alephobjects/taz-toolhead-javelin/photos/test pandas/DSC_0005.JPG

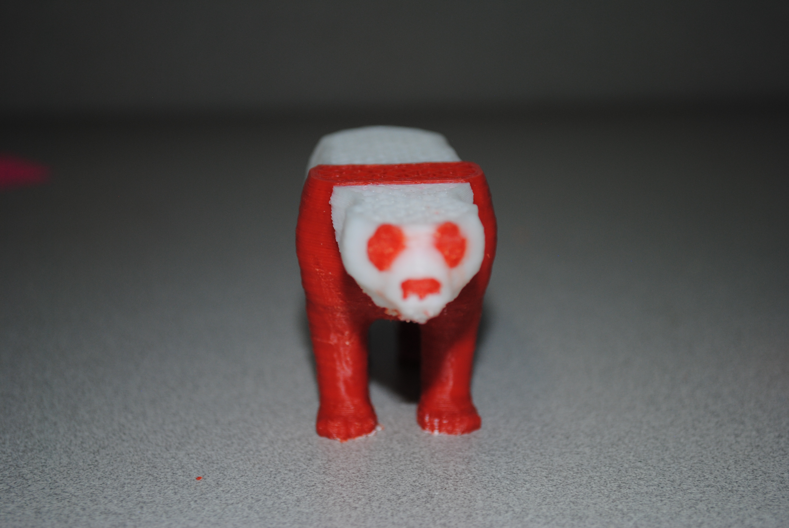
photos/test pandas/DSC_0005.JPG
