alephobjects/taz-toolhead-javelin/photos/Test die/DSC_0011.JPG

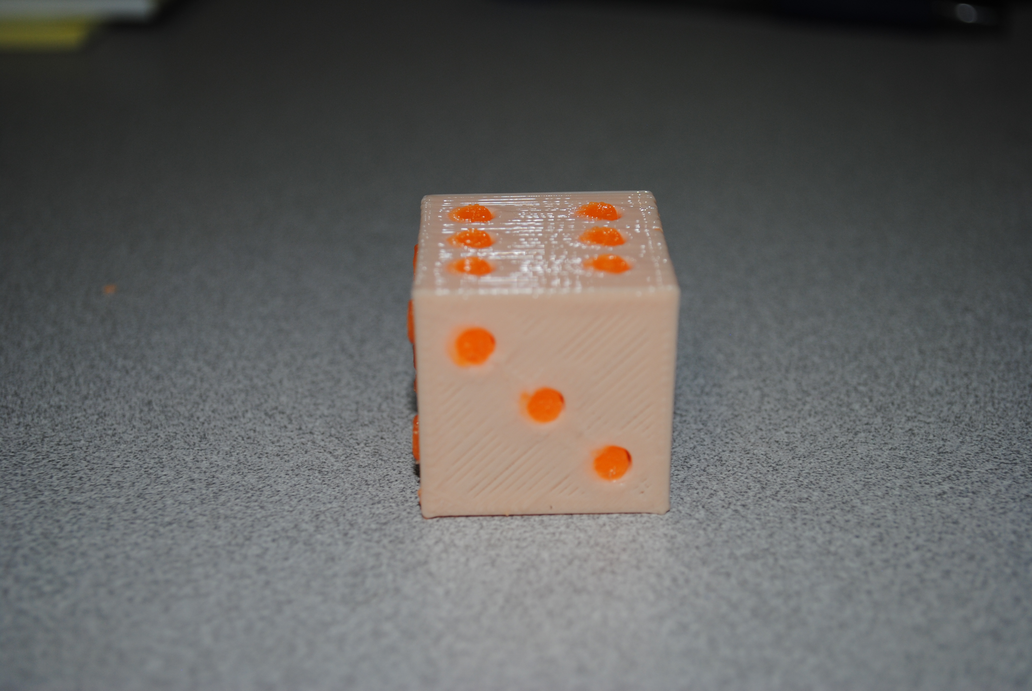
photos/Test die/DSC_0011.JPG
