alephobjects/taz-toolhead-javelin/production_docs/harnesses/wire_harness_listing.odt

- Blower harness
  - Cut blower wires to 50mm
  - Cut heat shrink to 20mm
  - Black and red 24ga wires cut to 230mm
- fan harness
  - Cut fan wires to 50mm
  - Cut heat shrink to 20mm
  - Black and red 24ga wires cut to 185mm
- Hexagon wiring
  - 24V cartridge
    - 225mm
  - Thermistor
    - 215mm
- motor wire lengths
  - Cut both half height motors to 130mm
  - Cover with shielding cut to 120mm
- Panduit Lengths
  - 2x 1/4” panduit cut to 170mm
- Juniperberry cable harness
