alephobjects/taz-toolhead-javelin/photos/2_color_octo/IMG_0299.JPG

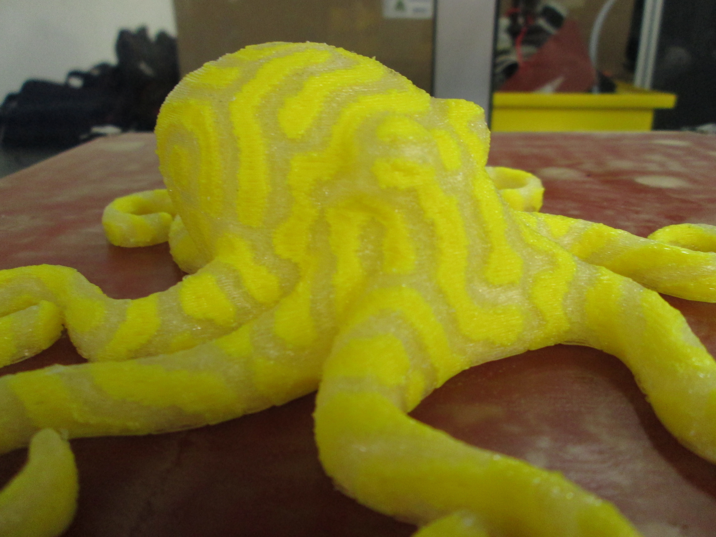
photos/2_color_octo/IMG_0299.JPG
