alephobjects/taz-toolhead-javelin/photos/2_color_octo/IMG_0300.JPG

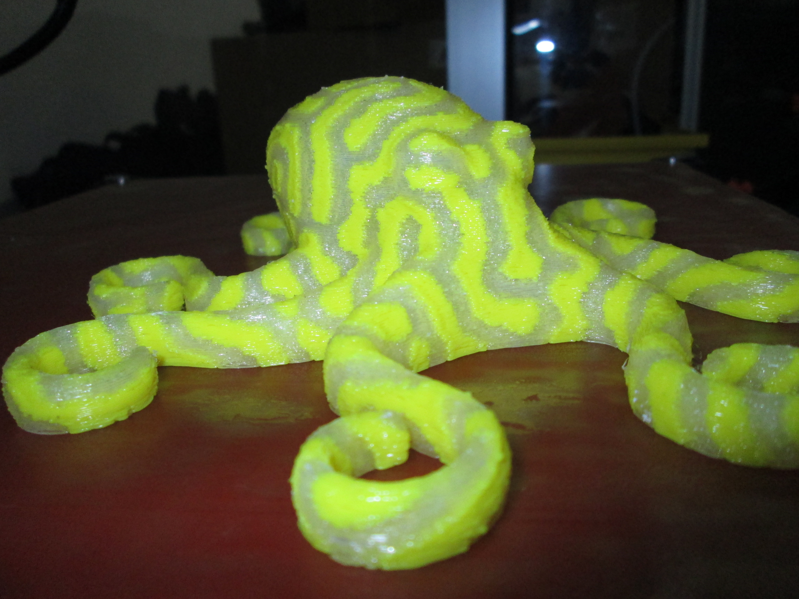
photos/2_color_octo/IMG_0300.JPG
