alephobjects/taz-toolhead-javelin/photos/2_color_octo/IMG_0301.JPG

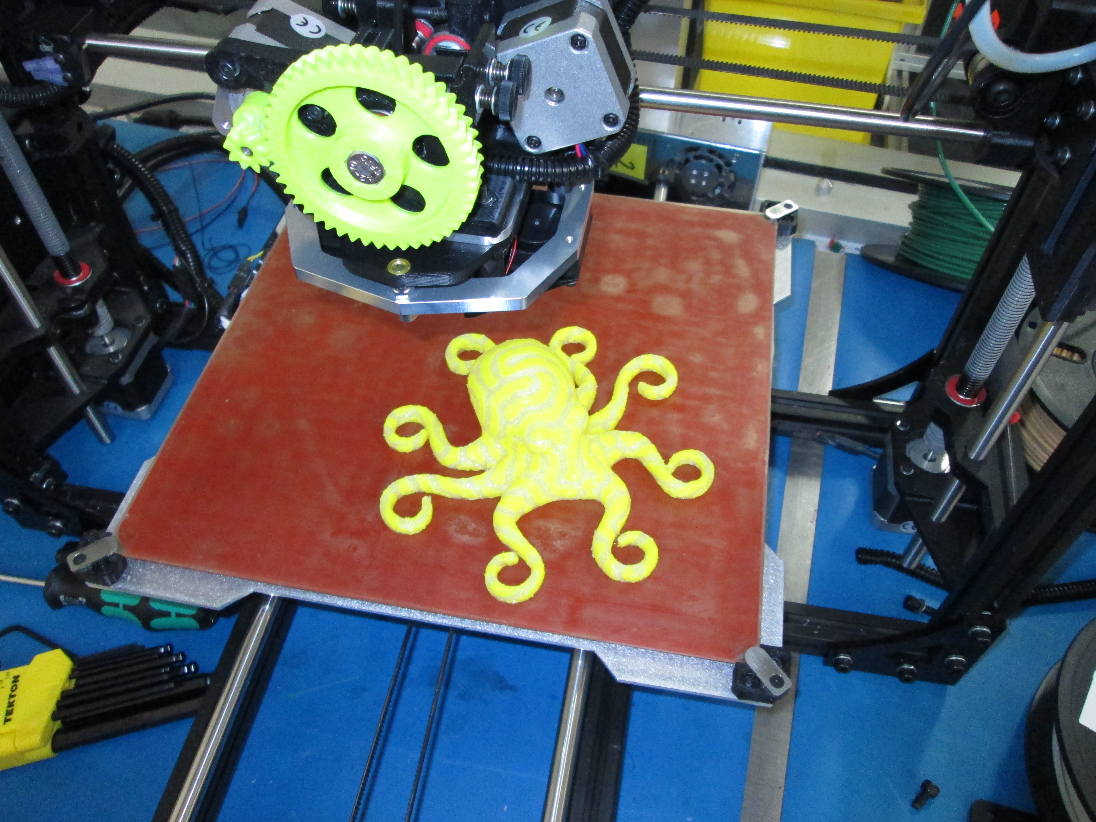
photos/2_color_octo/IMG_0301.JPG
