alephobjects/taz-toolhead-javelin/photos/bunny_in_egg/IMG_0385.JPG

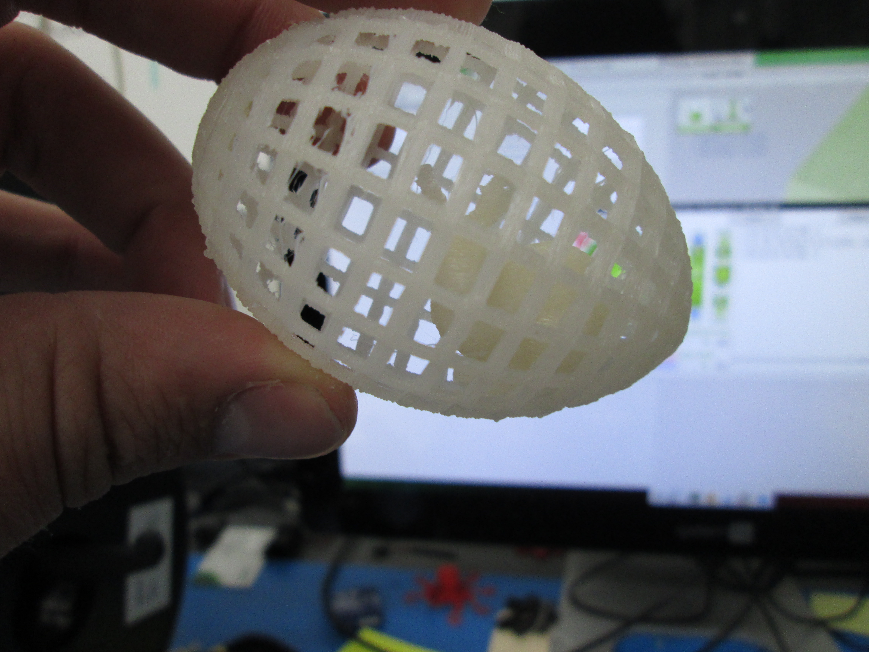
photos/bunny_in_egg/IMG_0385.JPG
