alephobjects/taz-toolhead-javelin/photos/gyroid/IMG_0386.JPG

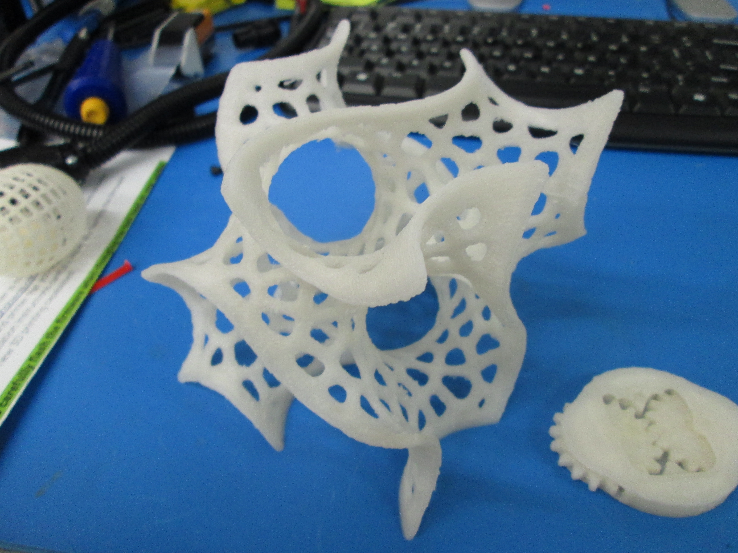
photos/gyroid/IMG_0386.JPG
