alephobjects/taz-toolhead-javelin/photos/misc/IMG_0377.JPG

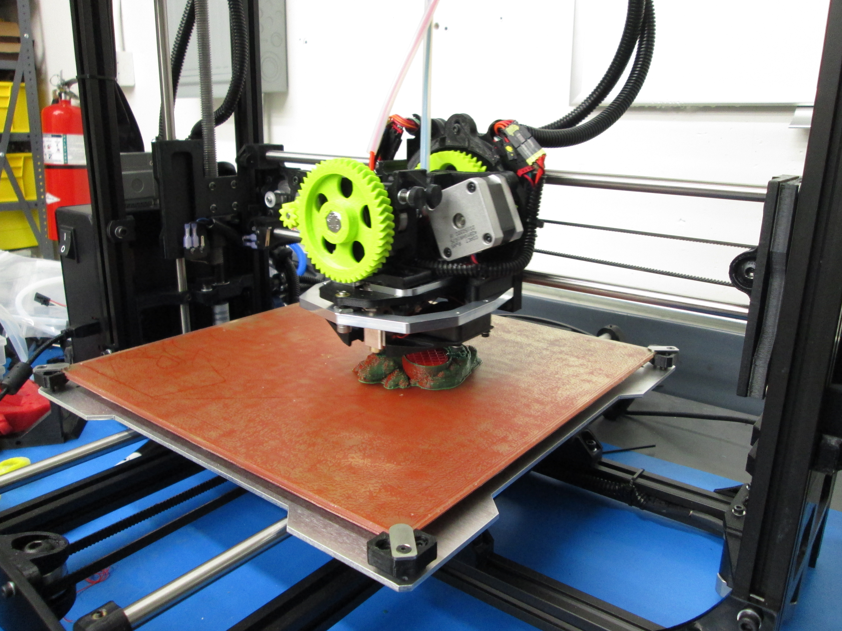
photos/misc/IMG_0377.JPG
