alephobjects/taz-toolhead-javelin/photos/velociraptor_skull/IMG_0378.JPG

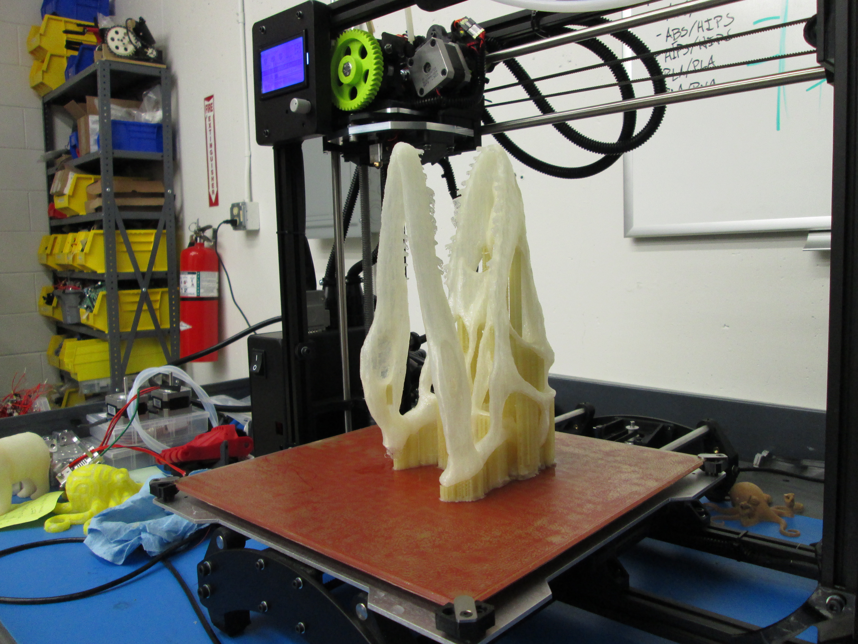
photos/velociraptor_skull/IMG_0378.JPG
