alephobjects/taz-toolhead-javelin/photos/velociraptor_skull/IMG_0380.JPG

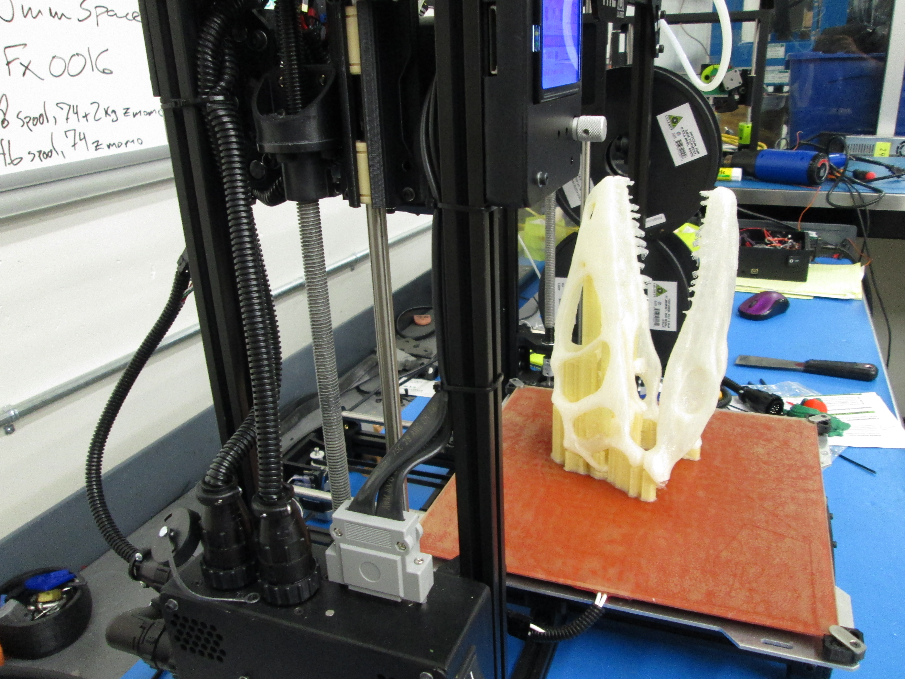
photos/velociraptor_skull/IMG_0380.JPG
