alephobjects/taz-toolhead-javelin/photos/velociraptor_skull/IMG_0381.JPG

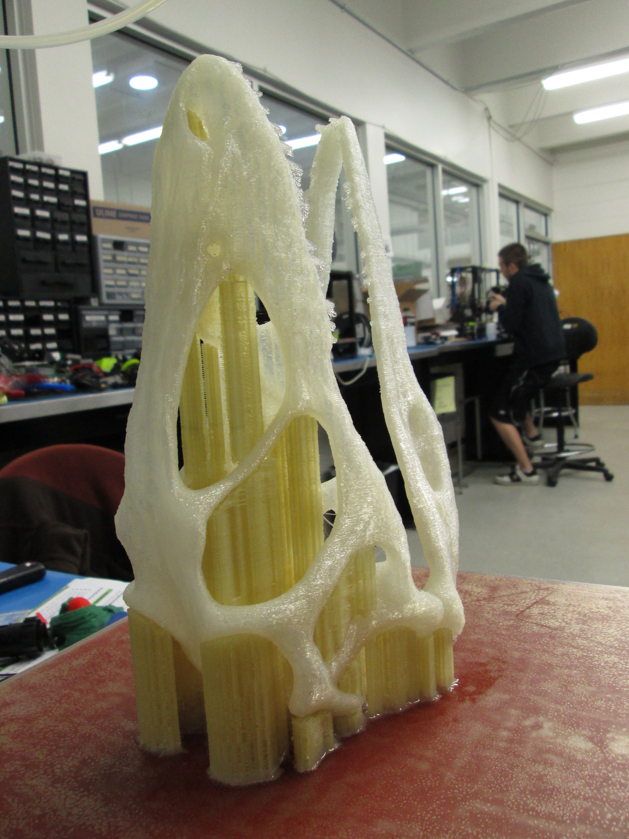
photos/velociraptor_skull/IMG_0381.JPG
