alephobjects/taz-toolhead-javelin/photos/velociraptor_skull/IMG_0382.JPG

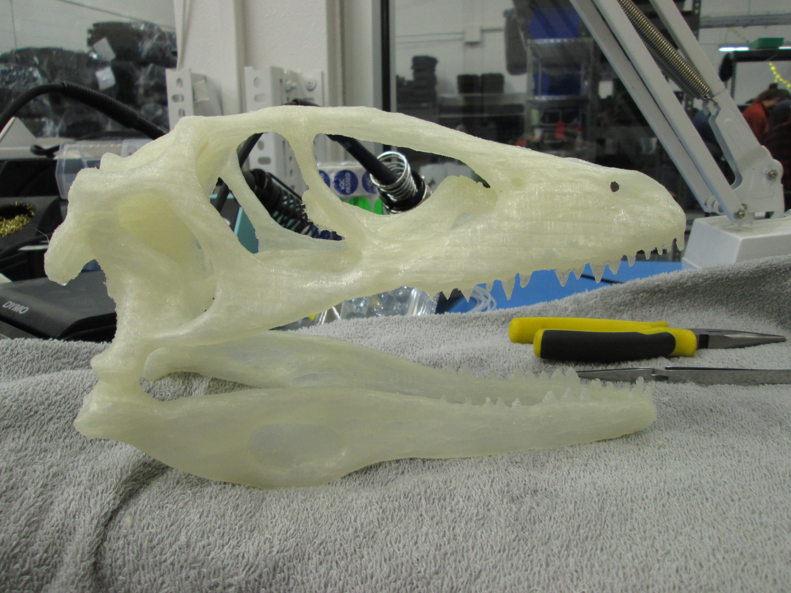
photos/velociraptor_skull/IMG_0382.JPG
