alephobjects/taz-toolhead-javelin/photos/velociraptor_skull/IMG_0383.JPG

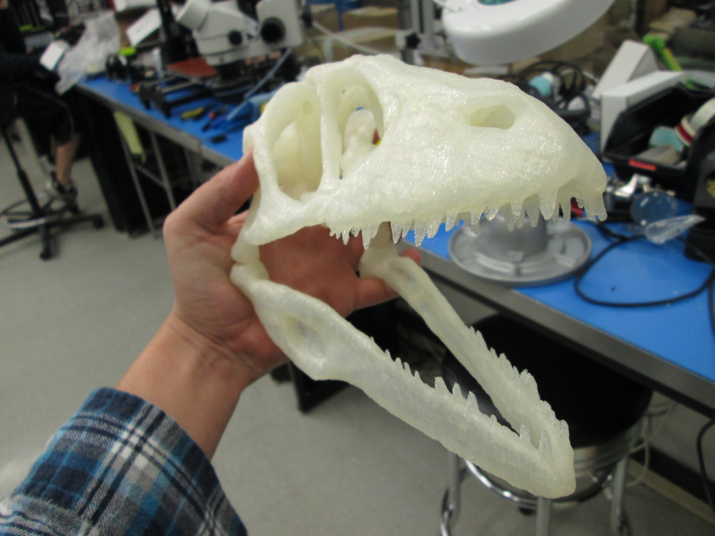
photos/velociraptor_skull/IMG_0383.JPG
