alephobjects/taz-toolhead-javelin/photos/velociraptor_skull/IMG_0384.JPG

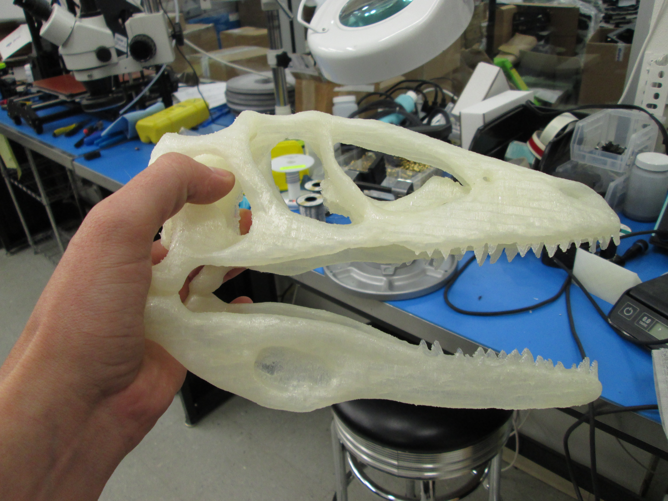
photos/velociraptor_skull/IMG_0384.JPG
