alephobjects/taz-toolhead-javelin/production_docs/javelin_v2.0D_BOM_MO16-0056.ods

Sheet: BOM - Eval
 |  |  |  | QTY TO BUILD |  | 500 |  |  | Qty to order
Category | AO Part # | Part Name | Manufacturer | Mfr. PN | Distributor | MFR PN | Qty | UOM |  | Cost Each | Cost per Dual | Cost Total | PO | Date | ETA |  |  | Notes
Printed | PP-GP0197 | dual_extruder_2.0_mount_v1.0 | Aleph Objects |  | Aleph Objects |  | 1 | ea | 500 | $1.00 | $1.00 | $500.00
Printed | PP-GP0198 | javelin_flex_plate_v1.2 | Aleph Objects |  | Aleph Objects |  | 1 | ea | 500 | $1.00 | $1.00 | $500.00
Printed | PP-GP0199 | 40mm_fan_duct__for_dual_v0.3 | Aleph Objects |  | Aleph Objects |  | 2 | ea | 1000 | $1.00 | $2.00 | $1,000.00
Printed | PP-GP0186 | Wade extruder body for Hex nozzle v1.0 | Aleph Objects |  | Aleph Objects |  | 2 | ea | 1000 | $3.790 | $7.58 | $3,790.00
Printed | PP-GP0193 | Wade Reloaded Idler Block v1.4, Taz & Mini | Aleph Objects |  | Aleph Objects |  | 2 | ea | 1000 | $0.900 | $1.80 | $900.00
Printed | PP-GP0191 | Herringbone Large Gear v1.3, Lulzbot green | Aleph Objects |  | Aleph Objects |  | 2 | ea | 1000 | $2.230 | $4.46 | $2,230.00
Printed | PP-GP0091 | extruder_latch_v2.0 | Aleph Objects |  | Aleph Objects |  | 2 | ea | 1000 | $0.260 | $0.52 | $260.00
Printed | PP-GP0192 | Herringbone Small Gear v1.1, Lulzbot green | Aleph Objects |  | Aleph Objects |  | 2 | ea | 1000 | $0.290 | $0.58 | $290.00
Printed | PP-GP0060 | Wade Reloaded Bearing Washer | Aleph Objects |  | Aleph Objects |  | 2 | ea | 1000 | $0.020 | $0.04 | $20.00
Printed | PP-GP0109 | Spool Arm, TAZ | Aleph Objects |  | Aleph Objects |  | 1 | ea | 500 | $1.99 | $1.99 | $992.79
Printed | PP-GP0074 | feed_tube spinner | Aleph Objects |  | Aleph Objects |  | 1 | ea | 500 | $0.07 | $0.07 | $34.09
Hardware | HD-MS0031 | Thumb Screw Knob for M4 SHCS, Black |  |  | Fastenal |  | 4 | ea | 2000 | $0.10 | $0.38 | $190.40 | PO12837 | 04/05/16 | 04/12/16
Hardware | HD-BT0052 | M4 x 55 Bolt, SHCS Black-Oxide |  |  | Fastenal | ZT2530055PF0000 | 4 | ea | 2000 | $0.08 | $0.31 | $156.40 | PO12837 | 04/05/16 | 04/12/16
Hardware | HD-NT0004 | M3 Nut, Zinc Plated |  |  | Fastenal | 40302 | 4 | ea | 2000 | $0.08 | $0.31 | $156.00 | PO12837 | 04/05/16 | 04/12/16
Hardware | HD-BT0012 | M3 Set Screw (Grub Screw) |  |  | Fastenal | 40818 | 2 | ea | 1000 | $0.02 | $0.04 | $18.00 | PO12837 | 04/05/16 | 04/12/16
Hardware | HD-MS0030 | M3-.5 3.8mm Heatset Insert |  |  | C.E.H | 11125995 | 4 | ea | 2000 | $0.04 | $0.14 | $72.00 | PO12572 | 04/05/16 | 04/12/16
Hardware | HD-BT0039 | M3 x 12 Bolt, SHCS Black-Oxide |  |  | Fastenal | 1138525 | 6 | ea | 3000 | $0.02 | $0.10 | $48.00 | PO12837 | 04/05/16 | 04/12/16
Hardware | HD-BT0135 | M3 x 25 Bolt, FHCS Black-Oxide |  |  | Fastenal | 40929 | 2 | ea | 1000 | $0.03 | $0.07 | $32.50 | PO12837 | 04/05/16 | 04/12/16
Hardware | HD-BT0041 | M3 x 25 Bolt, SHCS Black-Oxide |  |  | Fastenal | 40929 | 4 | ea | 2000 | $0.03 | $0.13 | $65.00 | PO12837 | 04/05/16 | 04/12/16
Hardware | HD-WA0001 | M3 Washer, Steel, Zinc Plated |  |  | Fastenal | 40352 | 14 | ea | 7000 | $0.02 | $0.22 | $112.00 | PO12837 | 04/05/16 | 04/12/16
Hardware | HD-BT0046 | M4 x 16 Bolt, SHCS Black-Oxide |  |  | Fastenal |  | 4 | ea | 2000 | $0.09 | $0.37 | $184.20 | PO12837 | 04/05/16 | 04/12/16
Hardware | HD-WA0005 | M4 Washer |  |  | Fastenal | 40353 | 8 | ea | 4000 | $0.00 | $0.02 | $10.80 | PO12837 | 04/05/16 | 04/12/16
Hardware | HD-NT0011 | M4 Nut,Zinc-Plated Steel |  |  | Fastenal | 40303 | 8 | ea | 4000 | $0.00 | $0.04 | $18.40 | PO12837 | 04/05/16 | 04/12/16
Hardware | HD-BT0108 | Hobbed, M8 x 50 Bolt, 26mm offset |  |  | Quattro |  | 2 | ea | 1000 | $4.84 | $9.68 | $4,840.00 | PO12884 | 04/06/16 | 04/27/16
Hardware | HD-NT0002 | M8 Nyloc Nut, Zinc Plated |  |  | Fastenal | 40163 | 2 | ea | 1000 | $0.03 | $0.06 | $32.10 | PO12837 | 04/05/16 | 04/12/16
Hardware | HD-WA0008 | M8 shim washer - .5mm |  |  | Fastenal |  | 2 | ea | 1000 | $0.05 | $0.10 | $50.00 | PO12837 | 04/05/16 | 04/12/16
Hardware | HD-WA0009 | M8 shim washer – 1.0mm |  |  | Fastenal |  | 2 | ea | 1000 | $0.06 | $0.12 | $60.00 | PO12837 | 04/05/16 | 04/12/16
Hardware | HD-WA0006 | M8 Washer, Steel, Zinc Plated |  |  | Fastenal |  | 6 | ea | 3000 | $0.01 | $0.08 | $42.00 | PO12837 | 04/05/16 | 04/12/16
Hardware | HD-BT0104 | M3 x 8 BHCS, Stainless |  |  | Fastenal | MB2510008A20000 | 3 | ea | 1500 | $0.088 | $0.26 | $132.30 | PO12837 | 04/05/16 | 04/12/16
Hardware | HD-BT0119 | M3 x 8 FHCS, black oxide |  |  | Fastenal | 91294A128 | 4 | ea | 2000 | $0.04 | $0.17 | $86.00 | PO12837 | 04/05/16 | 04/12/16
Hardware | HD-BT0007 | M3 x 20 SCHS, black-oxide |  |  | Fastenal | 91290A123 | 4 | ea | 2000 | $0.10 | $0.39 | $194.00 | PO12837 | 04/05/16 | 04/12/16
Hardware | HD-MS0230 | M2 x 6mm SCHS, black-oxide |  |  | Fastenal | 134596 | 2 | ea | 1000 | $0.03 | $0.06 | $28.20 | PO12837 | 04/05/16 | 04/12/16
Hardware | HD-NT0015 | M5 nylon insert hex nut |  |  | Timberline |  | 1 | ea | 500 | $0.15 | $0.15 | $75.00 | PO08409 | 07/22/15 | 07/28/15 | received
Hardware | HD-NT0016 | M5 Nut, Steel, Zinc Plated, thin (jam nut) |  |  | Fastenal | 90695A037 | 1 | ea | 500 | $0.15 | $0.15 | $75.00 | PO12837 | 04/05/16 | 04/12/16
Mechanical | HD-MS0282 | 608-2RS ABEC3/C3 Rubber Sealed Bearing – BLACK |  |  | JSB |  | 6 | ea | 3000 | $0.42 | $2.52 | $1,260.00 | PO12542 | 03/16/16 | 03/29/16 | Ordered with Uaru, Brambling, Kanyu Albatross
Hardware | HD-MS0158 | M5-.8 6.7mm Heatset Insert |  |  | C.E.H. | 11125997 | 1 | ea | 500 | $0.15 | $0.15 | $74.70 | PO12572 | 04/05/16 | 04/15/16
Hardware | HD-BT0153 | M5 X 20 SCHS, Stainless |  |  | Fastenal | 92290A242 | 1 | ea | 500 | $0.05 | $0.05 | $23.90 | PO12837 | 04/05/16 | 04/12/16
Hardware | HD-BT0073 | M5 x 10mm BHCS, black-oxide |  |  | Fastenal | 1139905 | 1 | ea | 500 | $0.02 |  | $8.30 | PO12837 | 04/05/16 | 04/12/16
Hardware | HD-BT0049 | M5 x 14 Bolt, SHCS Black_Oxide |  |  | Fastenal | 1139539 | 1 | ea | 500 | $0.02 | $0.02 | $11.45 | PO12837 | 04/05/16 | 04/12/16
Hardware | HD-MS0027 | Spring, Extruder, 6mm OD, 0.8mm WD, 9.7mm FL |  |  | Associated Spring | C0240-032-0380-M | 4 | ea | 2000 | $0.22 | $0.88 | $440.00 | PO12069 | 02/16/16 | 03/05/16 | Ordered on PO12069 with Uaru, Brambling
Mechanical | HD-RD0004 | 8mm Smooth Rod x 18-19mm |  |  | IGUS |  | 2 | ea | 1000 | $1.50 | $3.00 | $1,500.00 | PO12857 | 04/05/16 | 04/19/16
Mechanical | HE-SH0031 | Reprap Modified Hexagon Hotend, Lulzbot Edition, 3.0mm Filament, .5mm Nozzle | RepRapDiscount |  | RepRapDiscount |  | 2 | ea | 1000 | $23.00 | $46.00 | $23,000.00
Hardware | HD-MS0062 | Metric Aluminum Unthreaded Spacer, 8MM OD, 8MM Length, M5 Screw Size |  |  | Fastenal |  | 1 | ea | 500 | $0.169 | $0.17 | $84.25 | PO12837 | 04/05/16 | 04/12/16
Hardware | HD-TB0007 | Feed Tube, PTFE |  |  | Professional Plastics | 5239K12 | 850 | mm | 425000 | $0.01 | $4.71 | $2,356.46
Hardware | HD-WA0007 | M5 Washer, Steel, Zinc Plated |  |  | Fastenal | 1140354 | 2 | ea | 1000 | $0.00 | $0.01 | $3.00 | PO12837 | 04/05/16 | 04/12/16
Hardware | HD-MS0059 | Standard Nylon Cable Tie 7-1/2" L, 1-7/8" Bundle Dia, 50#Tensile Strg, Black |  |  | Fastenal |  | 12 | ea | 6000 | $0.02 | $0.28 | $139.20 | PO12837 | 04/05/16 | 04/12/16
Hardware | HD-NT0044 | Post insertion M5 T-nut for 20mm extrusion | Post assembly M5 T-nut |  | Misumi | HN-TAP5 | 1 | ea | 500 | $0.46 | $0.46 | $230.00 |  |  |  | BAM confirmed this is still needed on this Javelin BOM
Mechanical | PP-MP0085 | Bed finger, Dual |  |  | MBK |  | 4 | ea | 2000 | $3.00 | $12.00 | $6,000.00 | PO12858 | 04/06/16 | 05/04/16 | Lead time 3-4 wks ARO
Mechanical | PP-MP0087 | Dual extruder v2.0 mount |  |  | MBK |  | 1 | ea | 500 | $7.80 | $7.80 | $3,900.00 | PO12858 | 04/06/16 | 05/04/16 | Lead time 3-4 wks ARO
Mechanical | PP-MP0086 | Lower bracket, Dual |  |  | MBK |  | 1 | ea | 500 | $9.90 | $9.90 | $4,950.00 | PO12858 | 04/06/16 | 05/04/16 | Lead time 3-4 wks ARO
Electronic | EL-FA0011 | FAN,24VDC,Sleeve,5.75CFM,40X40X10MM,60mA 6000RPM,1.44W,280MM LEADS,CE/RoHS |  |  | Kysan | TF4010-24H-S | 0 | ea | 0 | $1.45 |  | $0.00 | PO08435 | 07/10/15 | 07/28/15
Electronic | EL-FA0020 | RFB2008 Micro Blower with 30awg wire that is 250mm long |  |  | Pelonis |  | 2 | ea | 1000 | $6.54 | $13.08 | $6,540.00 | See notes |  |  | In stock do not need to order. TS
Electronic | EL-FA0032 | Pelonis FAN 24V 40x40mm Low flow | Pelonis | C4010L24BPLB1-7 | Pelonis | C4010L24BPLB1-7 | 2 | ea | 1000 | 3.13 | $6.26 | $3,130.00 | PO12883 | 04/07/16 | 05/04/16 | We do need to order per Toni 4/6/16.Pelonis fan to replace the kysan fan – only for replacement toolheads, the rest of juniperbush will have the above kysan | 40mm fans switched from kysan to pelonis
Electronic | EL-MS0014 | Wire ferrules – 1.5mm^2 – 7mm |  |  | Mcmaster | 9681K21 | 4 | ea | 2000 | $0.06 | $0.25 | $126.00
Electronic | EL-MS0073 | 1/4” Black panduit wire wrap |  |  | Electronics Distributor Corp |  | 300 | mm | 150000 | $0.00 | $0.30 | $150.00
Electronic | EL-MT0017 | Half Height NEMA 17 Stepper Motor |  |  | Changzhou FTX | SY42STH33-1504A | 2 | ea | 1000 | $5.35 | $10.70 | $5,350.00 |  |  |  | Need to order ASAP, there is a long lead time on these from FTX. We are still using FTX for the Half Height.
Electronic | EL-MS0247 | Heat shrink – 0.19-0.09 – Black | EDC | 88-01870 | Mcmaster-Carr Supply Company | 7856K74 | 250 | mm | 125000 | $0.00 | $0.72 | $362.20
Electronic | EL-MS0247 | Heat Shrink Tubing – 0.19-0.09 – Black, 100' |  |  | Electronics Distributor Corp | 88-01870 | 0 | mm | 0 | $0.00 |  |  |  |  |  | 329' |  | This is the replacement unshielded heatshrink (see below)
Electronic | TL-CS0083 | EMI/RFI-Shield Heat-Shrink Tubing 3/16" ID Before, 3/32" ID After, 48" L, Black, cut to 50mm |  |  | Allcable | 7937K31 | 0 | mm | 0 | $0.01 |  | $0.00 | PO08449 | 07/10/15 | 07/20/15 | received |  | shielded heatshrink dropped in favor of unshielded (EL-MS0247)
Electronic | EL-MS0061 | Conn Housing Male 4POS .100 |  |  | Digikey | WM2535-ND | 5 | pcs | 2500 | $0.40 | $2.00 | $1,000.00
 | EL-MS0058 | CONN PIN 24-30AWG CRIMP TIN |  | 16020105 | TTI | WM2565CT-ND | 21 | pcs | 10500 | $0.15 | $1.89 | $1,575.00 |  |  |  | ?
Electronic | EL-MS0210 | CONN RING UNINS 15-20AWG #M3 |  | 160344-2 | Digikey / TTI | A107160CT-ND | 1 | ea | 500 | $0.09 | $0.09 | $45.00 |  |  |  | EL-MS0246
Electronic | EL-WR0040 | Wire - Single Conductor 20AWG SOLID PTFE, RED |  |  | Mouser / Allcable | 602-2856/1-100-03 | 200 | mm | 100000 | $0.00 | $0.78 | $388.45 |  |  |  | 329'
Hardware | HD-WA0035 | Metric 18-8 Stainless Steel External Serrated Lock Washer, M3 Screw Size, 6mm OD, 0.4mm min Thick |  | 11511313 | Fastenal | 91120A120 | 1 | ea | 500 | $0.020 | $0.02 | $9.75 | PO12837 | 04/05/16 | 04/12/16
Consumable | TO-CS0107 | Loctite® 262™ Threadlocker High Strength 50ML Bottle |  |  | Uline | S-15893 | 0.25 | g | $0.90 | $0.22 | 125 |  |  |  | Hold per toni
Consumable | TL-CS0040 | Extreme-Temperature Pipe Sealant & Threadlocker, 4 oz bottle, blue |  |  | Mcmaster | 7604A55 | 0.5 | g | 250 | $0.066 | $0.03 | $16.62 | See notes |  |  | ordered when Bob signals us
 | EL-MS0139 | 3/8” Corrugated Wrap-Around Sleeving |  |  | Electronics Distributor Corp |  | 975 | mm | 487500 | $0.00 | $0.00 | $1.57 |  |  |  |  |  | 3800 ft confirmed
 | EL-WR0099 | Shielded 22AWG UL2464 4 Cond |  |  | Allcable |  | 1000 | mm | 500000 | $0.001 | $1.01 | $505.25
 | EL-MS0062 | CONN Housing 4 POS .100 W/ latch |  |  |  |  | 0 | ea | 0 | $0.062 | $0.00 | $0.00
 | EL-MS0131 | CONN, PLUG, 14 POS |  |  | Sager |  | 1 | ea | 500 | $2.256 | $2.26 | $1,128.00
 | EL-MS0129 | CONN Cable clamp CPC size 17 black |  | 20607-8 | TTI |  | 1 | ea | 500 | $2.180 | $2.18 | $1,090.00
 | PC-CN0001 | CONN Housing 2 POS .100 W/ latch |  | 50579402 | Sager |  | 1 | ea | 500 | $0.053 | $0.05 | $26.25 |  |  |  |  |  | confirmed
 | EL-MS0124 | 20-24 AWG Sockets for Receptacle |  |  | TTI |  | 2 | ea | 1000 | $0.208 | $0.42 | $208.00 |  |  |  | 4000 reel
 | EL-MS0251 | CONN HOUSING 16POS .100 DUAL | Molex | 22552161 | TTI | WM2525-ND | 5 | ea | 2500 | $0.529 | $2.65 | $1,322.50 |  |  |  |  |  | ordered 13K, 5400 deliver 7/23 balance 7600 aprox 6 wks ~9/4
 | EL-MS0059 | CONN TERM Female 22-24AWG |  |  | TTI |  | 22 | ea | 11000 | $0.016 | $0.35 | $176.00
 | EL-MS0123 | CONN PIN 0.062 24-26 AWG Tin Crimp |  | 1-66106-5 | TTI |  | 23 | ea | 11500 | $0.200 | $4.60 | $2,300.00 | PO12852 | 04/05/16 | 04/06/16 | ea |  | will deliver 8/4
Electronic | EL-MS0061 | Conn Housing Male 4POS .100 |  |  | HEILIND Digikey | WM2535-ND | 2 | pcs | 1000 | $0.13 | $0.26 | $130.00
Electronic | EL-WR0103 | 24 AWG Red wire |  |  | Allcable | C2065R-1000-ND | 4590 | mm | 2295000 | $0.000 | $0.35 | $173.18
Electronic | EL-WR0123 | 16AWG Stranded – White | C2065A.21.02 |  | Allcable | C2065W-1000-ND | 50 | mm | 25000 | $0.000 | $0.00 | $1.89
Electronic | EL-WR0105 | 24 AWG Black Wire |  |  | Allcable | C2065B-1000-ND | 2490 | mm | 1245000 | $0.000 | $0.19 | $93.95
Electronic | EL-WR0119 | 24AWG Stranded – Green | C2015A.21.06 |  | Allcable | C2015G-1000-ND | 50 | mm | 25000 | $0.000 | $0.00 | $1.89
Electronic | EL-WR0104 | 24AWG Orange wire |  |  | Allcable | C2015A-1000-ND | 2100 | mm | 1050000 | $0.000 | $0.16 | $79.23
Shipping | SH-PG0063 | 8 x 7 x 6" Indestructo Mailers 100/800 |  |  | Uline | S-15087 | 1 | ea | 500 | $1.08 | $1.08
Shipping | SH-PA0019 | Bubble 1/8x48x750 perf 12" slit 2-24" rolls |  |  | Shipper Supply |  | 2 | sheet | 1000 | $0.15 | $0.30
Shipping | SH-PG0004 | 8 x 8" 2 Mil Reclosable Polypropylene Bags |  |  | Uline | S-1699 | 1 | ea | 500 | $0.06 | $0.06
Shipping | SH-PA0039 | Roll of 48"x1/4" Thick Foam, Split at 12" - 225 feet Per Roll |  |  | Shipper Supply |  | 0.0011111111 | ea | 1
Label | DC-LB0072 | Label, LulzBot TAZ Dual Extruder Tool Head v2c, 0.5 Nozzle, Front |  |  | Sticker Giant |  | 1 | ea | 500 | $0.10 | $0.10
Label | DC-LB0073 | Label, LulzBot TAZ Dual Extruder Tool Head v2c, 0.5 Nozzle, Back |  |  | Sticker Giant |  | 1 | ea | 500 | $0.10 | $0.10
Documentation | DC-MS0047 | v2 Tool Head Instruction Card |  |  |  |  | 1 | ea
Sample | RM-AB0082 | Black ABS 3mm Filament, 5lb Reel |  |  | Village |  | 0.0066 | ea | $49.00 | $0.32
Sample | RM-AB0096 | LulzBot Green ABS 3mm Filament, 5lb Reel |  |  | Village |  | 0.0066 | ea | $56.50 | $0.37
Label | DC-LB0083 | LulzBot TAZ Dual Extruder v2 Serial Number Label |  |  |  |  | 1 | ea
Documentation | DC-MS0054 | Firmware Update Warning Cards |  |  | The print shop of Loveland |  | 1 | ea | 500 | $0.17 |  |  | PO12853 | 04/05/16 | 04/07/16
 |  | New
 |  | not used anymore
 |  | wrong
 |  | new |  |  |  |  |  |  |  | Dual Extruder BOM cost | $299.59 | $82,594.29
 |  | Kim needs to order as soon as possible.

Sheet: 08.04.16-BOM-Order
 |  |  |  | QTY TO BUILD |  | 1000
Category | AO Part # | Part Name | Manufacturer | Mfr. PN | Distributor | MFR PN | Qty | UOM | Cost Each | Cost per Dual | qty to order | PO | Date | ETA | Notes
 |  |  |  |  |  |  |  |  |  |  | 1015
Printed | PP-GP0197 | dual_extruder_2.0_mount_v1.0 | Aleph Objects |  | Aleph Objects |  | 1 | ea | $1.00 | $1.00 | 1015 | N/A | 08/23/16 |  | created cluster task: Parts needed for Javelin x 1015 - TAZ Dual Extruder v2 (MO16-0056 & MO16-0061)
Printed | PP-GP0198 | javelin_flex_plate_v1.2 | Aleph Objects |  | Aleph Objects |  | 1 | ea | $1.00 | $1.00 | 1015 | N/A | 08/23/16 |  | created cluster task: Parts needed for Javelin x 1015 - TAZ Dual Extruder v2 (MO16-0056 & MO16-0061)
Printed | PP-GP0199 | 40mm_fan_duct__for_dual_v0.3 | Aleph Objects |  | Aleph Objects |  | 2 | ea | $1.00 | $2.00 | 2030 | N/A | 08/23/16 |  | created cluster task: Parts needed for Javelin x 1015 - TAZ Dual Extruder v2 (MO16-0056 & MO16-0061)
Printed | PP-GP0186 | Wade extruder body for Hex nozzle v1.0 | Aleph Objects |  | Aleph Objects |  | 2 | ea | $3.790 | $7.58 | 2030 | N/A | 08/23/16 |  | created cluster task: Parts needed for Javelin x 1015 - TAZ Dual Extruder v2 (MO16-0056 & MO16-0061)
Printed | PP-GP0193 | Wade Reloaded Idler Block v1.4, Taz & Mini | Aleph Objects |  | Aleph Objects |  | 2 | ea | $0.900 | $1.80 | 2030 | N/A | 08/23/16 |  | created cluster task: Parts needed for Javelin x 1015 - TAZ Dual Extruder v2 (MO16-0056 & MO16-0061)
Printed | PP-GP0191 | Herringbone Large Gear v1.3, Lulzbot green | Aleph Objects |  | Aleph Objects |  | 2 | ea | $2.230 | $4.46 | 2030 | N/A | 08/23/16 |  | created cluster task: Parts needed for Javelin x 1015 - TAZ Dual Extruder v2 (MO16-0056 & MO16-0061)
Printed | PP-GP0091 | extruder_latch_v2.0 | Aleph Objects |  | Aleph Objects |  | 2 | ea | $0.260 | $0.52 | 2030 | N/A | 08/23/16 |  | created cluster task: Parts needed for Javelin x 1015 - TAZ Dual Extruder v2 (MO16-0056 & MO16-0061)
Printed | PP-GP0192 | Herringbone Small Gear v1.1, Lulzbot green | Aleph Objects |  | Aleph Objects |  | 2 | ea | $0.290 | $0.58 | 2030 | N/A | 08/23/16 |  | created cluster task: Parts needed for Javelin x 1015 - TAZ Dual Extruder v2 (MO16-0056 & MO16-0061)
Printed | PP-GP0060 | Wade Reloaded Bearing Washer | Aleph Objects |  | Aleph Objects |  | 2 | ea | $0.020 | $0.04 | 2030 | N/A | 08/23/16 |  | created cluster task: Parts needed for Javelin x 1015 - TAZ Dual Extruder v2 (MO16-0056 & MO16-0061)
Printed | PP-GP0109 | Spool Arm, TAZ | Aleph Objects |  | Aleph Objects |  | 1 | ea | $1.99 | $1.99 | 1015 | N/A | 08/23/16 |  | created cluster task: Parts needed for Javelin x 1015 - TAZ Dual Extruder v2 (MO16-0056 & MO16-0061)
Printed | PP-GP0074 | feed_tube spinner | Aleph Objects |  | Aleph Objects |  | 1 | ea | $0.07 | $0.07 | 1015 | N/A | 08/23/16 |  | created cluster task: Parts needed for Javelin x 1015 - TAZ Dual Extruder v2 (MO16-0056 & MO16-0061)
Hardware | HD-MS0031 | Thumb Screw Knob for M4 SHCS, Black | Fastenal | 11102951 | Fastenal | 11102951 | 4 | ea | $0.08 | $0.33 | 4060 | PO15128 | 08/17/16 | 08/22/16 | Combining MO16-0056, MO16-0057, MO16-0061, and MO16-0062 ~AS
Hardware | HD-BT0052 | M4 x 55 Bolt, SHCS Black-Oxide | Fastenal | ZT2530055PF0000 | Fastenal | ZT2530055PF0000 | 4 | ea | $0.08 | $0.31 | 4060 | PO15128 | 08/17/16 | 08/22/16 | Combining MO16-0056, MO16-0057, MO16-0061, and MO16-0062 ~AS
Hardware | HD-NT0004 | M3 Nut, Zinc Plated | Fastenal | 40302 | Fastenal | 40302 | 4 | ea | $0.01 | $0.02 | 4060 | PO15128 | 08/17/16 | 08/22/16 | Combining MO16-0056, MO16-0057, MO16-0061, and MO16-0062 ~AS
Hardware | HD-BT0012 | M3 Set Screw (Grub Screw) | Fastenal | 40818 | Fastenal | 40818 | 2 | ea | $0.02 | $0.04 | 2030 | PO15128 | 08/17/16 | 08/22/16 | Combining MO16-0056, MO16-0057, MO16-0061, and MO16-0062 ~AS
Hardware | HD-BT0039 | M3 x 12 Bolt, SHCS Black-Oxide | Fastenal | 1138525 | Fastenal | 1138525 | 6 | ea | $0.03 | $0.17 | 6090 | PO15128 | 08/17/16 | 08/22/16 | Combining MO16-0056, MO16-0057, MO16-0061, and MO16-0062 ~AS
Hardware | HD-BT0135 | M3 x 25 Bolt, FHCS Black-Oxide | Fastenal | 40929 | Fastenal | 40929 | 2 | ea | $0.03 | $0.07 | 2030 | PO15128 | 08/17/16 | 08/22/16 | Combining MO16-0056, MO16-0057, MO16-0061, and MO16-0062 ~AS
Hardware | HD-BT0041 | M3 x 25 Bolt, SHCS Black-Oxide | Fastenal | 40929 | Fastenal | 40929 | 4 | ea | $0.03 | $0.11 | 4060 | PO15128 | 08/17/16 | 08/22/16 | Combining MO16-0056, MO16-0057, MO16-0061, and MO16-0062 ~AS
Hardware | HD-WA0001 | M3 Washer, Steel, Zinc Plated | Fastenal | 40352 | Fastenal | 40352 | 14 | ea | $0.00 | $0.02 | 14210 | PO15128 | 08/17/16 | 08/22/16 | Combining MO16-0056, MO16-0057, MO16-0061, and MO16-0062 ~AS
Hardware | HD-BT0046 | M4 x 16 Bolt, SHCS Black-Oxide | Fastenal | 39526 | Fastenal | 39526 | 4 | ea | $0.07 | $0.27 | 4060 | PO15128 | 08/17/16 | 08/22/16 | Combining MO16-0056, MO16-0057, MO16-0061, and MO16-0062 ~AS
Hardware | HD-WA0005 | M4 Washer | Fastenal | 40353 | Fastenal | 40353 | 8 | ea | $0.00 | $0.02 | 8120 | PO15128 | 08/17/16 | 08/22/16 | Combining MO16-0056, MO16-0057, MO16-0061, and MO16-0062 ~AS
Hardware | HD-NT0011 | M4 Nut,Zinc-Plated Steel | Fastenal | 40303 | Fastenal | 40303 | 8 | ea | $0.00 | $0.04 | 8120 | PO15128 | 08/17/16 | 08/22/16 | Combining MO16-0056, MO16-0057, MO16-0061, and MO16-0062 ~AS
Hardware | HD-NT0002 | M8 Nyloc Nut, Zinc Plated | Fastenal | 40163 | Fastenal | 40163 | 2 | ea | $0.03 | $0.06 | 2030 | PO15128 | 08/17/16 | 08/22/16 | Combining MO16-0056, MO16-0057, MO16-0061, and MO16-0062 ~AS
Hardware | HD-WA0008 | M8 shim washer - .5mm | Fastenal | 11511045 | Fastenal | 11511045 | 2 | ea | $0.05 | $0.10 | 2030 | PO15128 | 08/17/16 | 08/22/16 | Combining MO16-0056, MO16-0057, MO16-0061, and MO16-0062 ~AS
Hardware | HD-WA0009 | M8 shim washer – 1.0mm | Fastenal | 11511046 | Fastenal | 11511046 | 2 | ea | $0.05 | $0.10 | 2030 | PO15128 | 08/17/16 | 08/22/16 | Combining MO16-0056, MO16-0057, MO16-0061, and MO16-0062 ~AS
Hardware | HD-WA0006 | M8 Washer, Steel, Zinc Plated | Fastenal | 1140357 | Fastenal | 1140357 | 6 | ea | $0.01 | $0.06 | 6090 | PO15128 | 08/17/16 | 08/22/16 | Combining MO16-0056, MO16-0057, MO16-0061, and MO16-0062 ~AS
Hardware | HD-BT0104 | M3 x 8 BHCS, Stainless | Fastenal | MB2510008A20000 | Fastenal | MB2510008A20000 | 3 | ea | $0.088 | $0.26 | 3045 | PO15128 | 08/17/16 | 08/22/16 | Combining MO16-0056, MO16-0057, MO16-0061, and MO16-0062 ~AS
Hardware | HD-BT0007 | M3 x 20 SCHS, black-oxide | Fastenal | 91290A123 | Fastenal | 91290A123 | 4 | ea | $0.08 | $0.33 | 4060 | PO15128 | 08/17/16 | 08/22/16 | Combining MO16-0056, MO16-0057, MO16-0061, and MO16-0062 ~AS
Hardware | HD-MS0230 | M2 x 6mm SCHS, black-oxide | Fastenal | 134596 | Fastenal | 134596 | 2 | ea | $0.03 | $0.06 | 2030 | PO15128 | 08/17/16 | 08/22/16 | Combining MO16-0056, MO16-0057, MO16-0061, and MO16-0062 ~AS
Hardware | HD-BT0153 | M5 X 20 SCHS, Stainless | Fastenal | MS2540020A40000 | Mcmaster | 92290A242 | 1 | ea | $0.05 | $0.05 | 1015 | PO15128 | 08/17/16 | 08/22/16 | Combining MO16-0056, MO16-0057, MO16-0061, and MO16-0062 ~AS
Hardware | HD-BT0073 | M5 x 10mm BHCS, black-oxide | Fastenal | 1139905 | Fastenal | 1139905 | 1 | ea | $0.07 | $0.07 | 1015 | PO15128 | 08/17/16 | 08/22/16 | Combining MO16-0056, MO16-0057, MO16-0061, and MO16-0062 ~AS
Hardware | HD-BT0049 | M5 x 14 Bolt, SHCS Black_Oxide | Fastenal | 1139539 | Fastenal | 1139539 | 1 | ea | $0.02 | $0.02 | 1015 | PO15128 | 08/17/16 | 08/22/16 | Combining MO16-0056, MO16-0057, MO16-0061, and MO16-0062 ~AS
Hardware | HD-MS0062 | Metric Aluminum Unthreaded Spacer, 8MM OD, 8MM Length, M5 Screw Size | Fastenal | 11485208 | Fastenal | 11485208 | 1 | ea | $0.169 | $0.17 | 1015 | PO15128 | 08/17/16 | 08/22/16 | Combining MO16-0056, MO16-0057, MO16-0061, and MO16-0062 ~AS
Hardware | HD-WA0007 | M5 Washer, Steel, Zinc Plated | Fastenal | 1140354 | Fastenal | 1140354 | 2 | ea | $0.00 | $0.01 | 2030 | PO15128 | 08/17/16 | 08/22/16 | Combining MO16-0056, MO16-0057, MO16-0061, and MO16-0062 ~AS
Hardware | HD-WA0035 | Metric 18-8 Stainless Steel External Serrated Lock Washer, M3 Screw Size, 6mm OD, 0.4mm min Thick | Fastenal | 11511313 | Mcmaster | 91120A120 | 1 | ea | $0.018 | $0.02 | 1015 | PO15128 | 08/17/16 | 08/22/16 | Combining MO16-0056, MO16-0057, MO16-0061, and MO16-0062 ~AS
Mechanical | HD-MS0282 | 608-2RS ABEC3/C3 Rubber Sealed Bearing – BLACK | Just Great Bearings | 608-2RS ABEC3/C3 | Just Great Bearings | 608-2RS ABEC3/C3 | 6 | ea | $0.42 | $2.52 | 6090 | PO15120 | 08/17/16 | 09/12/16 | Combining MO16-0056, MO16-0057, MO16-0061, and MO16-0062 ~AS
Hardware | HD-MS0030 | M3-.5 3.8mm Heatset Insert | Colorado Electrical Hardware | 11125995 | Colorado Electrical Hardware | 11125995 | 4 | ea | $0.04 | $0.14 | 4060 | PO15122 | 08/17/16 | 09/07/16 | Combining MO16-0056, MO16-0057, MO16-0061, and MO16-0062 ~AS
Hardware | HD-MS0158 | M5-.8 6.7mm Heatset Insert | C.E.H. | 11125997 | C.E.H. | 11125997 | 1 | ea | $0.07 | $0.07 | 1015 | PO15122 | 08/17/16 | 09/07/16 | Combining MO16-0056, MO16-0057, MO16-0061, and MO16-0062 ~AS
Hardware | HD-MS0027 | Spring, Extruder, 6mm OD, 0.8mm WD, 9.7mm FL | Associated Spring | C0240-032-0380-M | Associated Spring | C0240-032-0380-M | 4 | ea | $0.22 | $0.88 | 4060 | PO15129 | 08/17/16 | 09/09/16 | Combining MO16-0056, MO16-0057, MO16-0061, and MO16-0062 ~AS
Mechanical | HD-RD0004 | 8mm Smooth Rod x 18-19mm (Nubbin) | IGUS | EWMR-08-19 | IGUS | EWMR-08-19 | 2 | ea | $1.50 | $3.00 | 2030 | PO15119 | 08/17/16 | 09/12/16 | Combining MO16-0056, MO16-0057, MO16-0061, and MO16-0062 ~AS
Hardware | HD-BT0108 | Hobbed, M8 x 50 Bolt, 26mm offset | Quattro |  | Quattro |  | 2 | ea | $4.84 | $9.68 | 2030 | PO15123 | 08/17/16 | 09/07/16 | Combining MO16-0056, MO16-0057, MO16-0061, and MO16-0062 ~AS
Mechanical | HE-SH0031 | Reprap Modified Hexagon Hotend, Lulzbot Edition, 3.0mm Filament, .5mm Nozzle | RepRapDiscount |  | RepRapDiscount |  | 2 | ea | $23.00 | $46.00 | 2030
 | PP-MP0133 | AO-Hex Heatsink for 3mm Filament | RepRapDiscount |  | RepRapDiscount |  | 2 | ea |  |  | 2030 | PO15112 | 08/16/16 | 09/15/16 | Combining MO16-0056, MO16-0057, MO16-0061, and MO16-0062 ~AS
 | PP-MP0134 | AO-Hex Heater Bblock with Holes for Retention Plate and Hexagon Logo Laser Etched on Front | RepRapDiscount |  | RepRapDiscount |  | 2 | ea |  |  | 2030 | PO15112 | 08/16/16 | 09/15/16 | Combining MO16-0056, MO16-0057, MO16-0061, and MO16-0062 ~AS
 | PP-MP0135 | 0.5mm Nozzle for 3mm Filament | RepRapDiscount |  | RepRapDiscount |  | 2 | ea |  |  | 2030 | PO15112 | 08/16/16 | 09/15/16 | Combining MO16-0056, MO16-0057, MO16-0061, and MO16-0062 ~AS
 | EL-TH0011 | Semitec GT2 Thermistor (100kOhm type) Thermistor needs 23cm leads with no connectors on end | RepRapDiscount |  | RepRapDiscount |  | 2 | ea |  |  | 2030 | PO15112 | 08/16/16 | 09/15/16 | Combining MO16-0056, MO16-0057, MO16-0061, and MO16-0062 ~AS
 | EL-MS0377 | Heater cartridge 24V 30W Heater Cartridge needs 23cm leads with no connectors on end | RepRapDiscount |  | RepRapDiscount |  | 2 | ea |  |  | 2030 | PO15112 | 08/16/16 | 09/15/16 | Combining MO16-0056, MO16-0057, MO16-0061, and MO16-0062 ~AS
 | PP-MP0136 | Thermistor Retention Plate | RepRapDiscount |  | RepRapDiscount |  | 2 | ea |  |  | 2030 | PO15112 | 08/16/16 | 09/15/16 | Combining MO16-0056, MO16-0057, MO16-0061, and MO16-0062 ~AS
 | PP-MP0137 | Standard Hexagon Mount Plate | RepRapDiscount |  | RepRapDiscount |  | 2 | ea |  |  | 2030 | PO15112 | 08/16/16 | 09/15/16 | Combining MO16-0056, MO16-0057, MO16-0061, and MO16-0062 ~AS
 | HD-BT0172 | M3 x4 Setscrew (Heater Cartridge Set Screw) | RepRapDiscount |  | RepRapDiscount |  | 2 | ea |  |  | 2030 | PO15112 | 08/16/16 | 09/15/16 | Combining MO16-0056, MO16-0057, MO16-0061, and MO16-0062 ~AS
 | HD-BT0173 | Heat Sink Setscrew (M2x6 SCHS) | RepRapDiscount |  | RepRapDiscount |  | 2 | ea |  |  | 2030 | PO15112 | 08/16/16 | 09/15/16 | Combining MO16-0056, MO16-0057, MO16-0061, and MO16-0062 ~AS
Hardware | HD-TB0007 | Feed Tube, PTFE | Professional Plastics | 5239K12 | Professional Plastics | 5239K12 | 850 | mm | $0.00 | $3.04 | 862750 | PO15130 | 08/17/16 | 09/09/16 | Combining MO16-0056, MO16-0057, MO16-0061, and MO16-0062 ~AS
Hardware | HD-MS0058 | Wire Tie, 8” Black | Mcmaster | 7130K32 | Mcmaster | 7130K32 | 12 | ea | $1.00 | $12.04 | 12180 | N/A |  |  | huge stock on hand ~AS
Electronic | EL-MS0014 | Wire ferrules – 1.5mm^2 – 7mm | Mcmaster | 9681K21 | Mcmaster | 9681K21 | 4 | ea | $0.06 | $0.25 | 4060 | PO15131 | 08/17/16 | 08/24/16 | Combining MO16-0056, MO16-0057, MO16-0061, and MO16-0062 ~AS
Consumable | TL-CS0040 | Extreme-Temperature Pipe Sealant & Threadlocker, 4 oz bottle, blue | Mcmaster | 7604A55 | Mcmaster | 7604A55 | 0.5 | g | $0.066 | $0.03 | 507.5 | N/A |  |  | purchased on Bob's signal ~AS
Hardware | HD-BT0119 | M3 x 8 FHCS, black oxide | Fastenal | 91294A128 | Fastenal | 91294A128 | 4 | ea | $0.04 | $0.17 | 4060 | PO15131 | 08/17/16 | 08/24/16 | Combining MO16-0056, MO16-0057, MO16-0061, and MO16-0062 ~AS
Hardware | HD-NT0016 | M5 Nut, Steel, Zinc Plated, thin (jam nut) | Fastenal | 90695A037 | Fastenal | 90695A037 | 1 | ea | $0.03 | $0.03 | 1015 | PO15131 | 08/17/16 | 08/24/16 | Combining MO16-0056, MO16-0057, MO16-0061, and MO16-0062 ~AS
Hardware | HD-NT0044 | Post insertion M5 T-nut for 20mm extrusion | Misumi | HN-TAP5 | Misumi | HN-TAP5 | 1 | ea | $0.39 | $0.39 | 1015 | PO15127 | 08/17/16 | 09/01/16 | Combining MO16-0056, MO16-0057, MO16-0061, and MO16-0062 ~AS
Mechanical | PP-MP0085 | Bed finger, Dual | MBK |  | MBK |  | 4 | ea | $3.00 | $12.00 | 4060 | PO15126 | 08/17/16 | 09/15/16 | Combining MO16-0056, MO16-0057, MO16-0061, and MO16-0062 ~AS
Mechanical | PP-MP0087 | Dual extruder v2.0 mount | MBK |  | MBK |  | 1 | ea | $7.00 | $7.00 | 1015 | PO15126 | 08/17/16 | 09/15/16 | Combining MO16-0056, MO16-0057, MO16-0061, and MO16-0062 ~AS
Mechanical | PP-MP0086 | Lower bracket, Dual | MBK |  | MBK |  | 1 | ea | $9.00 | $9.00 | 1015 | PO15126 | 08/17/16 | 09/15/16 | Combining MO16-0056, MO16-0057, MO16-0061, and MO16-0062 ~AS
Electronic | EL-FA0020 | RFB2008 Micro Blower with 30awg wire that is 250mm long | Pelonis | C4010L24BPLB1b-7 | Pelonis | C4010L24BPLB1b-7 | 2 | ea | $6.54 | $13.08 | 2030 | PO15118 | 08/17/16 | 09/21/16 | Combining MO16-0056, MO16-0057, MO16-0061, and MO16-0062 ~AS
Electronic | EL-FA0032 | Pelonis FAN 24V 40x40mm Low flow | Pelonis | C4010L24BPLB1-7 | Pelonis | C4010L24BPLB1-7 | 2 | ea | 3.13 | $6.26 | 2030 | PO15118 | 08/17/16 | 09/21/16 | Combining MO16-0056, MO16-0057, MO16-0061, and MO16-0062 ~AS
Electronic | EL-MS0073 | 1/4” Black panduit wire wrap | Electronics Distributor Corp | 88-00011 | Electronics Distributor Corp | 88-00011 | 300 | mm | 0.000 | $0.07 | 304500 | PO15133 | 08/17/16 | 08/25/16 | Combining MO16-0056, MO16-0057, MO16-0061, and MO16-0062 ~AS
Electronic | EL-MS0139 | 3/8” Corrugated Wrap-Around Sleeving | Electronics Distributor Corp | 88-00012 | Electronics Distributor Corp | 88-00012 | 975 | mm | 0.000 | $0.26 | 989625 | PO15133 | 08/17/16 | 08/25/16 | Combining MO16-0056, MO16-0057, MO16-0061, and MO16-0062 ~AS
Electronic | EL-MS0247 | Heat shrink – 0.19-0.09 – Black | EDC | 88-01870 | Mcmaster-Carr Supply Company | 7856K74 | 250 | mm | 0.001 | $0.18 | 253750 | PO15133 | 08/17/16 | 08/25/16 | Combining MO16-0056, MO16-0057, MO16-0061, and MO16-0062 ~AS
Electronic | EL-MT0017 | Half Height NEMA 17 Stepper Motor | Changzhou FTX | SY42STH33-1504A | Changzhou FTX | SY42STH33-1504A | 2 | ea | $5.35 | $10.70 | 2030 | N/A |  |  | Plenty in stock (purchased entire year's supply only used on dual extruders) – using until Moon's half-stepper is approved ~AS
Consumable | TO-CS0107 | Loctite® 262™ Threadlocker High Strength 50ML Bottle | Uline | S-15893 | Uline | S-15893 | 0.25 | g |  |  | 253.75 | N/A |  |  | purchased on Bob's signal ~AS
Electronic | EL-MS0058 | CONN PIN 24-30AWG CRIMP TIN | Molex | 16020105 | TTI | WM2565CT-ND | 21 | pcs | $0.02 | $0.46 | 21315 | PO15149 | 08/18/16 | 09/02/16 | Combining MO16-0056, MO16-0057, MO16-0061, and MO16-0062 ~AS
Electronic | EL-MS0251 | CONN HOUSING 16POS .100 DUAL | Molex | 22552161 | TTI | WM2525-ND | 4 | ea | 0.529 | $2.12 | 4060 | PO15149 | 08/18/16 | 09/02/16 | Combining MO16-0056, MO16-0057, MO16-0061, and MO16-0062 ~AS
Electronic | EL-MS0059 | CONN TERM Female 22-24AWG | Molex | 16-02-0086 | TTI | 16-02-0086 | 20 | ea | 0.015 | $0.29 | 20300 | PO15149 | 08/18/16 | 09/02/16 | Combining MO16-0056, MO16-0057, MO16-0061, and MO16-0062 ~AS
Electronic | EL-MS0205 | CONN TERM MALE 22-24AWG TIN | Molex | 16-02-0107 | TTI | 16-02-0107 | 2 | ea | 0.019 | $0.04 | 2030 | PO15149 | 08/18/16 | 09/02/16 | Combining MO16-0056, MO16-0057, MO16-0061, and MO16-0062 ~AS
Electronic | EL-MS0123 | CONN PIN 0.062 24-26 AWG Tin Crimp | Molex | 1-66106-5 | TTI | 1-66106-5 | 23 | ea | 0.227 | $5.22 | 23345 | PO15149 | 08/18/16 | 09/02/16 | Combining MO16-0056, MO16-0057, MO16-0061, and MO16-0062 ~AS
Electronic | EL-MS0129 | CONN Cable clamp CPC size 17 black | Molex | 20607-8 | TTI | 20607-8 | 1 | ea | 2.180 | $2.18 | 1015 | PO15149 | 08/18/16 | 09/02/16 | Combining MO16-0056, MO16-0057, MO16-0061, and MO16-0062 ~AS
Electronic | EL-MS0124 | 20-24 AWG Sockets for Receptacle | Molex | 1-66331-4 | TTI | 1-66331-4 | 2 | ea | 0.208 | $0.42 | 2030 | PO15149 | 08/18/16 | 09/02/16 | Combining MO16-0056, MO16-0057, MO16-0061, and MO16-0062 ~AS
Electronic | EL-MS0246 | CONN RING 16-22 AWG #4 Red PIDG – Reel 5000 |  | 2-323758-1 | Digikey / TTI | A107160CT-NDA27229TR-ND | 1 | ea | 0.398 | $0.40 | 1015 | PO15149 | 08/18/16 | 09/02/16 | Combining MO16-0056, MO16-0057, MO16-0061, and MO16-0062 ~AS
Electronic | EL-MS0131 | CONN, PLUG, 14 POS | Sager | 206044-1 | Sager | 206044-1 | 1 | ea | $2.250 | $2.25 | 1015 | PO15138 | 08/17/16 | 09/02/16 | Combining MO16-0056, MO16-0057, MO16-0061, and MO16-0062 ~AS
Electronic | PC-CN0001 | CONN Housing 2 POS .100 W/ latch | Molex | 50579402 | Sager | 50579402 | 1 | ea | $0.053 | $0.05 | 1015 | PO15138 | 08/17/16 | 09/02/16 | Combining MO16-0056, MO16-0057, MO16-0061, and MO16-0062 ~AS
Electronic | EL-MS0061 | Conn Housing Male 4POS .100 | Digikey | WM2535-ND | Digikey | WM2535-ND | 7 | pcs | $0.12 | $0.81 | 7105 | PO15138 | 08/17/16 | 09/02/16 | Combining MO16-0056, MO16-0057, MO16-0061, and MO16-0062 ~AS
Electronic | EL-WR0103 | 24 AWG Red wire | Allcable | C2065R-1000-ND | Allcable | C2065R-1000-ND | 4590 | mm | 0.000 | $0.35 | 4658850 | PO15135 | 08/17/16 | 09/02/16 | Combining MO16-0056, MO16-0057, MO16-0061, and MO16-0062 ~AS
Electronic | EL-WR0099 | Shielded 22AWG UL2464 4 Cond | Allcable | C0762A.41.10 | Allcable | C0762A.41.10 | 1000 | mm | 0.001 | $1.01 | 1015000 | PO15135 | 08/17/16 | 09/02/16 | Combining MO16-0056, MO16-0057, MO16-0061, and MO16-0062 ~AS
Electronic | EL-WR0040 | Wire - Single Conductor 20AWG SOLID PTFE, RED | Allcable | 602-2856/1-100-03 | Mouser / Allcable | 602-2856/1-100-03 | 200 | mm | 0.004 | $0.73 | 203000 | PO15135 | 08/17/16 | 09/02/16 | Combining MO16-0056, MO16-0057, MO16-0061, and MO16-0062 ~AS
Electronic | EL-WR0123 | 16AWG Stranded – White | Allcable | C2065A.21.02 | Allcable | C2065W-1000-ND | 50 | mm | 0.000 | $0.00 | 50750 | N/A |  |  | not nearly enough to meet minimum order; some in stock ~AS
Electronic | EL-WR0105 | 24 AWG Black Wire | Allcable | HU1569247BK | Allcable | C2065B-1000-ND | 2490 | mm | 0.000 | $0.19 | 2527350 | PO15135 | 08/17/16 | 09/02/16 | Combining MO16-0056, MO16-0057, MO16-0061, and MO16-0062 ~AS
Electronic | EL-WR0119 | 24AWG Stranded – Green | Allcable | C2015G-1000-ND | Allcable | C2015G-1000-ND | 50 | mm | 0.000 | $0.00 | 50750 | PO15135 | 08/17/16 | 09/02/16 | Combining MO16-0056, MO16-0057, MO16-0061, and MO16-0062 ~AS
Electronic | EL-WR0104 | 24AWG Orange wire | Allcable | HU1569247OE | Allcable | C2015A-1000-ND | 2100 | mm | 0.000 | $0.16 | 2131500 | PO15135 | 08/17/16 | 09/02/16 | Combining MO16-0056, MO16-0057, MO16-0061, and MO16-0062 ~AS
Shipping | SH-PG0063 | 8 x 7 x 6" Indestructo Mailers 100/800 | Uline | S-15087 | Uline | S-15087 | 1 | ea | $1.01 | $1.01 | 1015 | N/A |  |  | Changing to Korrvu box
Shipping | SH-PG0004 | 8 x 8" 2 Mil Reclosable Polypropylene Bags | Uline | S-1699 | Uline | S-1699 | 1 | ea | $0.06 | $0.06 | 1015 | N/A |  |  | Changing to Korrvu box
Shipping | SH-PA0019 | Bubble 1/8x48x750 perf 12" slit 2-24" rolls | Shipper Supply | B1/8p12-24 | Shipper Supply | B1/8p12-24 | 2 | sheet | $0.15 | $0.30 | 1015 | N/A |  |  | Changing to Korrvu box
Shipping | SH-PA0039 | Roll of 48"x1/4" Thick Foam, Split at 12" - 225 feet Per Roll | Shipper Supply |  | Shipper Supply |  | 0.0011111111 | ea |  |  | 1.1277777778
Label | DC-LB0072 | Label, LulzBot TAZ Dual Extruder Tool Head v2c, 0.5 Nozzle, Front | Sticker Giant |  | Sticker Giant |  | 1 | ea | $0.10 | $0.10 | 1015
Label | DC-LB0073 | Label, LulzBot TAZ Dual Extruder Tool Head v2c, 0.5 Nozzle, Back | Sticker Giant |  | Sticker Giant |  | 1 | ea | $0.10 | $0.10 | 1015
Label | DC-LB0104 | Tool Head Wiring Connector Alignment Label | Sticker Giant |  | Sticker Giant |  | 2 | ea | $0.03 | $0.05 | 2030
Documentation | DC-MS0047 | v2 Tool Head Instruction Card | The Print Shop of Loveland |  | The Print Shop of Loveland |  | 1 | ea | $1,000.00 | $1,000.00 | 1015
Documentation | DC-MS0054 | Firmware Update Warning Cards | The Print Shop of Loveland |  | The Print Shop of Loveland |  | 1 | ea | $0.17 | $0.17 | 1015 | PO15186 |  |  | Combining MO16-0056, MO16-0057, MO16-0061, and MO16-0062 +500 per Bob ~AS
Sample | RM-AB0082 | Black ABS 3mm Filament, 5lb Reel | Village Plastics |  | Village Plastics |  | 0.0066 | ea | $49.00 | $0.32 | 6.699 | PO15578 | 09/15/16 |  | Combining MO16-0056 and MO16-0057
Sample | RM-AB0096 | LulzBot Green ABS 3mm Filament, 5lb Reel | Village Plastics |  | Village Plastics |  | 0.0066 | ea | $56.50 | $0.37 | 6.699 | PO15578 | 09/15/16
Label | DC-LB0083 | LulzBot TAZ Dual Extruder v2 Serial Number Label |  |  |  |  | 1 | ea | $4,000.00 | $4,000.00 | 1015
 |  |  |  |  |  |  |  | Dual Extruder BOM cost |  | $1,178.85

Sheet: OLD - Don't Use
Javelin BOM |  |  |  |  | QTY to Build | 150 |  |  | Qty to Order |  |  |  | PO | Date | ETA | Notes
Printed |  |  | Dual_Extruder_Mt-v1.3 |  | Aleph Objects |  | 1 | ea | 150 | $1.00 | $1.00
Printed |  |  | Flex_plate_v0.5, Blue |  | Aleph Objects |  | 1 | ea | 150 | $1.00 | $1.00
Printed |  | PP-GP0186 | Wade extruder body for Hex nozzle v1.0 |  | Aleph Objects |  | 2 | ea | 300 | $0.87 | $1.74 | extruder
Printed | PP-GP0059 | PP-GP0059 | Wade Reloaded Idler Block v1.4, Taz & Mini |  | Aleph Objects |  | 2 | ea | 300 | $0.17 | $0.33 | extruder
Printed |  | PP-GP0061 | herringbone_large_gear |  | Aleph Objects |  | 2 | ea | 300 | $0.56 | $1.12 | extruder
Printed |  | PP-GP0091 | extruder_latch |  | Aleph Objects |  | 2 | ea | 300 | $0.06 | $0.12
Printed |  | PP-GP0062 | herringbone_small_gear |  | Aleph Objects |  | 2 | ea | 300 | $0.08 | $0.15 | extruder
Printed |  | PP-GP0060 | Wade Reloaded Bearing Washer |  | Aleph Objects |  | 2 | ea | 300 | $0.00 | $0.01 | extruder
Printed |  | PP-GP0162 | Spool Arm, Blue |  | Aleph Objects |  | 1 | ea | 150 | $1.99 | $1.99
Printed |  | PP-GP0074 | feed_tube spinner |  | Aleph Objects |  | 1 | ea | 150 | $0.07 | $0.07
Printed |  |  | dual_fan_shroud |  | Aleph Objects |  | 2
Mechanical |  |  | dual_lower_plate_v0.4 |  |  |  | 1 | ea
Mechanical |  |  | dual_hex_mount_plate_v0.2 |  |  |  | 1 | ea
Hardware |  | HD-MS0031 | Thumb Screw Knob for M4 SHCS, Black |  | Timberline |  | 4 | ea | 600 | $0.10 | $0.38 | extruder |  |  |  |  | McMaster-Carr Supply Company | 91175A062
Hardware |  | HD-BT0052 | M4 x 55 Bolt, SHCS Black-Oxide |  | Timberline |  | 4 | ea | 600 | $0.08 | $0.31 | extruder |  |  |  |  | McMaster-Carr Supply Company | 91290A187
Hardware |  | HD-NT0004 | M3 Nut, Zinc Plated |  | Timberline |  | 4 | ea | 600 | $0.01 | $0.04 | small herringbone gear, extruder idler |  |  |  |  | McMaster-Carr Supply Company | 90591A121
Hardware |  | HD-BT0012 | M3 Set Screw (Grub Screw) |  | Timberline |  | 2 | ea | 300 | $0.02 | $0.03 | extruder, rods and switches |  |  |  |  | McMaster-Carr Supply Company | 91390A100
Hardware |  | HD-MS0230 | M2 x 6 Bolt, SCHS Black-Oxide |  |  |  | 4 | ea
Hardware |  | PP-MP0066 | Metric Brass Heat-Set Insert for Plastics, Tapered, M2-.4 Internal Thread, 2.9MM Length |  |  |  | 4 | ea
Hardware |  | HD-BT0039 | M3 x 12 Bolt, SHCS Black-Oxide |  | Timberline |  | 6 | ea | 900 | $0.01 | $0.07 |  |  |  |  |  | McMaster-Carr Supply Company | 91290A117
 |  |  | M3 x 25 Bolt, FHCS Black-Oxide |  |  |  | 2 | ea
 |  |  | M3 x 20 Bolt, SHCS |  |  |  | 4 | ea
Hardware |  | HD-BT0041 | M3 x 25 Bolt, SHCS Black-Oxide |  | Timberline |  | 6 | ea | 900 | $0.03 | $0.15 | extruder; bed mount, z-hard stop |  |  |  |  | McMaster-Carr Supply Company | 91290A125
Hardware |  | HD-WA0001 | M3 Washer, Steel, Zinc Plated |  | Timberline |  | 12 | ea | 1800 | $0.00 | $0.02 |  |  |  |  |  | McMaster-Carr Supply Company | 91166A210
Hardware |  | HD-BT0010 | M4 x 20 Bolt, SHCS Black-Oxide |  | Timberline |  | 4 | ea | 600 | $0.04 | $0.14 | Extruder/Buda |  |  |  |  | McMaster-Carr Supply Company | 91290A168
Hardware |  | HD-WA0005 | M4 Washer |  | Timberline |  | 8 | ea | 1200 | $0.00 | $0.03 | Extruder/Buda |  |  |  |  | McMaster-Carr Supply Company | 91166A230
Hardware |  | HD-NT0011 | M4 Nut,Zinc-Plated Steel |  | Timberline |  | 8 | ea | 1200 | $0.01 | $0.08 | extruder/buda |  |  |  |  | McMaster-Carr Supply Company | 90591A141
Hardware |  | HD-BT0108 | Hobbed Bolt, M8 x 50mm Hex head, 26mm offset, Stainless Steel |  | Quattro |  | 2 | ea | 300 | $4.00 | $8.00 | extruder
Hardware |  | HD-NT0002 | M8 Nyloc Nut, Zinc Plated |  | Timberline |  | 2 | ea | 300 | $0.05 | $0.11 | bearings, extruder |  |  |  |  | McMaster-Carr Supply Company | 90576A117
Hardware |  | HD-WA0008 | M8 shim washer - .5mm |  | Timberline |  | 2 | ea | 300 | $0.01 | $0.02 | extruder, spooler,bearings |  |  |  |  | McMaster-Carr Supply Company | 91166A270
Hardware |  | HD-WA0009 | M8 shim washer – 1.0mm |  | Timberline |  | 2 | ea | 300 | $0.01 | $0.02 | extruder, spooler,bearings |  |  |  |  | McMaster-Carr Supply Company | 91166A270
Hardware |  | HD-WA0006 | M8 Washer, Steel, Zinc Plated |  | Timberline |  | 8 | ea | 1200 | $0.01 | $0.09 | extruder, spooler,bearings |  |  |  |  | McMaster-Carr Supply Company | 91166A270
Mechanical |  | HD-MS0204 | 100 Sealed Skateboard/inline/Rollerblade Skate Bearing Ball |  | vxb.com | kit708 | 6 | ea | 900 | $0.54 | $3.23 | 4 bearings used in robot, 3 in extruder |  |  |  |  | Received |  | Checking with Mary on inventory levels / Per Mary, we should be good on these – don't order more.
Hardware |  | HD-BT0049 | M5 x 14 Bolt, SHCS Black_Oxide |  | Timberline |  | 2 | ea | 300 | $0.03 | $0.05 |  |  |  |  |  | Mcmaster-Carr Supply Company | 91290A230
Hardware |  | HD-MS0055 | Thumb Screw Knob for M5 SHCS, Black |  | Timberline |  | 1 | ea | 150 | $0.11 | $0.11 | Y-axis |  |  |  |  | McMaster-Carr Supply Company | 91175A063
Hardware |  | HD-MS0027 | Spring, Extruder, 6mm OD, 0.8mm WD, 9.7mm FL |  | Associated Spring | C0240-032-0380-M | 4 | ea | 600 | $0.35 | $1.40 | Extruder, Z-endstop
Mechanical |  | HD-RD0004 | 8mm Smooth Rod x 18-19mm |  | MBK |  | 2 | ea | 300 | $4.63 | $9.26 | extruder
Mechanical |  |  | Assy, Lulzbot Hexagon V1.0 with 0.35 nozzle | Aleph Objects | Aleph Objects |  | 2 | ea | 300 | $52.00 | $104.00
Hardware |  | HD-TB0007 | Feed Tube, PTFE |  | Professional Plastics | 0.187 ID X .250 OD NAT PTFE TUBE | 850 | mm | 127500 | $0.00 | $3.04 | Filament Guide | PO06980 | 03/31/15 | 04/06/15 | 418 Feet | McMaster-Carr Supply Company | 5239K12
Hardware |  | HD-WA0007 | M5 Washer, Steel, Zinc Plated |  | Timberline |  | 1 | ea | 150 | $0.00 | $0.00 | frame |  |  |  |  | McMaster-Carr Supply Company | 91166A240
Hardware |  | HD-MS0058 | Wire Tie, 8” |  | Electronics Distributors Corporation |  | 6 | ea | 900 | $0.02 | $0.14 |  | PO06876 | 03/20/15 | See Notes | 50K 4/3/15 - 40K 4/17/15 - 40K 5/1/15 - 40K 5/15/15 - 40K 5/29/15 | McMaster-Carr Supply Company | 7130K59
Hardware |  | HD-MS0062 | Metric Aluminum Unthreaded Spacer, 8MM OD, 8MM Length, M5 Screw Size |  | Timberline |  | 1 | ea | 150 | $1.15 | $1.15 |  |  |  |  |  | McMaster-Carr Supply Company | 94669A757 | Still need to order (7/31
Hardware |  | HD-NT0044 | Post insertion M5 T-nut for 20mm extrusion | Post assembly M5 T-nut | Misumi | HN-TAP5 | 1 | ea | 150 | $0.05 | $0.05 | for additional spool arm |  |  |  |  | Received |  | Checking with Mary on inventory levels / Per Mary, we should be good on these – don't order more.
Hardware |  |  | Panduit wire wrap – 1/4” Black |  |  |  | 260 | mm
 |  |  | 40mm Fan |  |  |  | 2 | ea
Electronic |  | EL-FA0020 | RFB2008 Micro Blower, 30 AWG wire 250mm long |  | Pelonis |  | 2 | ea
Electronic |  | EL-MT0017 | Half Height NEMA 17 Stepper Motor, wires cut to 60mm |  | Changzhou | SY42STH33-1504A | 2 | ea | 300 | $5.35 | $10.70
Electronic |  | TL-CS0083 | EMI/RFI-Shield Heat-Shrink Tubing 3/16" ID Before, 3/32" ID After, 48" L, Black, cut to 50mm |  | Mcmaster-Carr Supply Company | 7937K31 | 90 | mm | 13500 | $0.01 | $1.25 |  |  |  |  |  | 44 | Feet
Electronic |  | TL-CS0129 | Interference-Shielding Heat-Shrink Tubing, 3/8" ID Before, 3/16" ID After, 48" Long, Black |  | Mcmaster-Carr Supply Company | 7937K33 | 60 | mm
Electronic |  | EL-MS0061 | Conn Housing Male 4POS .100 |  | Digikey | WM2535-ND | 2 | pcs | 300 | $0.40 | $0.80
Electronic |  | EL-MS0205 | CONN TERM MALE 22-24AWG TIN |  | Digikey | WM2517TR-ND | 8 | pcs | 1200 | $0.07 | $0.52
 |  |  |  |  |  |  |  |  |  | Dual Extruder BOM cost | $152.72
 |  |  | Might Change
 |  |  | Will Change
 |  |  | New

Sheet: cost check
 |  |  |  | QTY TO BUILD |  | 250 |  |  | Qty to order
Category | AO Part # | Part Name | Manufacturer | Mfr. PN | Distributor | MFR PN | Qty | UOM |  | Cost Each | Cost per Dual | Cost Total | PO | Date | ETA |  |  | Notes
Printed | PP-GP0197 | dual_extruder_2.0_mount_v1.0 | Aleph Objects |  | Aleph Objects |  | 1 | ea | 250 | $1.00 | $1.00 | $250.00
Printed | PP-GP0198 | javelin_flex_plate_v1.2 | Aleph Objects |  | Aleph Objects |  | 1 | ea | 250 | $1.00 | $1.00 | $250.00
Printed | PP-GP0199 | 40mm_fan_duct__for_dual_v0.3 | Aleph Objects |  | Aleph Objects |  | 2 | ea | 500 | $1.00 | $2.00 | $500.00
Printed | PP-GP0186 | Wade extruder body for Hex nozzle v1.0 | Aleph Objects |  | Aleph Objects |  | 2 | ea | 500 | $3.790 | $7.58 | $1,895.00
Printed | PP-GP0193 | Wade Reloaded Idler Block v1.4, Taz & Mini | Aleph Objects |  | Aleph Objects |  | 2 | ea | 500 | $0.900 | $1.80 | $450.00
Printed | PP-GP0191 | Herringbone Large Gear v1.3, Lulzbot green | Aleph Objects |  | Aleph Objects |  | 2 | ea | 500 | $2.230 | $4.46 | $1,115.00
Printed | PP-GP0091 | extruder_latch_v2.0 | Aleph Objects |  | Aleph Objects |  | 2 | ea | 500 | $0.260 | $0.52 | $130.00
Printed | PP-GP0192 | Herringbone Small Gear v1.1, Lulzbot green | Aleph Objects |  | Aleph Objects |  | 2 | ea | 500 | $0.290 | $0.58 | $145.00
Printed | PP-GP0060 | Wade Reloaded Bearing Washer | Aleph Objects |  | Aleph Objects |  | 2 | ea | 500 | $0.020 | $0.04 | $10.00
Printed | PP-GP0109 | Spool Arm, TAZ | Aleph Objects |  | Aleph Objects |  | 1 | ea | 250 | $1.99 | $1.99 | $496.40
Printed | PP-GP0074 | feed_tube spinner | Aleph Objects |  | Aleph Objects |  | 1 | ea | 250 | $0.07 | $0.07 | $17.04
Hardware | HD-MS0031 | Thumb Screw Knob for M4 SHCS, Black |  |  | Fastenal |  | 4 | ea | 1000 | $0.10 | $0.38 | $95.20 | PO12205 | 02/25/16 | 03/18/16 | Non-std PO w/Fastenal | McMaster-Carr Supply Company | 91175A062
Hardware | HD-BT0052 | M4 x 55 Bolt, SHCS Black-Oxide |  |  | Fastenal | ZT2530055PF0000 | 4 | ea | 1000 | $0.08 | $0.31 | $78.20 |  |  |  |  | McMaster-Carr Supply Company | 91290A187
Hardware | HD-NT0004 | M3 Nut, Zinc Plated |  |  | Fastenal | 40302 | 4 | ea | 1000 | $0.01 | $0.02 | $5.50 |  |  |  |  | McMaster-Carr Supply Company | 90591A121
Hardware | HD-BT0012 | M3 Set Screw (Grub Screw) |  |  | Fastenal | 40818 | 2 | ea | 500 | $0.02 | $0.04 | $9.00 |  |  |  |  | McMaster-Carr Supply Company | 91390A100
Hardware | HD-MS0030 | M3-.5 3.8mm Heatset Insert |  |  | CEH | 11125995 | 4 | ea | 1000 | $0.04 | $0.14 | $36.00 |  |  |  |  | McMasterCarr | 94180A331
Hardware | HD-BT0039 | M3 x 12 Bolt, SHCS Black-Oxide |  |  | Fastenal | 1138525 | 6 | ea | 1500 | $0.01 | $0.07 | $17.40 |  |  |  |  | McMaster-Carr Supply Company | 91290A117
Hardware | HD-BT0135 | M3 x 25 Bolt, FHCS Black-Oxide |  |  | Fastenal | 40929 | 2 | ea | 500 | $0.03 | $0.07 | $16.25
Hardware | HD-BT0041 | M3 x 25 Bolt, SHCS Black-Oxide |  |  | Fastenal | 40929 | 4 | ea | 1000 | $0.03 | $0.11 | $28.30 |  |  |  |  | McMaster-Carr Supply Company | 91290A125
Hardware | HD-WA0001 | M3 Washer, Steel, Zinc Plated |  |  | Fastenal | 40352 | 14 | ea | 3500 | $0.00 | $0.02 | $5.60 |  |  |  |  | McMaster-Carr Supply Company | 91166A210
Hardware | HD-BT0046 | M4 x 16 Bolt, SHCS Black-Oxide |  |  | Mcmaster |  | 4 | ea | 1000 | $0.09 | $0.37 | $92.10 |  |  |  |  |  | delivered
Hardware | HD-WA0005 | M4 Washer |  |  | Fastenal | 40353 | 8 | ea | 2000 | $0.00 | $0.02 | $5.40 |  |  |  |  | McMaster-Carr Supply Company | 91166A230
Hardware | HD-NT0011 | M4 Nut,Zinc-Plated Steel |  |  | Fastenal | 40303 | 8 | ea | 2000 | $0.00 | $0.04 | $9.20 |  |  |  |  | McMaster-Carr Supply Company | 90591A141
Hardware | HD-BT0108 | Hobbed, M8 x 50 Bolt, 26mm offset |  |  | Quattro |  | 2 | ea | 500 | $4.99 | $9.98 | $2,495.00 |  |  |  |  | Scheduled delivery of 1,000 per month
Hardware | HD-NT0002 | M8 Nyloc Nut, Zinc Plated |  |  | Fastenal | 40163 | 2 | ea | 500 | $0.03 | $0.06 | $16.05 |  |  |  |  | McMaster-Carr Supply Company | 90576A117
Hardware | HD-WA0008 | M8 shim washer - .5mm |  |  | Fastenal |  | 2 | ea | 500 | $0.05 | $0.10 | $25.90 |  |  |  |  | 2800 delivered 1200 on 8/12 | 91166A270
Hardware | HD-WA0009 | M8 shim washer – 1.0mm |  |  | Fastenal |  | 2 | ea | 500 | $0.05 | $0.10 | $25.90 |  |  |  |  | Confirmed 7/30 delivery | 91166A270
Hardware | HD-WA0006 | M8 Washer, Steel, Zinc Plated |  |  | Fastenal |  | 6 | ea | 1500 | $0.01 | $0.06 | $14.40 |  |  |  |  | Confirmed 7/30 delivery | 91166A270
Hardware | HD-BT0104 | M3 x 8 BHCS, Stainless |  |  | Fastenal | MB2510008A20000 | 3 | ea | 750 | $0.088 | $0.26 | $66.15 |  |  |  |  | PO08905 compatability add on
Hardware | HD-BT0119 | M3 x 8 FHCS, black oxide |  |  | Mcmaster | 91294A128 | 4 | ea | 1000 | $0.10 | $0.39 | $97.00
Hardware | HD-BT0007 | M3 x 20 SCHS, black-oxide |  |  | Mcmaster | 91290A123 | 4 | ea | 1000 | $0.10 | $0.39 | $97.00
Hardware | HD-MS0230 | M2 x 6mm SCHS, black-oxide |  |  | Fastenal | 134596 | 2 | ea | 500 | $0.03 | $0.06 | $14.10
Hardware | HD-NT0016 | M5 Nut, Steel, Zinc Plated, thin (jam nut) |  |  | Mcmaster | 90695A037 | 1 | ea | 250 | $0.03 | $0.03 | $6.75
Mechanical | HD-MS0282 | 608-2RS ABEC3/C3 Rubber Sealed Bearing – BLACK |  |  | JSB |  | 6 | ea | 1500 | $0.42 | $2.52 | $630.00 | PO12542 |  | 03/31/16 |  | confirmed
Hardware | HD-MS0158 | M5-.8 6.7mm Heatset Insert |  |  | Fastenal | 11125997 | 1 | ea | 250 | $0.09 | $0.09 | $22.98 |  |  |  |  | McMasterCarr | 94180A363
Hardware | HD-BT0153 | M5 X 20 SCHS, Stainless |  |  | Fastenal | 92290A242 | 1 | ea | 250 | $0.05 | $0.05 | $11.95
Hardware | HD-BT0073 | M5 x 10mm BHCS, black-oxide |  |  | Fastenal | 1139905 | 1 | ea | 250 | $0.08 |  | $19.83
Hardware | HD-BT0049 | M5 x 14 Bolt, SHCS Black_Oxide |  |  | Fastenal | 1139539 | 1 | ea | 250 | $0.01 | $0.01 | $2.93 |  |  |  |  | Mcmaster-Carr Supply Company | 91290A230
Hardware | HD-MS0027 | Spring, Extruder, 6mm OD, 0.8mm WD, 9.7mm FL |  |  | Associated Spring | C0240-032-0380-M | 4 | ea | 1000 | $0.22 | $0.88 | $220.00 | PO12069 |  | 02/22/16 | Ordered with Uara, brambling, longfin BOMs
Mechanical | HD-RD0004 | 8mm Smooth Rod x 18-19mm |  |  | MBK |  | 2 | ea | 500 | $5.10 | $10.20 | $2,550.00
Mechanical | HE-SH0031 | Reprap Modified Hexagon Hotend, Lulzbot Edition, 3.0mm Filament, .5mm Nozzle | Aleph Objects |  | Aleph Objects |  | 2 | ea | 500 | $23.00 | $46.00 | $11,500.00
Hardware | HD-MS0062 | Metric Aluminum Unthreaded Spacer, 8MM OD, 8MM Length, M5 Screw Size |  |  | Fastenal |  | 1 | ea | 250 | $0.169 | $0.17 | $42.13
Hardware | HD-TB0007 | Feed Tube, PTFE |  |  | Professional Plastics | 5239K12 | 850 | mm | 212500 | $0.01 | $4.71 | $1,178.23 |  |  |  |  | 1400 Feet
Hardware | HD-WA0007 | M5 Washer, Steel, Zinc Plated |  |  | Fastenal | 1140354 | 2 | ea | 500 | $0.00 | $0.01 | $1.50 |  |  |  |  | McMaster-Carr Supply Company | 91166A240
Hardware | HD-MS0059 | Standard Nylon Cable Tie 7-1/2" L, 1-7/8" Bundle Dia, 50#Tensile Strg, Black |  |  | Timberline |  | 12 | ea | 3000 | $0.02 | $0.28 | $69.60 |  |  |  |  | McMaster-Carr Supply Company | 7130K59
Hardware | HD-NT0044 | Post insertion M5 T-nut for 20mm extrusion | Post assembly M5 T-nut |  | Misumi | HN-TAP5 | 1 | ea | 250 | $0.46 | $0.46 | $115.00
Mechanical | PP-MP0085 | Bed finger |  |  | MBK |  | 4 | ea | 1000 | $3.00 | $12.00 | $3,000.00
Mechanical | PP-MP0087 | Hex dual mount plate |  |  | MBK |  | 1 | ea | 250 | $7.00 | $7.00 | $1,750.00
Mechanical | PP-MP0086 | Dual lower bracket |  |  | MBK |  | 1 | ea | 250 | $9.00 | $9.00 | $2,250.00
Electronic | EL-FA0011 | FAN,24VDC,Sleeve,5.75CFM,40X40X10MM,60mA 6000RPM,1.44W,280MM LEADS,CE/RoHS |  |  | Kysan | TF4010-24H-S | 2 | ea | 500 | $1.45 | $2.90 | $725.00
Electronic | EL-FA0020 | RFB2008 Micro Blower with 30awg wire that is 250mm long |  |  | Pelonis |  | 2 | ea | 500 | $6.54 | $13.08 | $3,270.00
Electronic | EL-MS0014 | Wire ferrules – 1.5mm^2 – 7mm |  |  | Mcmaster | 9681K21 | 4 | ea | 1000 | $0.06 | $0.25 | $63.00
Electronic | HD-TB0032 | Flexible Polyolefin Heat Shrink Tubing 1/8" ID Before, 1/16" ID After, 100', Black | EDC | 84-01250 | McMaster-Carr | 7856K33 | 50 | mm | 12500 | $0.00 | $0.00 | $7.66 |  |  |  |  | 1/28/16 Ordered from EDC. KG
Electronic | EL-WR0103 | 24 AWG Red wire |  |  | Allcable |  | 340 | mm | 85000 | $0.000 | $0.03 | $6.41
Electronic | EL-WR0105 | 24 AWG Black Wire |  |  | Allcable |  | 340 | mm | 85000 | $0.000 | $0.03 | $6.41 |  |  |  |  |  | Wrong part number was marked on the BOM – was EL-WR0104
Electronic | EL-MS0073 | 1/4” Black panduit wire wrap |  |  | Electronics Distributor Corp |  | 300 | mm | 75000 | $0.000 | $0.00 | $0.22
Electronic | EL-MT0017 | Half Height NEMA 17 Stepper Motor |  |  | Changzhou FTX | SY42STH33-1504A | 2 | ea | 500 | $5.35 | $10.70 | $2,675.00 |  |  |  |  | in transit/ ocean method
Electronic | TL-CS0083 | EMI/RFI-Shield Heat-Shrink Tubing 3/16" ID Before, 3/32" ID After, 48" L, Black, cut to 50mm |  |  | Allcable | 7937K31 | 160 | mm | 40000 | $0.01 | $2.22 | $553.81
Electronic | EL-MS0058 | CONN PIN 24-30AWG CRIMP TIN |  |  | Heilind | WM2565CT-ND | 21 | pcs | 5250 | $0.15 | $1.89 | $787.50 |  |  |  |  | compatability add on
 |  |  |  |  |  |  |  |  | 0
Electronic | EL-MS0210 | CONN RING UNINS 15-20AWG #M3 |  | 160344-2 | Digikey / TTI | A107160CT-ND | 1 | ea | 250 | $0.09 | $0.09 | $22.50 |  |  |  |  | compatability add on
Electronic | EL-WR0040 | Wire - Single Conductor 20AWG SOLID PTFE, RED |  |  | Mouser / Allcable | 602-2856/1-100-03 | 200 | mm | 50000 | $0.00 | $0.78 | $194.23 |  |  |  |  | compatability add on
Hardware | HD-WA0035 | Metric 18-8 Stainless Steel External Serrated Lock Washer, M3 Screw Size, 6mm OD, 0.4mm min Thick |  | 11511313 | Mcmaster / Fastenal | 91120A120 | 1 | ea | 250 | $0.020 | $0.02 | $4.88 |  |  |  |  | compatability add on
Consumable | TL-CS0107 | Loctite® 262™ Threadlocker High Strength 50ML Bottle |  |  |  |  | 0.005 | bottle |  | $8.87 | $0.04
Consumable | TL-CS0040 | Extreme-Temperature Pipe Sealant & Threadlocker, 4 oz bottle, blue |  |  | Mcmaster | 7604A55 | 0.5 | g | 125 | $0.066 | $0.03 | $8.31 |  |  |  |  |  | delivered
 | EL-MS0251 | CONN HOUSING 16POS .100 DUAL | Molex |  | Heilind | WM2525-ND | 2 | ea | 500 | $0.529 | $1.06 | $264.50 |  |  |  |  |  | ordered 13K, 5400 deliver 7/23 balance 7600 aprox 6 wks ~9/4
TAZ 5 Dual Harness
 | EL-MS0139 | 3/8” Corrugated Wrap-Around Sleeving |  |  | Electronics Distributor Corp |  | 975 | mm | 243750 | $0.00 | $0.00 | $0.79 |  |  |  |  |  | 3800 ft confirmed
 | EL-WR0105 | 24 AWG Black Wire |  |  | Allcable |  | 2000 | mm | 500000 | $0.000 | $0.15 | $37.73
 | EL-WR0103 | 24 AWG Red wire |  |  | Allcable |  | 4000 | mm | 1000000 | $0.000 | $0.30 | $75.46
 | EL-WR0104 | 24AWG Orange wire |  |  | Allcable |  | 2000 | mm | 500000 | $0.000 | $0.15 | $37.73
 | EL-WR0099 | Shielded 22AWG UL2464 4 Cond |  |  | Allcable |  | 1000 | mm | 250000 | $0.001 | $1.01 | $252.62
 | EL-MS0059 | CONN TERM Female 22-24AWG |  |  | Heilind |  | 12 | ea | 3000 | $0.016 | $0.19 | $48.00
 | EL-MS0251 | CONN HOUSING 16POS .100 DUAL | Molex |  | Heilind | WM2525-ND | 2 | ea | 500 | $0.529 | $1.06 | $264.50
 | EL-MS0131 | CONN, PLUG, 14 POS |  |  | Heilind |  | 1 | ea | 250 | $2.300 | $2.30 | $575.00
 | EL-MS0123 | CONN PIN 0.062 24-26 AWG Tin Crimp |  |  | tti |  | 13 | ea | 3250 | $0.200 | $2.60 | $650.00
 | EL-MS0129 | CONN Cable clamp CPC size 17 black |  |  | Heilind |  | 1 | ea | 250 | $1.920 | $1.92 | $480.00
Shipping | SH-PG0063 | 8 x 7 x 6" Indestructo Mailers 100/800 |  |  | Uline | S-15087 | 1 | ea | 250 | $1.08 | $1.08
Shipping | SH-PA0019 | Bubble 1/8x48x750 perf 12" slit 2-24" rolls |  |  | Shipper Supply |  | 2 | sheet | 500 | $0.15 | $0.30
Shipping | SH-PG0004 | 8 x 8" 2 Mil Reclosable Polypropylene Bags |  |  | Uline | S-1699 | 1 | ea | 250 | $0.06 | $0.06
Shipping | SH-PA0039 | Roll of 48"x1/4" Thick Foam, Split at 12" - 225 feet Per Roll |  |  | Shipper Supply |  | 0.0011111111 | ea | 1
Label | DC-LB0072 | Label, LulzBot TAZ Dual Extruder Tool Head v2c, 0.5 Nozzle, Front |  |  | Sticker Giant |  | 1 | ea | 250 | $0.10 | $0.10
Label | DC-LB0073 | Label, LulzBot TAZ Dual Extruder Tool Head v2c, 0.5 Nozzle, Back |  |  | Sticker Giant |  | 1 | ea | 250 | $0.10 | $0.10
Documentation | DC-MS0047 | v2 Tool Head Instruction Card |  |  |  |  | 1 | ea
Sample | RM-AB0082 | Black ABS 3mm Filament, 5lb Reel |  |  | Village |  | 0.0066 | ea | $49.00 | $0.32 | $0.00
Sample | RM-AB0096 | LulzBot Green ABS 3mm Filament, 5lb Reel |  |  | Village |  | 0.0066 | ea | $56.50 | $0.37 | $0.00
Label | DC-LB0083 | LulzBot TAZ Dual Extruder v2 Serial Number Label |  |  |  |  | 1 | ea
 |  | New
 |  | not used anymore
 |  | wrong
 |  | new |  |  |  |  |  |  |  | Dual Extruder BOM cost | $171.88 | $42,890.22
