alephobjects/taz-toolhead-javelin/calibration/outer_square.stl

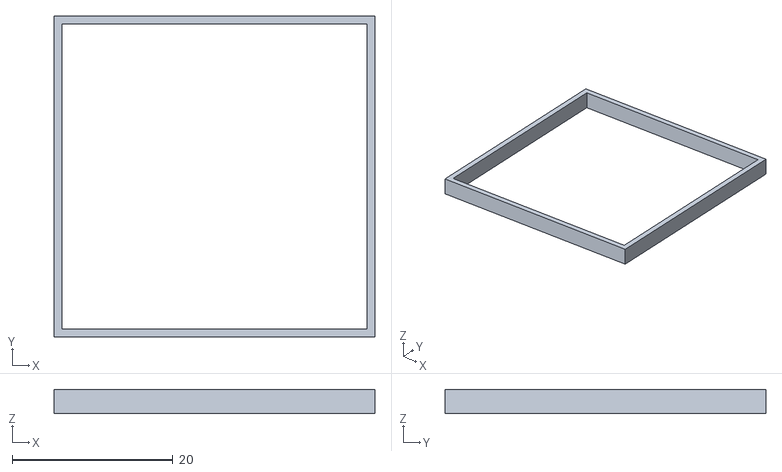
[picture p17: CAD file, 2016-08-11]
calibration/outer_square.stl
40.0 x 40.0 x 3.00
