alephobjects/taz-toolhead-javelin/first_print/lulzbot_taz_dual-extruder_keychain_text.stl

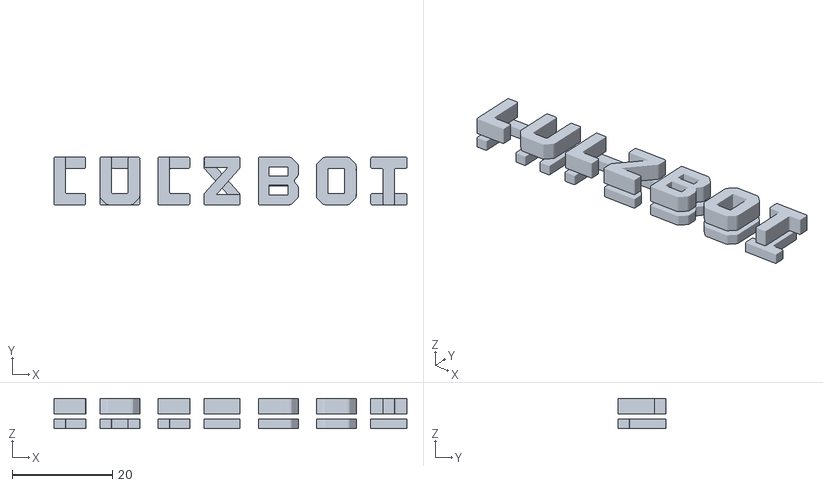
[picture p18: CAD file, 2016-08-11]
first_print/lulzbot_taz_dual-extruder_keychain_text.stl
70.4 x 9.51 x 6.00
