alephobjects/taz-toolhead-javelin/jigs/40mm_fan_50mm_cut_jig.fcstd

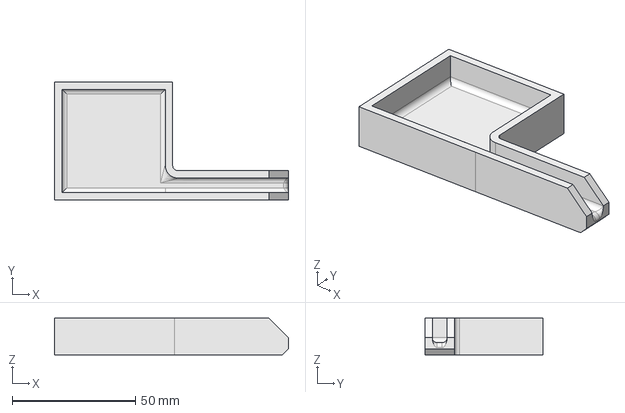
[picture p19: CAD file, 2016-08-11]
jigs/40mm_fan_50mm_cut_jig.fcstd
95.0 x 48.0 x 15.0 mm
