alephobjects/taz-toolhead-javelin/novelties/2_color_prints/dice/die_dots.stl

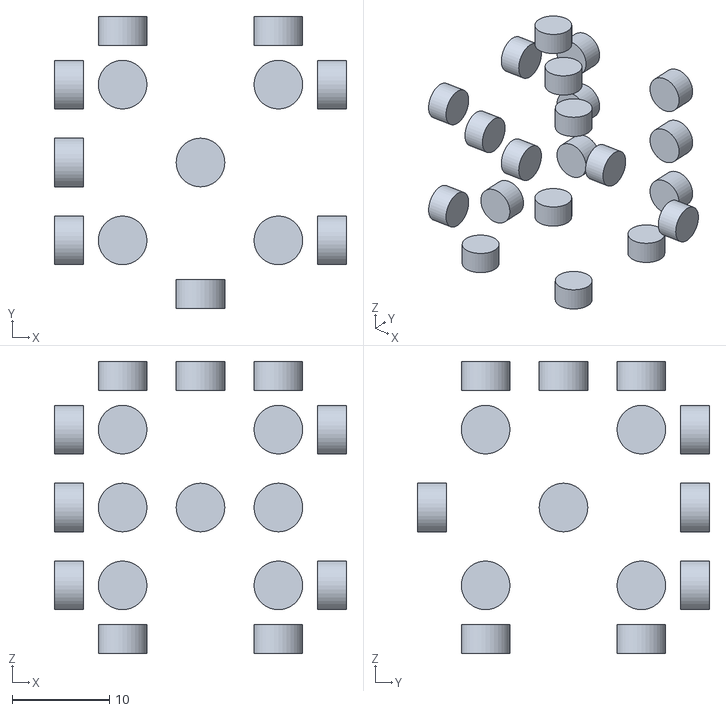
[picture p20: CAD file, 2016-08-11]
novelties/2_color_prints/dice/die_dots.stl
30.0 x 30.0 x 30.0
