alephobjects/taz-toolhead-javelin/novelties/2_color_prints/panda/PandaWhiteAligned.stl

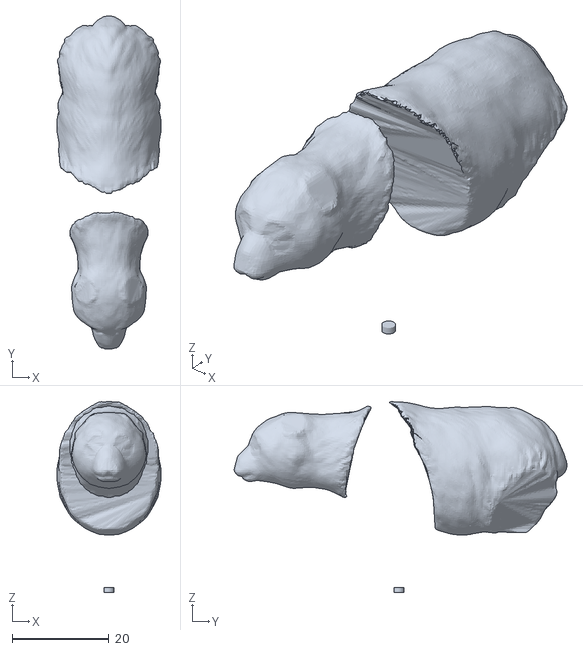
[picture p21: CAD file, 2016-08-11]
novelties/2_color_prints/panda/PandaWhiteAligned.stl
21.5 x 68.7 x 39.4
