alephobjects/taz-toolhead-javelin/novelties/attic/gear_box_support.stl

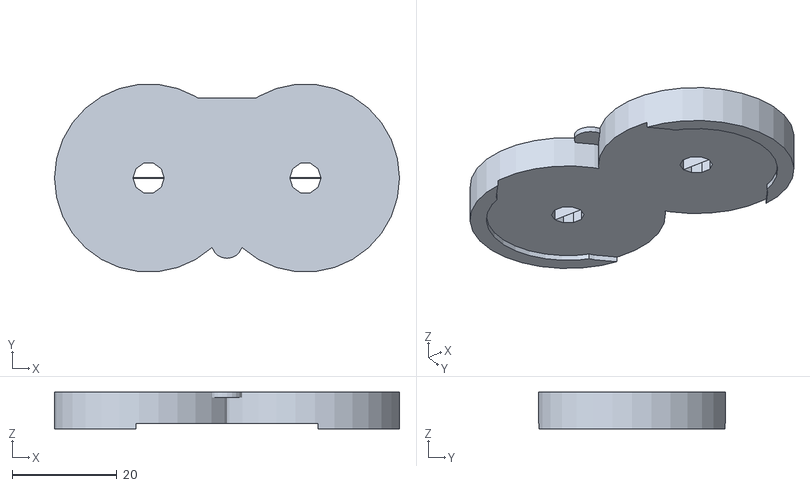
[picture p22: CAD file, 2016-08-11]
novelties/attic/gear_box_support.stl
66.0 x 35.8 x 7.00
