alephobjects/taz-toolhead-javelin/novelties/second_material_support_prints/print_in_place_gears/gear_box.stl

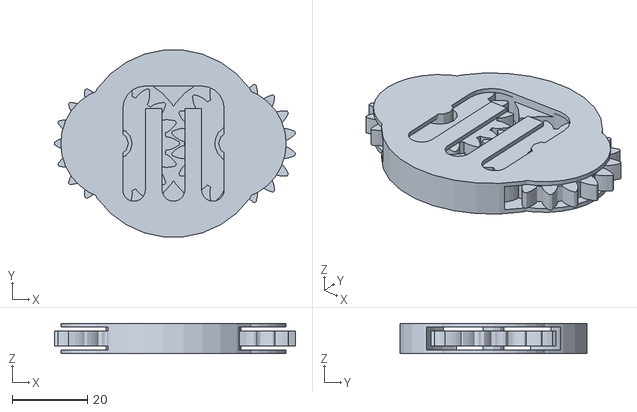
[picture p23: CAD file, 2016-08-11]
novelties/second_material_support_prints/print_in_place_gears/gear_box.stl
64.1 x 49.7 x 8.00
