alephobjects/taz-toolhead-javelin/production_docs/setup-guide/working/die_body.stl

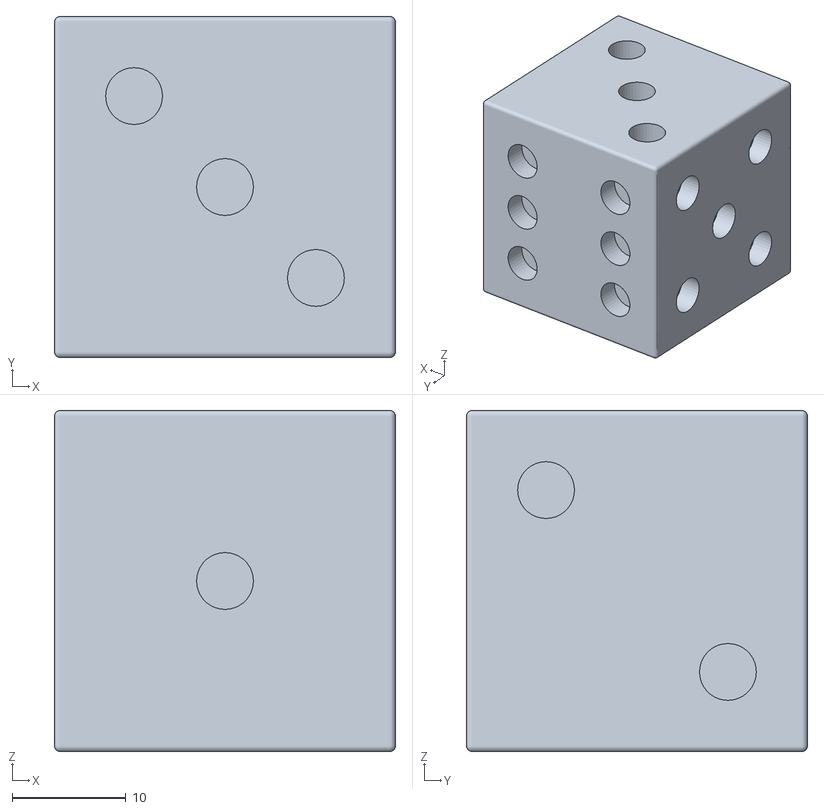
[picture p24: CAD file, 2016-08-11]
production_docs/setup-guide/working/die_body.stl
30.0 x 30.0 x 30.0
