alephobjects/taz-toolhead-javelin/production_parts/machined_parts/hexagon_mount_plate_v2.0.step

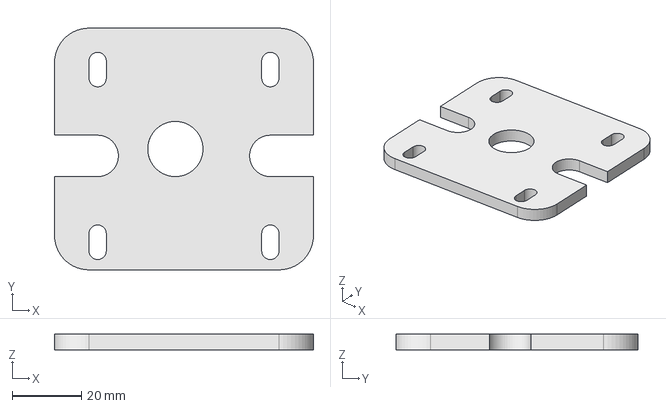
[picture p25: CAD file, 2016-08-11]
production_parts/machined_parts/hexagon_mount_plate_v2.0.step
75.0 x 70.0 x 4.50 mm
