alephobjects/taz-toolhead-javelin/production_parts/machined_parts/lower_bracket/lower_bracket_dual_v1.1.fcstd

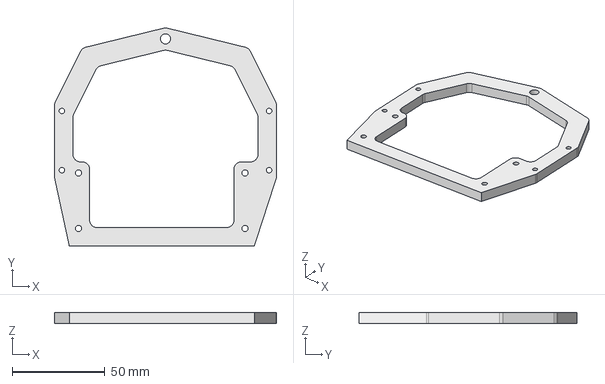
[picture p26: CAD file, 2016-08-11]
production_parts/machined_parts/lower_bracket/lower_bracket_dual_v1.1.fcstd
120.0 x 117.9 x 6.00 mm
