alephobjects/taz-toolhead-javelin/production_parts/printed_parts/40mm_fan_duct/40mm_fan_duct_v0.5.stl

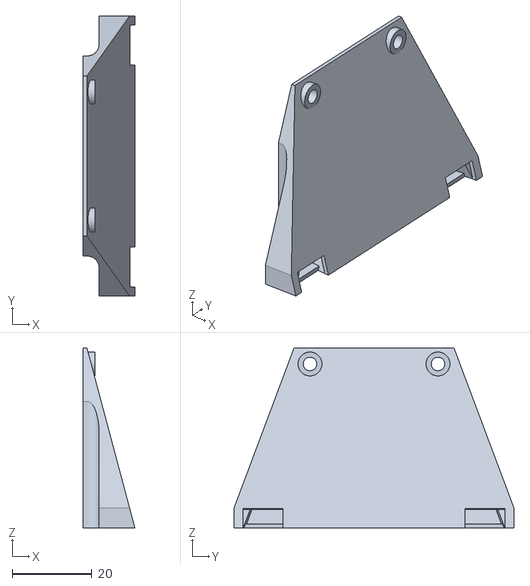
[picture p27: CAD file, 2016-08-11]
production_parts/printed_parts/40mm_fan_duct/40mm_fan_duct_v0.5.stl
13.0 x 70.0 x 45.0
