alephobjects/taz-toolhead-javelin/production_parts/printed_parts/dual_extruder_v2.0_mount/dual_extruder-2.0_mount_V1.1.stl

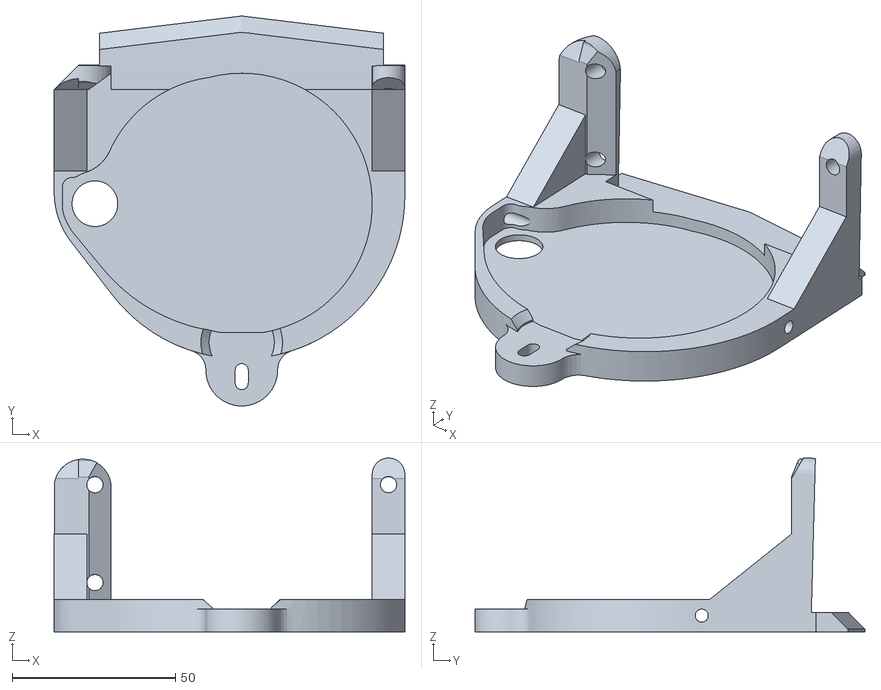
[picture p28: CAD file, 2016-08-11]
production_parts/printed_parts/dual_extruder_v2.0_mount/dual_extruder-2.0_mount_V1.1.stl
107.5 x 119.5 x 53.3
