alephobjects/taz-toolhead-javelin/production_parts/printed_parts/Javelin_flex_plate/ATTIC/javelin_flex_plate_V1.4.FCStd

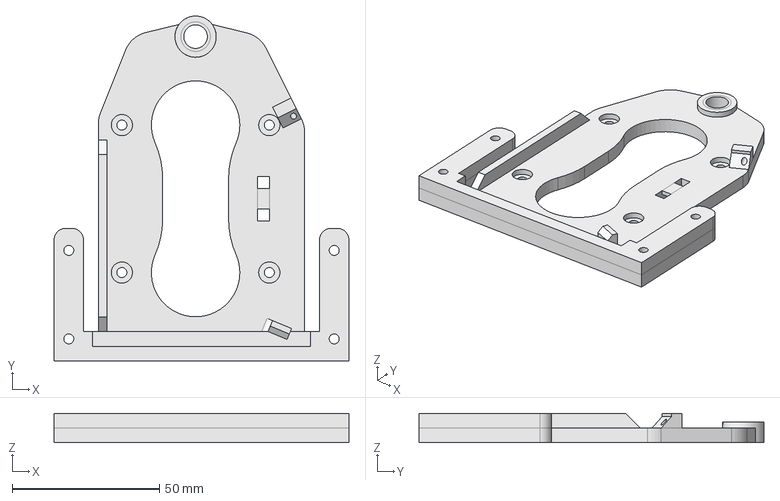
[picture p29: CAD file, 2016-08-11]
production_parts/printed_parts/Javelin_flex_plate/ATTIC/javelin_flex_plate_V1.4.FCStd
100.0 x 117.0 x 10.0 mm
