alephobjects/taz-toolhead-javelin/production_parts/printed_parts/Javelin_flex_plate/javelin_flex_plate_V1.5.FCStd

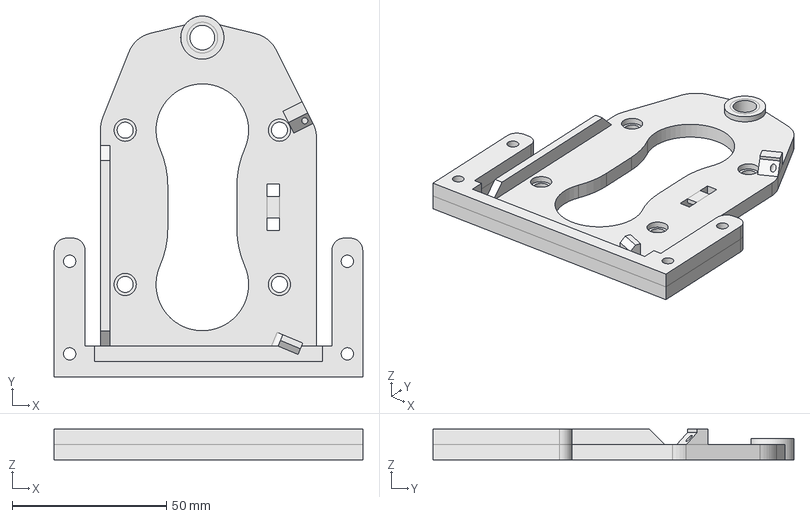
[picture p30: CAD file, 2016-08-11]
production_parts/printed_parts/Javelin_flex_plate/javelin_flex_plate_V1.5.FCStd
100.0 x 117.0 x 10.0 mm
