alephobjects/taz-toolhead-javelin/test_parts/source/lower_plate_0.3.stl

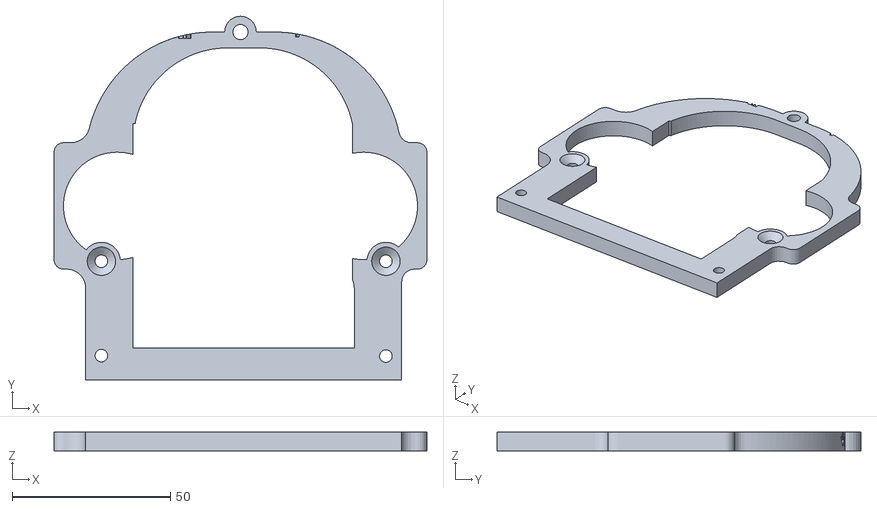
[picture p31: CAD file, 2016-08-11]
test_parts/source/lower_plate_0.3.stl
118.0 x 115.0 x 6.00
