alephobjects/taz-toolhead-javelin/test_parts/stl/HexHotEnd1.stl

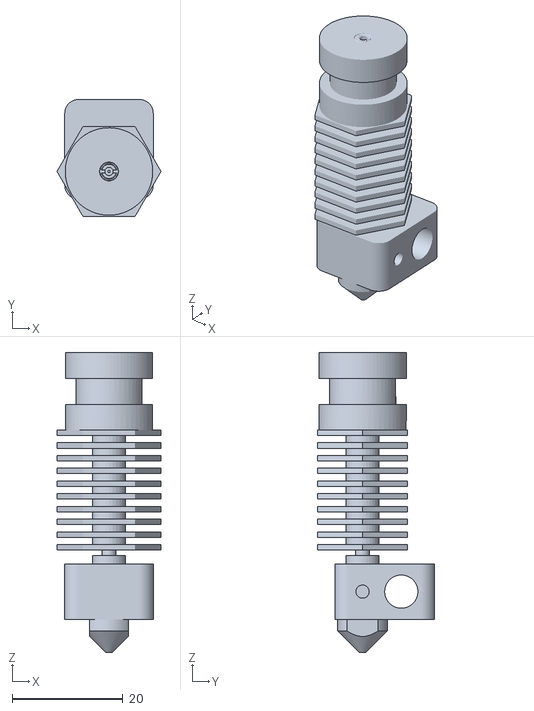
[picture p32: CAD file, 2016-08-11]
test_parts/stl/HexHotEnd1.stl
18.8 x 21.1 x 54.2
