alephobjects/taz-toolhead-javelin/calibration/inner_square.stl

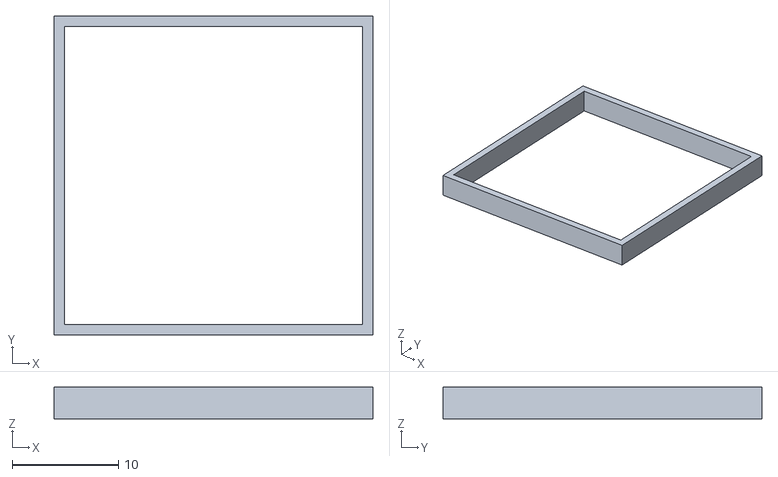
[picture p33: CAD file, 2016-08-11]
calibration/inner_square.stl
30.0 x 30.0 x 3.00
