alephobjects/taz-toolhead-javelin/first_print/lulzbot_taz_dual-extruder_keychain_body.stl

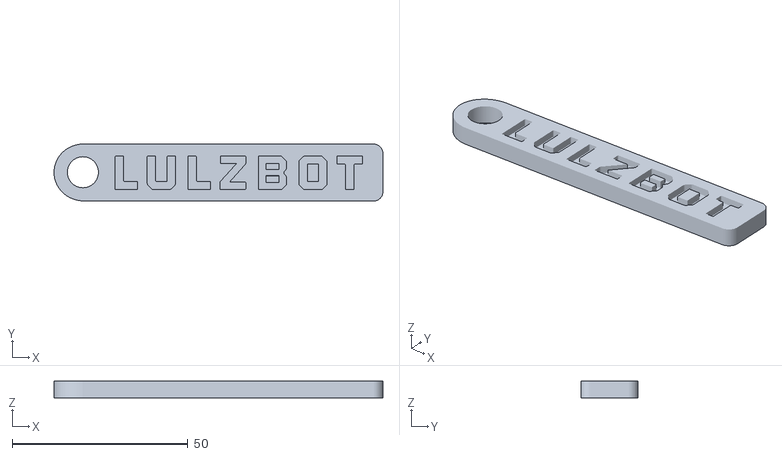
[picture p34: CAD file, 2016-08-11]
first_print/lulzbot_taz_dual-extruder_keychain_body.stl
93.7 x 16.3 x 4.80
