alephobjects/taz-toolhead-javelin/jigs/motor_130mm_heatshrink_110mm_cut_jig.fcstd

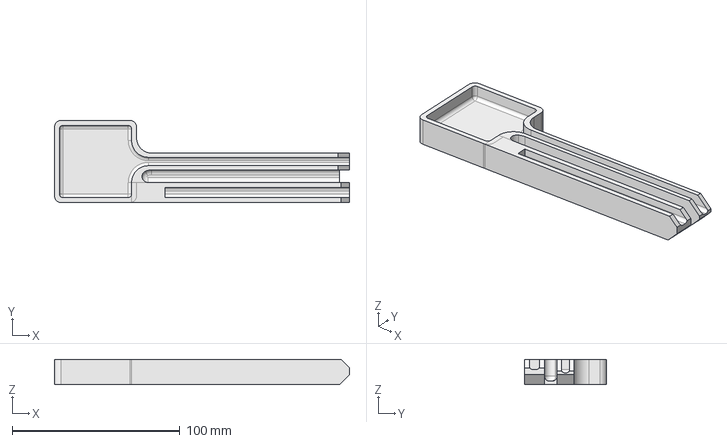
[picture p35: CAD file, 2016-08-11]
jigs/motor_130mm_heatshrink_110mm_cut_jig.fcstd
176.0 x 49.0 x 15.0 mm
