alephobjects/taz-toolhead-javelin/novelties/2_color_prints/panda/test.amf

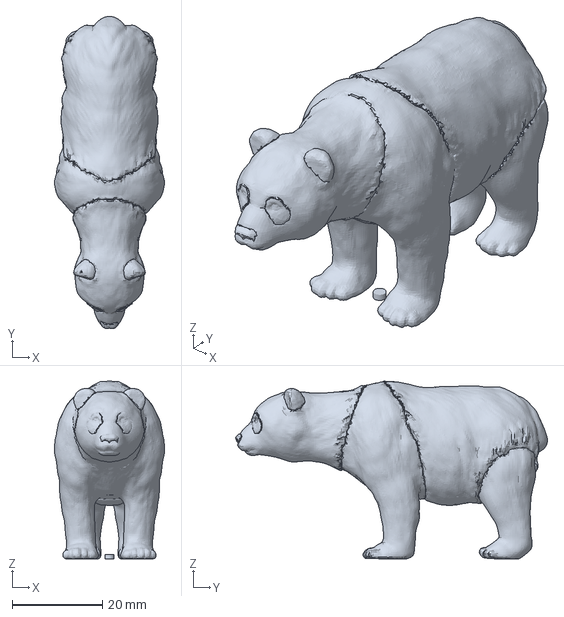
[picture p36: CAD file, 2016-08-11]
novelties/2_color_prints/panda/test.amf
24.4 x 69.2 x 39.4 mm
