alephobjects/taz-toolhead-javelin/production_parts/printed_parts/dual_extruder_v2.0_mount/dual_extruder-2.0_mount_V1.1-x2.stl

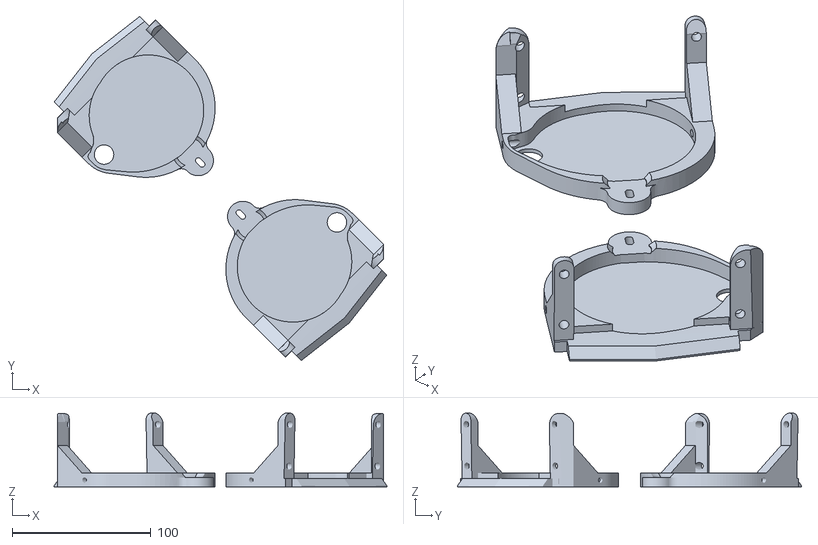
[picture p37: CAD file, 2016-08-11]
production_parts/printed_parts/dual_extruder_v2.0_mount/dual_extruder-2.0_mount_V1.1-x2.stl
239.8 x 248.0 x 53.3
