alephobjects/taz-toolhead-javelin/test_parts/stl/Motor_NEMA17_42BYGHW811.stl

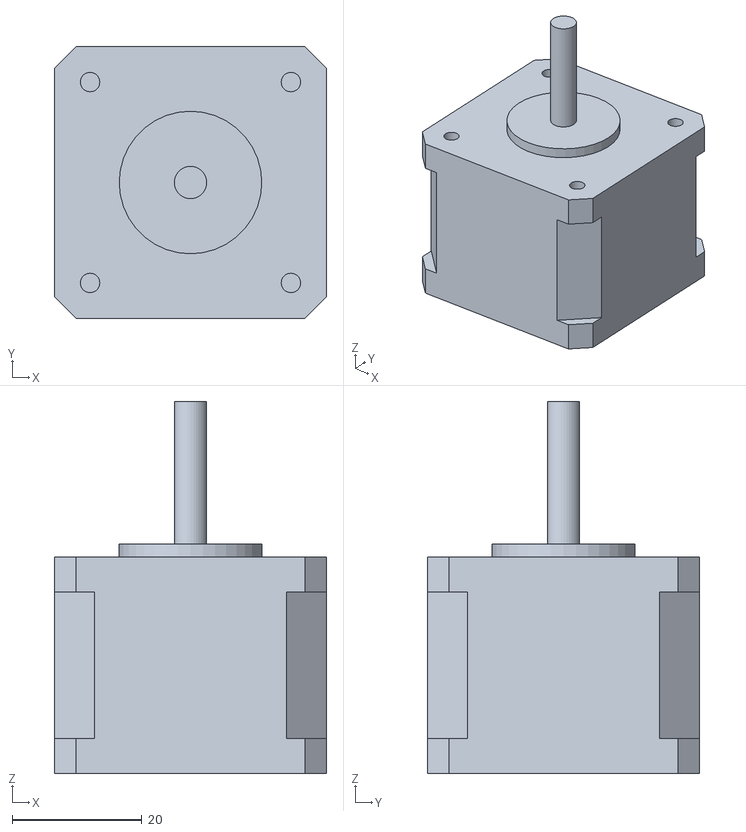
[picture p38: CAD file, 2016-08-11]
test_parts/stl/Motor_NEMA17_42BYGHW811.stl
42.0 x 42.0 x 57.4
