alephobjects/taz-toolhead-javelin/jigs/microblower_55mm_cut_jig.fcstd

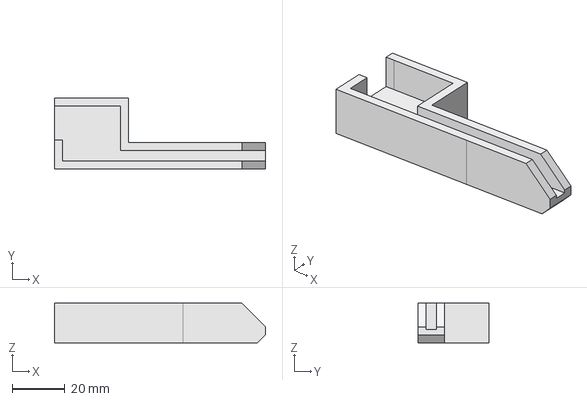
[picture p39: CAD file, 2016-08-11]
jigs/microblower_55mm_cut_jig.fcstd
80.0 x 27.0 x 15.0 mm
