alephobjects/taz-toolhead-javelin/novelties/2_color_prints/panda/PandaBlack.stl

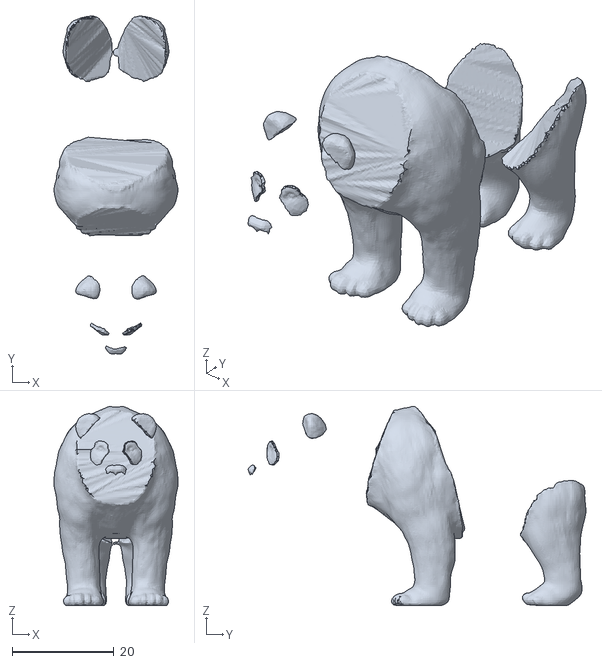
[picture p40: CAD file, 2016-08-11]
novelties/2_color_prints/panda/PandaBlack.stl
24.4 x 66.6 x 39.3
