alephobjects/taz-toolhead-javelin/test_parts/corner_plate_0.1.step

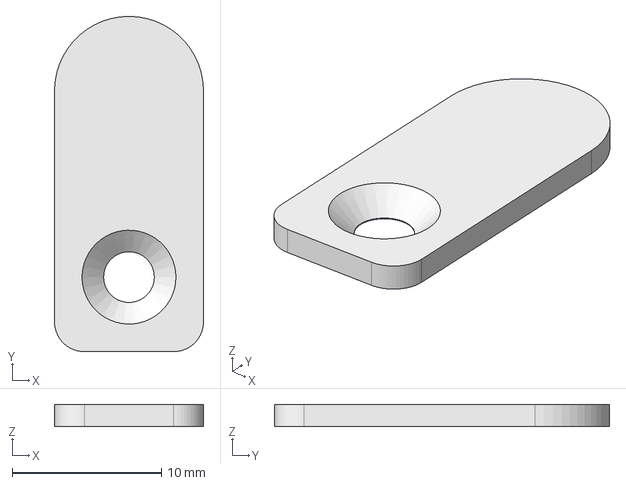
[picture p41: CAD file, 2016-08-11]
test_parts/corner_plate_0.1.step
10.0 x 22.5 x 1.50 mm
