alephobjects/taz-toolhead-javelin/test_parts/source/40mm_fan_duct_v0.3.fcstd

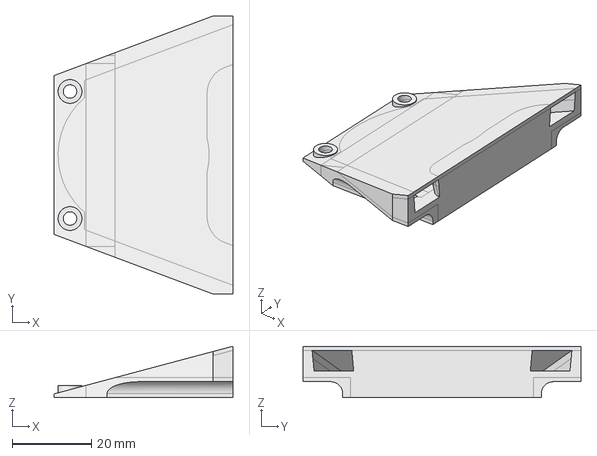
[picture p42: CAD file, 2016-08-11]
test_parts/source/40mm_fan_duct_v0.3.fcstd
45.0 x 70.0 x 13.0 mm
