alephobjects/taz-toolhead-javelin/test_parts/source/40mm_fan_duct_0.3.stl

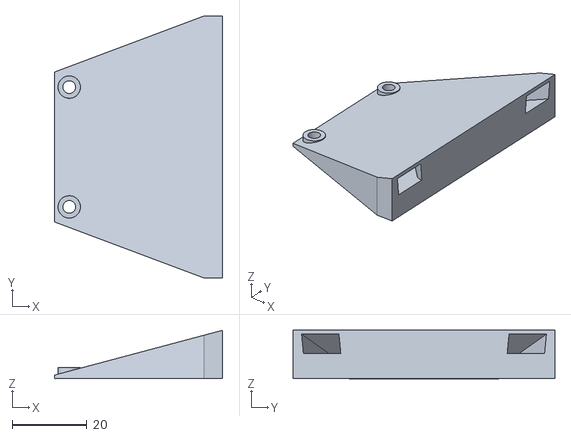
[picture p43: CAD file, 2016-08-11]
test_parts/source/40mm_fan_duct_0.3.stl
45.0 x 70.0 x 13.0
