alephobjects/taz-toolhead-javelin/test_parts/source/40mm_fan_duct_0.2.stl

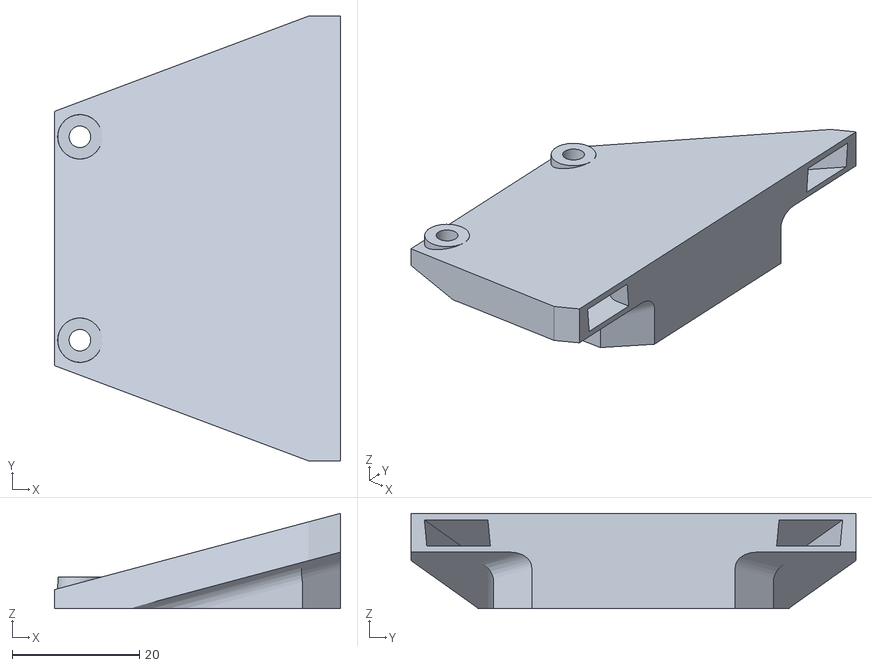
[picture p44: CAD file, 2016-08-11]
test_parts/source/40mm_fan_duct_0.2.stl
45.0 x 70.0 x 15.0
