alephobjects/taz-toolhead-javelin/test_parts/source/dual_extruder-2.0_mount_V1.0.stl

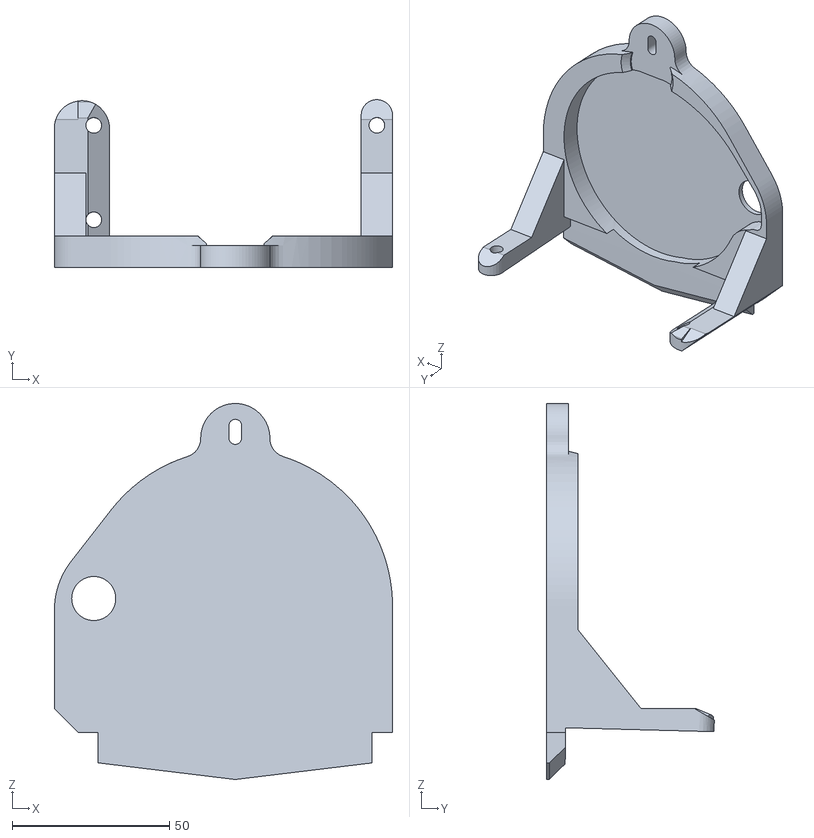
[picture p45: CAD file, 2016-08-11]
test_parts/source/dual_extruder-2.0_mount_V1.0.stl
107.5 x 53.3 x 119.5
