alephobjects/taz-toolhead-javelin/test_parts/source/lower_plate_0.2.stl

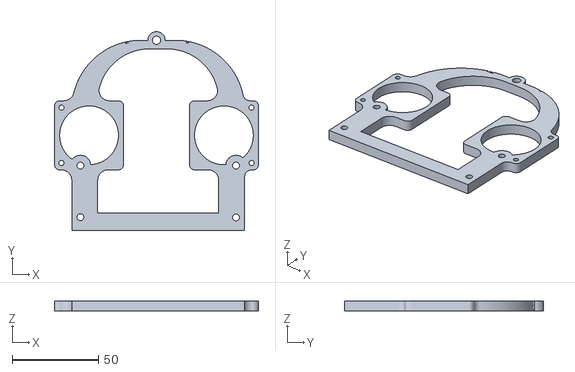
[picture p46: CAD file, 2016-08-11]
test_parts/source/lower_plate_0.2.stl
118.0 x 115.0 x 6.00
