alephobjects/taz-toolhead-javelin/test_parts/source/corner_plate.stl

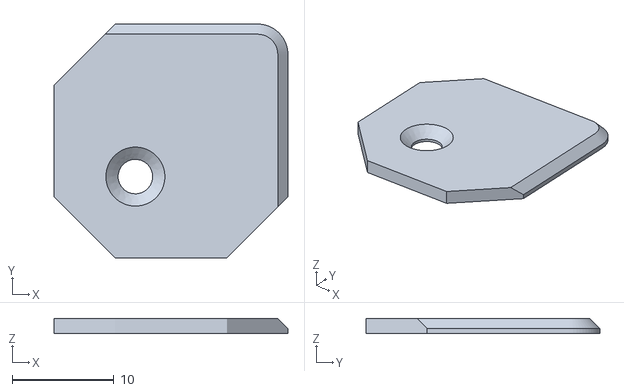
[picture p47: CAD file, 2016-08-11]
test_parts/source/corner_plate.stl
23.0 x 23.0 x 1.50
