alephobjects/taz-toolhead-javelin/test_parts/source/40mm_fan.fcstd

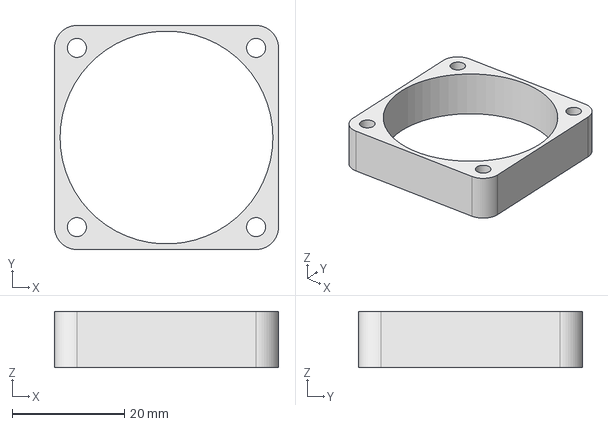
[picture p48: CAD file, 2016-08-11]
test_parts/source/40mm_fan.fcstd
40.0 x 40.0 x 10.0 mm
