alephobjects/taz-toolhead-javelin/test_parts/source/lower_plate_0.1.stl

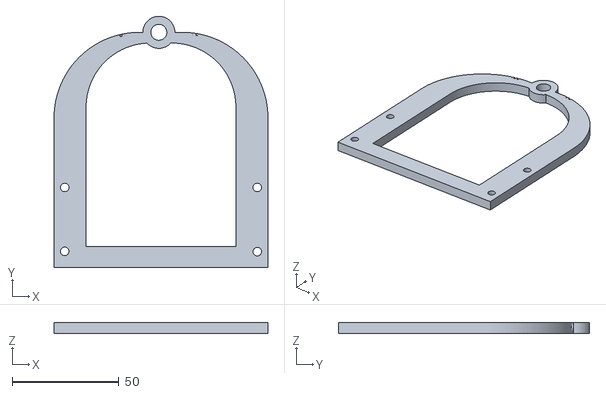
[picture p49: CAD file, 2016-08-11]
test_parts/source/lower_plate_0.1.stl
100.0 x 117.5 x 5.00
