alephobjects/taz-toolhead-javelin/test_parts/source/dual_extruder_2.0_flex_plate_V1.0.FCStd

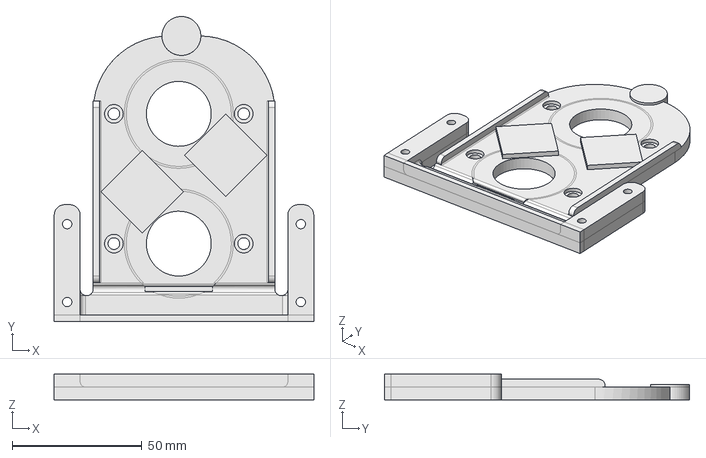
[picture p50: CAD file, 2016-08-11]
test_parts/source/dual_extruder_2.0_flex_plate_V1.0.FCStd
100.0 x 117.5 x 10.0 mm
