alephobjects/taz-toolhead-javelin/test_parts/source/40mm_fan_duct_0.1.stl

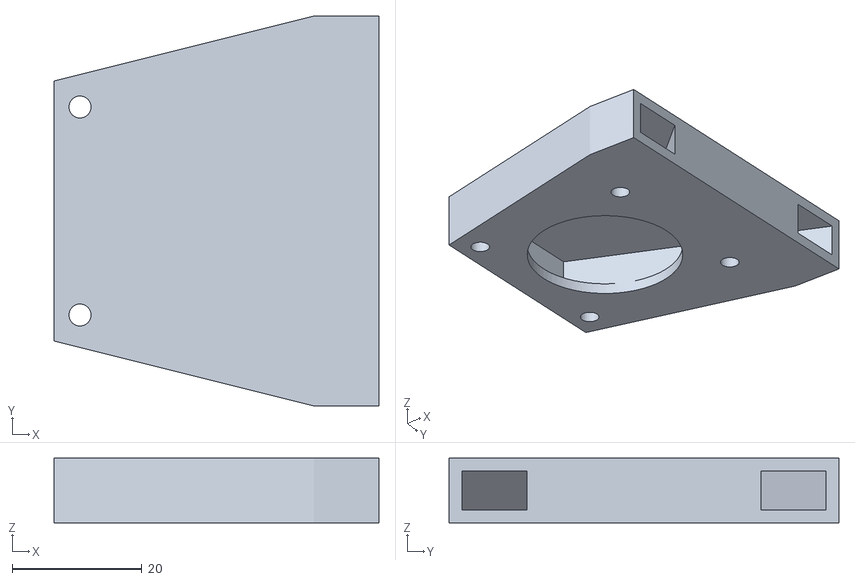
[picture p51: CAD file, 2016-08-11]
test_parts/source/40mm_fan_duct_0.1.stl
50.0 x 60.0 x 10.0
