alephobjects/taz-toolhead-javelin/(list of files, cad)

Other CAD files:
production_parts/printed_parts/40mm_fan_duct/ATTIC/40mm_fan_duct_v0.5.stl
production_parts/machined_parts/lower_bracket/lower_bracket_v0.3.step
test_parts/lower_bracket_v0.3.step
test_parts/source/lower_bracket_0.1.fcstd
test_parts/hex_mount_v0.2.stl
test_parts/hexagon_mount_plate_v2.fcstd
test_parts/source/javelin_flex_plate_V1.2.FCStd
test_parts/source/lower_plate_0.4.stl
test_parts/source/bed_finger_dual.fcstd
test_parts/source/40mm_fan_duct_0.4.stl
test_parts/source/40mm_fan_duct_v0.5.stl
test_parts/source/lower_bracket_0.3.fcstd
test_parts/source/bed_finger_dual_v0.2.stl
first_print/source_files/lulzbot_taz_dual-extruder_keychain.blend
jigs/40mm_fan_50mm_cut_jig.stl
jigs/microblower_55mm_cut_jig.stl
jigs/motor130mm_heatshrink_110mm_cut_jig.stl
production_docs/setup-guide/ATTIC/t-nut_jig_0.2.stl
production_parts/printed_parts/Javelin_flex_plate/ATTIC/javelin_flex_plate_V1.3.FCStd
production_parts/printed_parts/Javelin_flex_plate/ATTIC/javelin_flex_plate_V1.3.stl
production_parts/printed_parts/Javelin_flex_plate/ATTIC/javelin_flex_plate_V1.4.stl
production_parts/printed_parts/Javelin_flex_plate/javelin_flex_plate_V1.5.stl
production_parts/printed_parts/t-nut_holding_jig/ATTIC/t-nut_jig_0.2.stl
production_parts/printed_parts/t-nut_holding_jig/t-nut_jig_0.2-x9.stl
test_parts/hex_mount_v0.1.stl
test_parts/nut_jig.fcstd
test_parts/source/40mm_fan.stl
test_parts/source/40mm_fan_duct_v0.1.fcstd
test_parts/source/40mm_fan_duct_v0.2.fcstd
test_parts/source/dual_extruder-2.0_flex_plate_V1.0.stl
test_parts/source/javelin_flex_plate_V1.1.FCStd
test_parts/source/javelin_flex_plate_V1.1.stl
test_parts/source/javelin_flex_plate_V1.2.stl
test_parts/t-nut_jig.stl
test_parts/t-nut_jig_0.2.stl
