alephobjects/taz-toolhead-javelin/production_docs/setup-guide/ATTIC/Cura.png

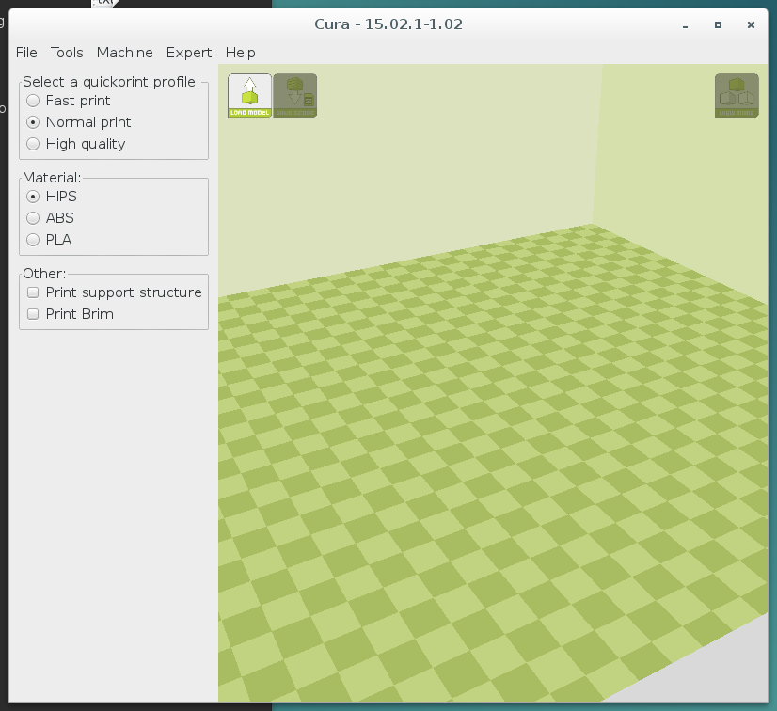
production_docs/setup-guide/ATTIC/Cura.png
