alephobjects/taz-toolhead-javelin/production_docs/setup-guide/ATTIC/die_body.jpg

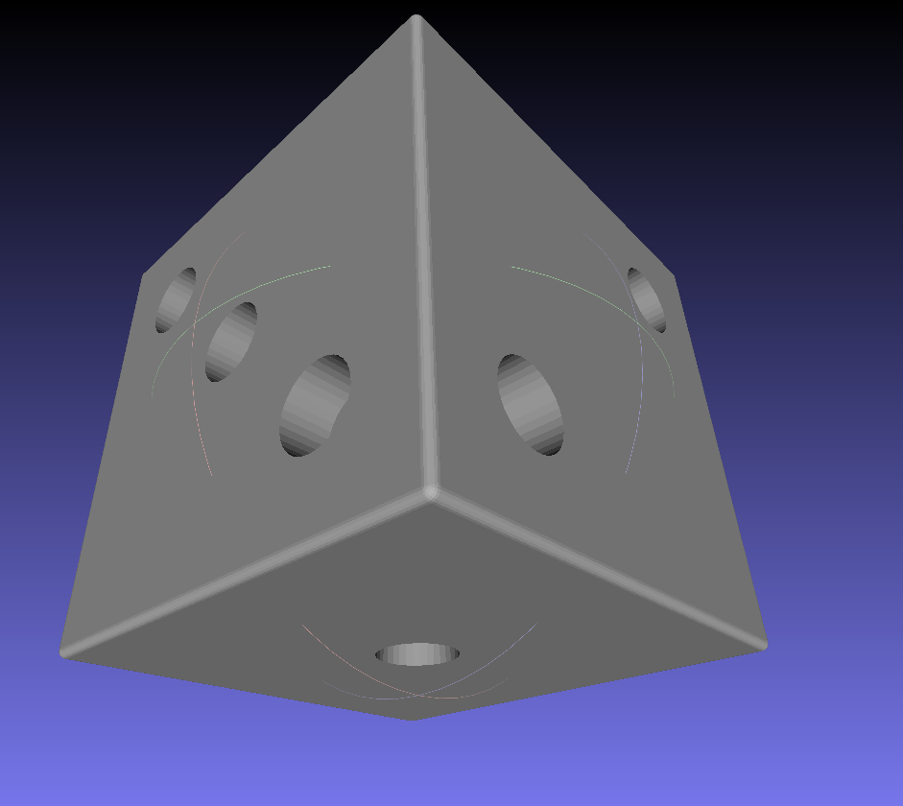
production_docs/setup-guide/ATTIC/die_body.jpg
