alephobjects/taz-toolhead-javelin/production_docs/setup-guide/ATTIC/die_dots.jpg

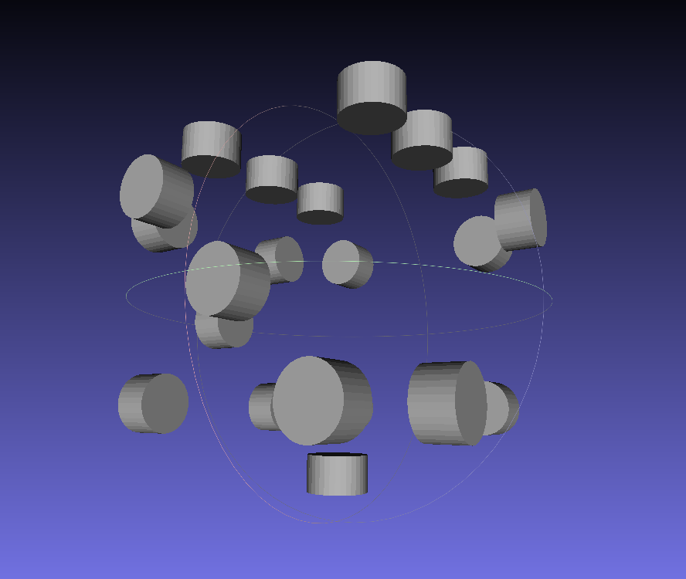
production_docs/setup-guide/ATTIC/die_dots.jpg
