alephobjects/taz-toolhead-javelin/production_docs/setup-guide/ATTIC/load-die_body.png

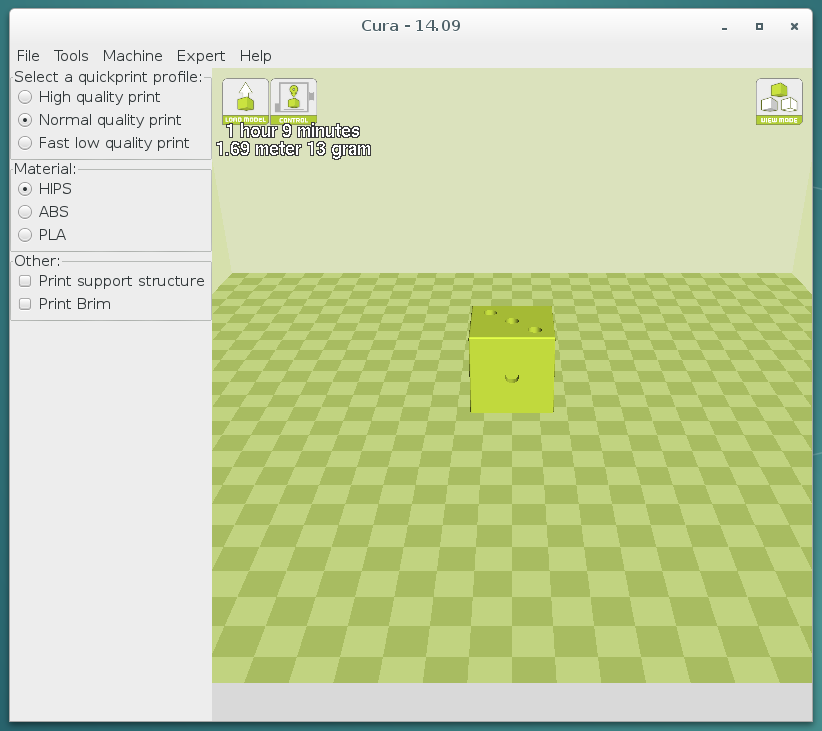
production_docs/setup-guide/ATTIC/load-die_body.png
