alephobjects/taz-toolhead-javelin/production_docs/setup-guide/ATTIC/load-die_dots.png

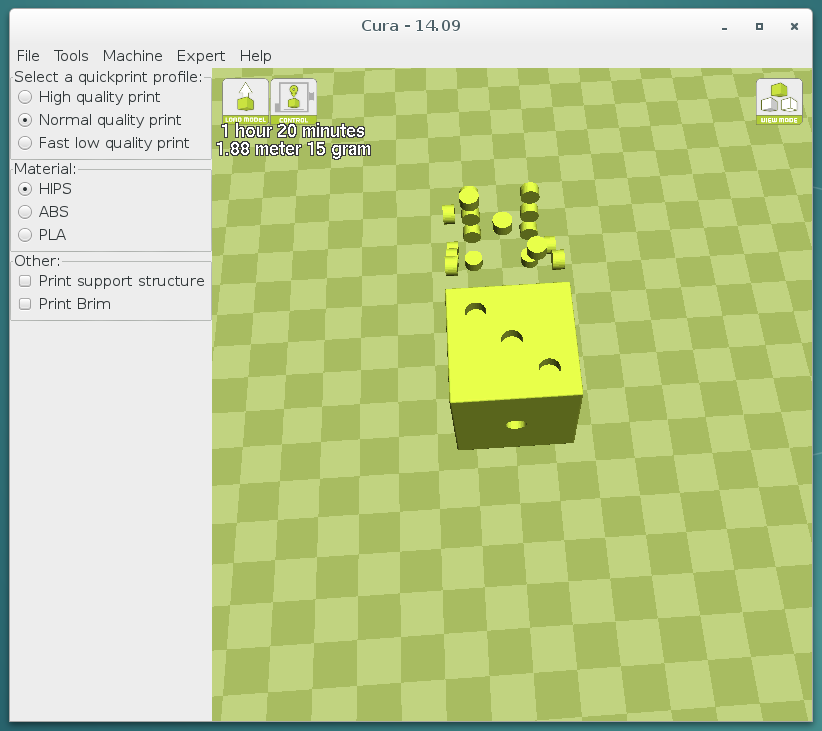
production_docs/setup-guide/ATTIC/load-die_dots.png
