alephobjects/taz-toolhead-javelin/production_docs/setup-guide/working/images/Configuration Wizard_015.png

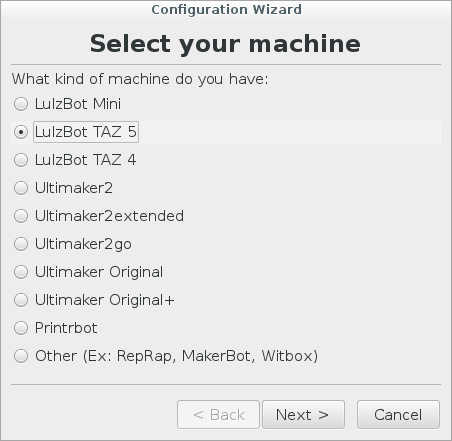
production_docs/setup-guide/working/images/Configuration Wizard_015.png
