alephobjects/taz-toolhead-javelin/production_docs/setup-guide/working/images/Configuration Wizard_017.png

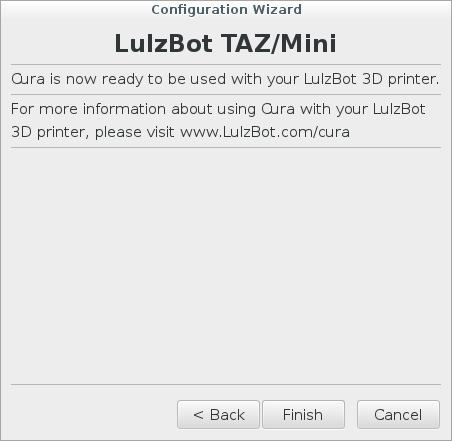
production_docs/setup-guide/working/images/Configuration Wizard_017.png
