alephobjects/taz-toolhead-javelin/production_docs/setup-guide/working/images/Cura - 15.02.1-1.02_034.png

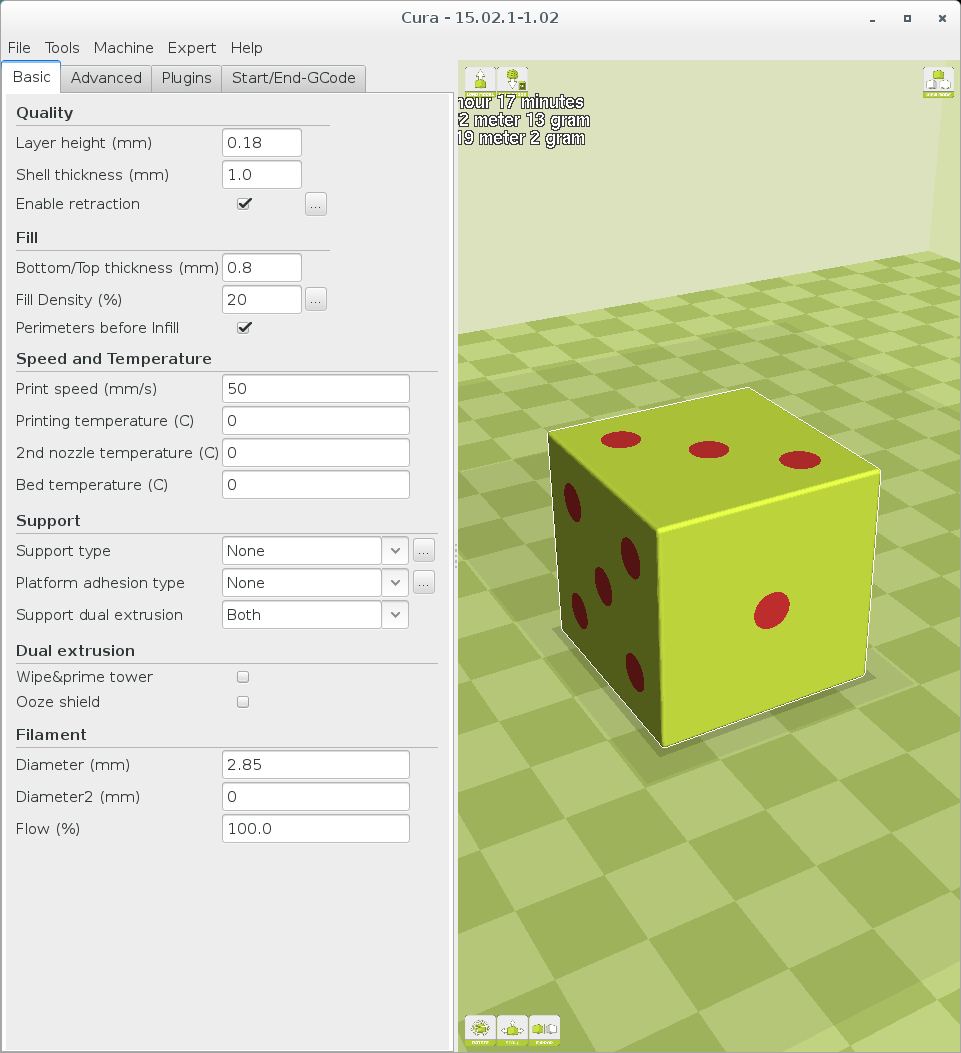
production_docs/setup-guide/working/images/Cura - 15.02.1-1.02_034.png
