alephobjects/taz-toolhead-javelin/production_docs/setup-guide/working/images/Menu_029.png

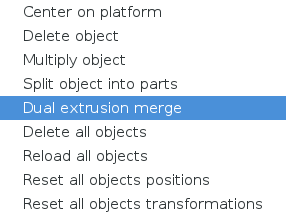
production_docs/setup-guide/working/images/Menu_029.png
