alephobjects/taz-toolhead-javelin/production_docs/setup-guide/working/images/Menu_033.png

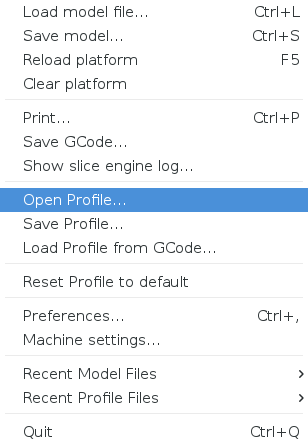
production_docs/setup-guide/working/images/Menu_033.png
