alephobjects/taz-toolhead-javelin/production_docs/setup-guide/working/images/Selection_013.png

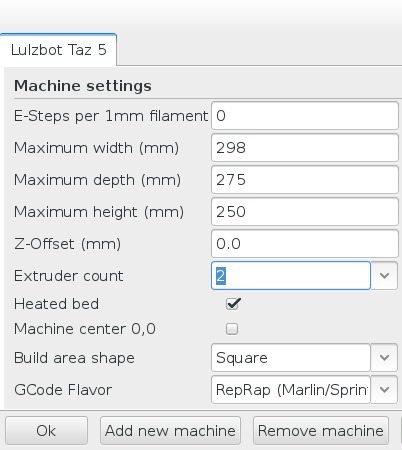
production_docs/setup-guide/working/images/Selection_013.png
