alephobjects/taz-toolhead-javelin/production_docs/setup-guide/working/images/Selection_021.png

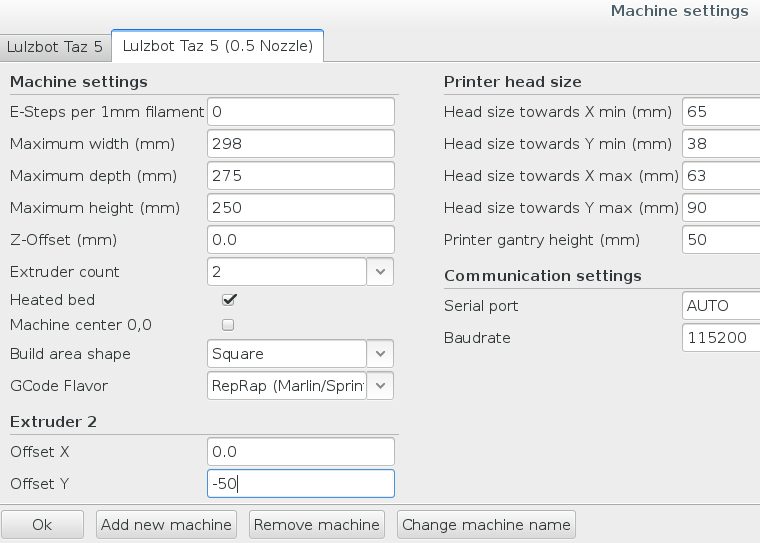
production_docs/setup-guide/working/images/Selection_021.png
