alephobjects/taz-toolhead-javelin/production_docs/setup-guide/working/images/Selection_022.png

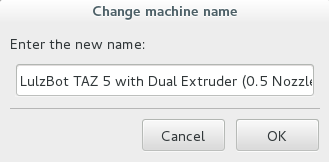
production_docs/setup-guide/working/images/Selection_022.png
