alephobjects/taz-toolhead-javelin/production_docs/setup-guide/working/images/Selection_030.png

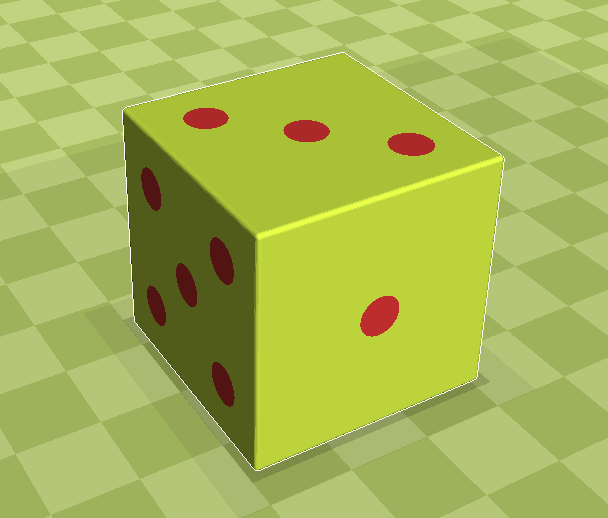
production_docs/setup-guide/working/images/Selection_030.png
