alephobjects/taz-toolhead-javelin/production_docs/setup-guide/working/images/Selection_040-1.png

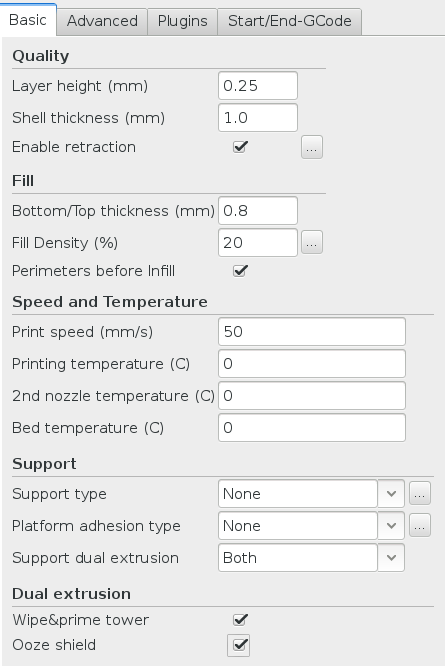
production_docs/setup-guide/working/images/Selection_040-1.png
