alephobjects/taz-toolhead-javelin/photos/dissolvable_support_test/IMG_20160115_160633843.jpg

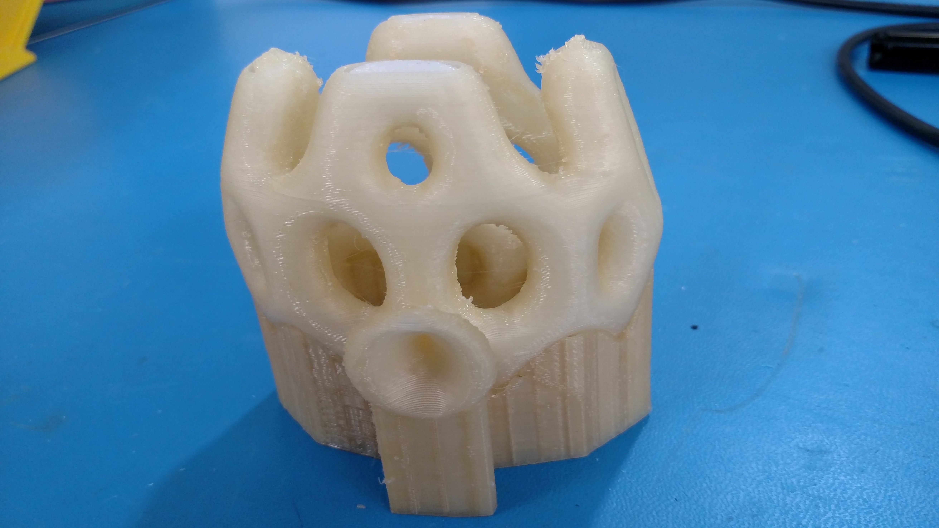
photos/dissolvable_support_test/IMG_20160115_160633843.jpg
