alephobjects/taz-toolhead-javelin/photos/Test die/DSC_0007.JPG

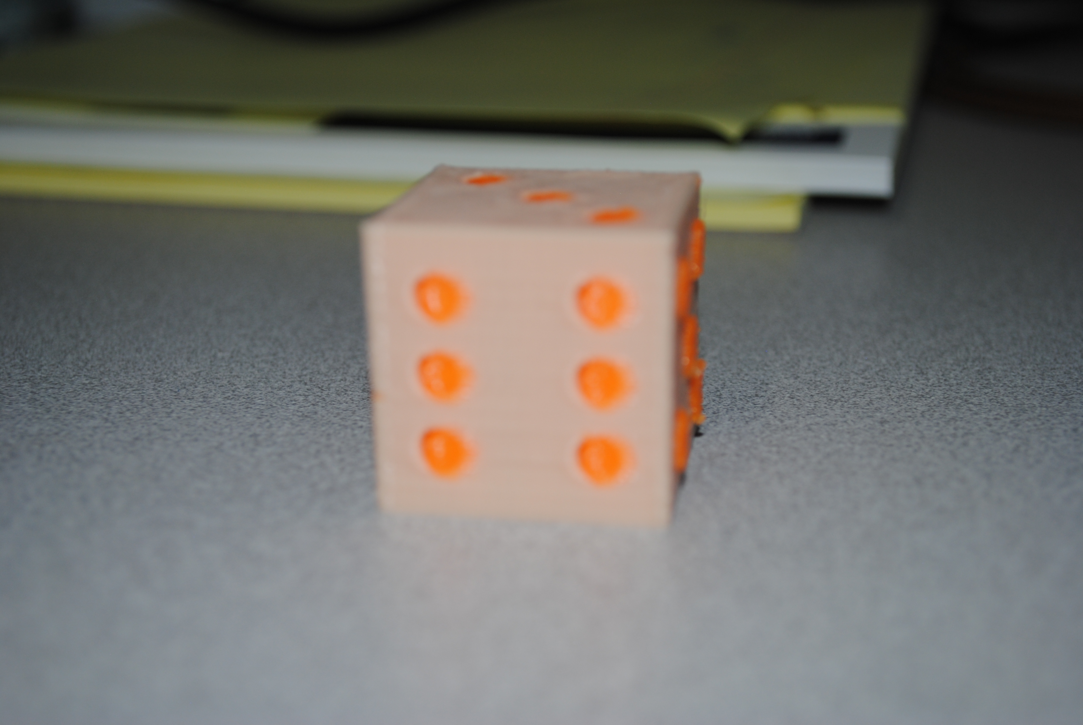
photos/Test die/DSC_0007.JPG
