alephobjects/taz-toolhead-javelin/photos/Test die/DSC_0008.JPG

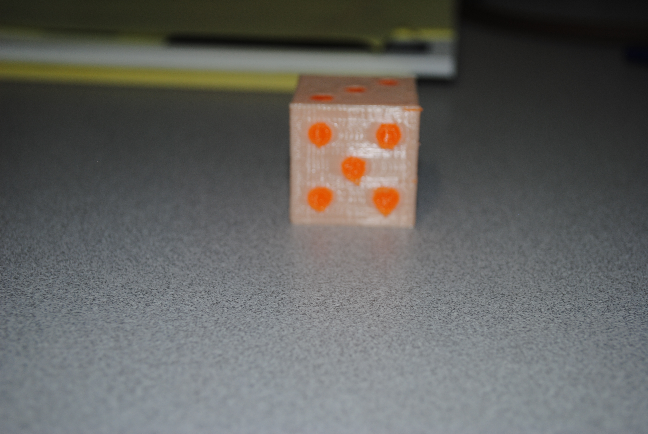
photos/Test die/DSC_0008.JPG
