alephobjects/taz-toolhead-javelin/photos/test pandas/DSC_0002.JPG

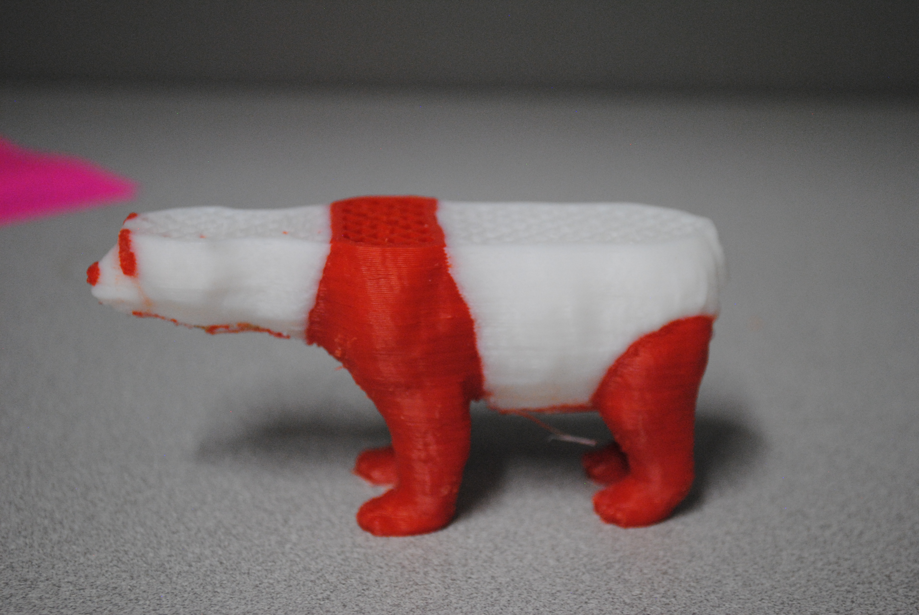
photos/test pandas/DSC_0002.JPG
