alephobjects/taz-toolhead-javelin/photos/test pandas/DSC_0006.JPG

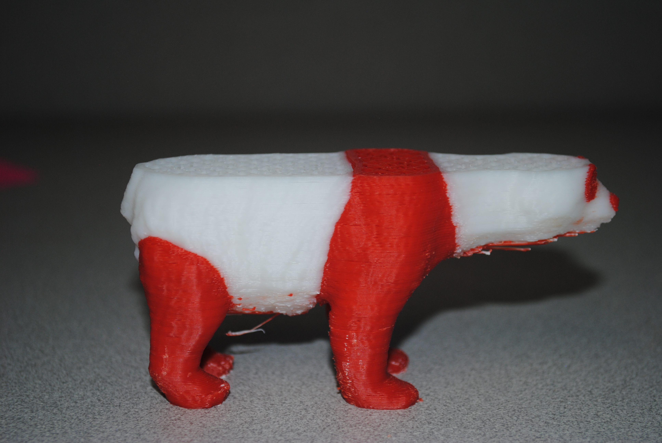
photos/test pandas/DSC_0006.JPG
