alephobjects/taz-toolhead-javelin/photos/test pandas/DSC_0007.JPG

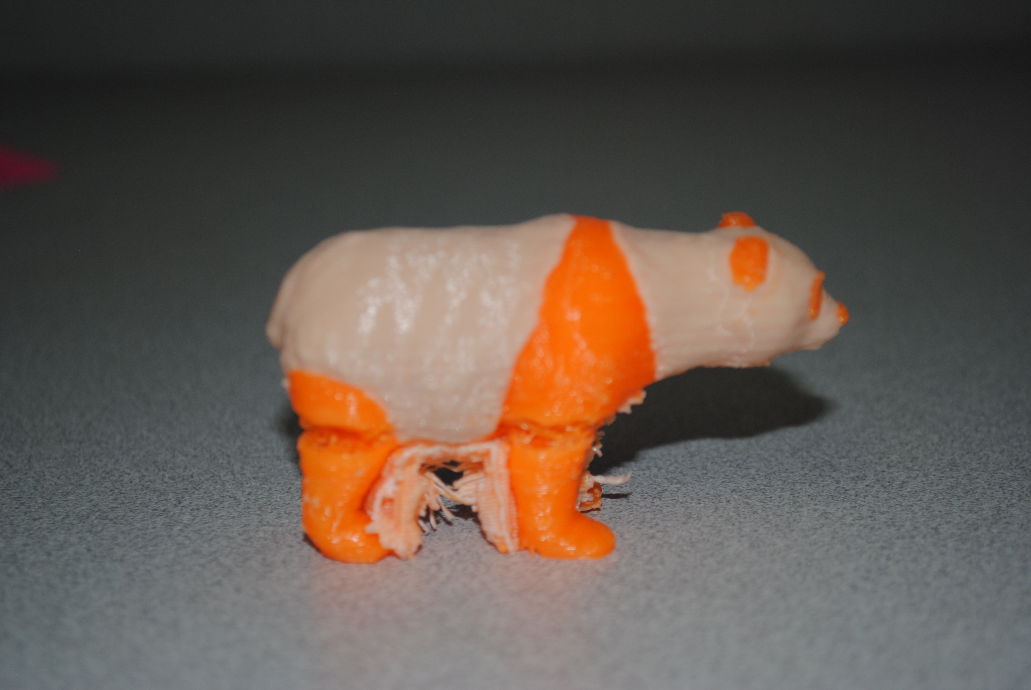
photos/test pandas/DSC_0007.JPG
