alephobjects/taz-toolhead-javelin/photos/test pandas/DSC_0008.JPG

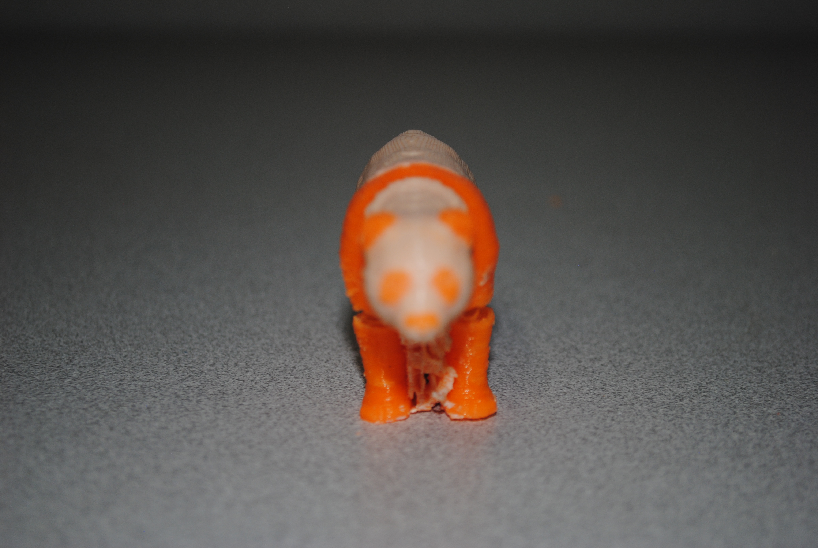
photos/test pandas/DSC_0008.JPG
