alephobjects/taz-toolhead-javelin/photos/test pandas/DSC_0009.JPG

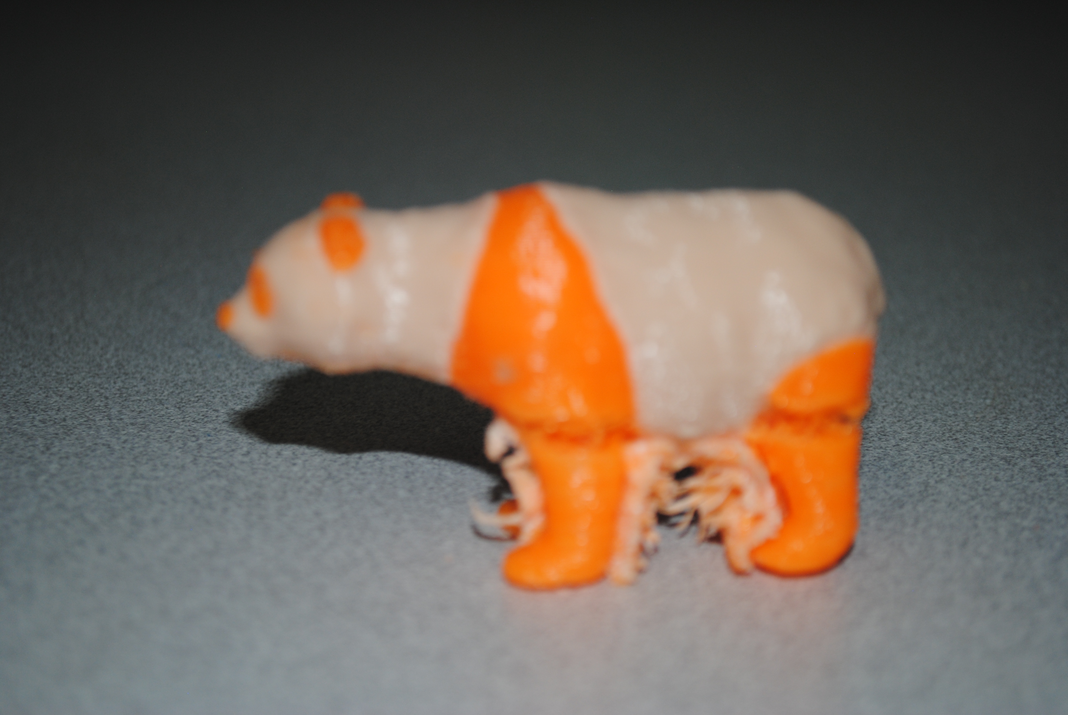
photos/test pandas/DSC_0009.JPG
