alephobjects/taz-toolhead-javelin/test_parts/corner_plate_0.1.PDF

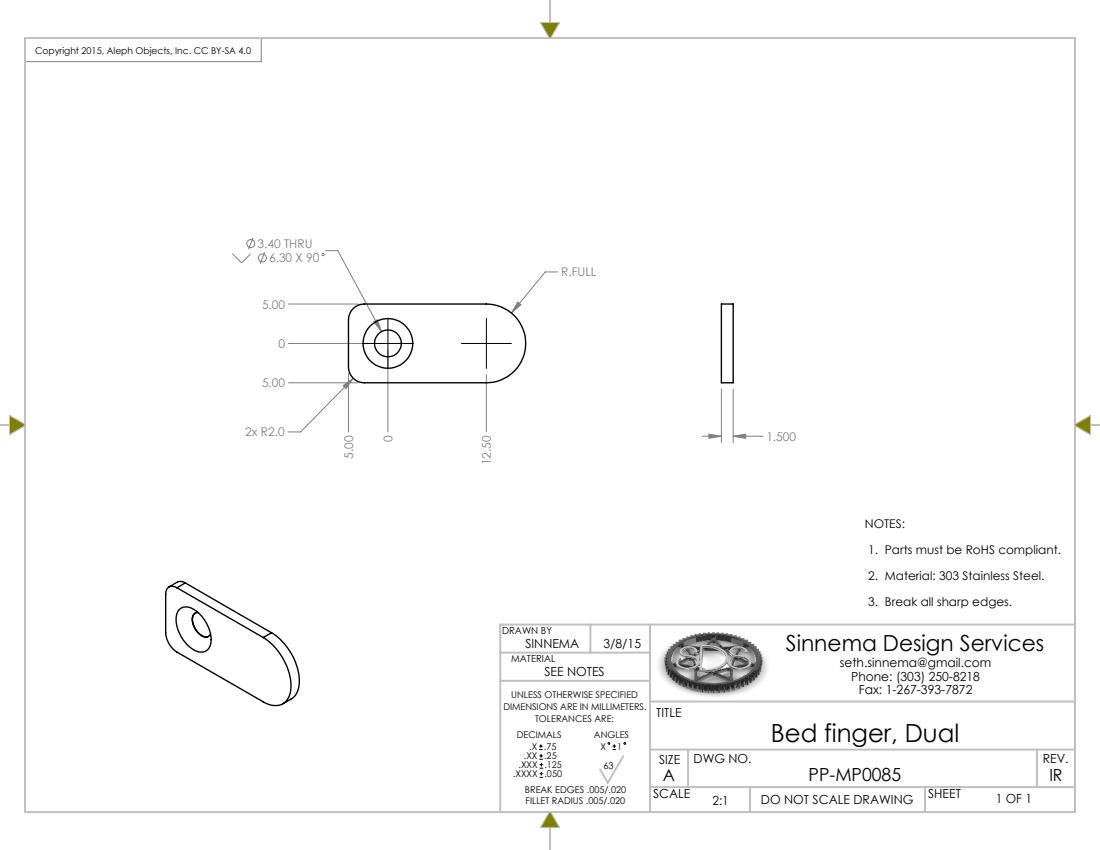
[picture p107: page 1]
3.40 THRU 6.30 X 90; SEE NOTES; DRAWN BY; SCALE; 1 OF 1 SHEET; DWG NO.; REV.

Copyright 2015, Aleph Objects, Inc. CC BY-SA 4.0

NOTES:
1. Parts must be RoHS compliant.
2. Material: 303 Stainless Steel.
3. Break all sharp edges.
Sinnema Design Services

seth.sinnema@gmail.com
Phone: (303) 250-8218
Fax: 1-267-393-7872
Bed finger, Dual
DO NOT SCALE DRAWING

UNLESS OTHERWISE SPECIFIED
DIMENSIONS ARE IN MILLIMETERS.
TOLERANCES ARE:
DECIMALS
.XXX .125
.XXXX .050
BREAK EDGES .005/.020
FILLET RADIUS .005/.020
