alephobjects/taz-toolhead-javelin/test_parts/Dual_extruder_mount_plate_v2.PDF

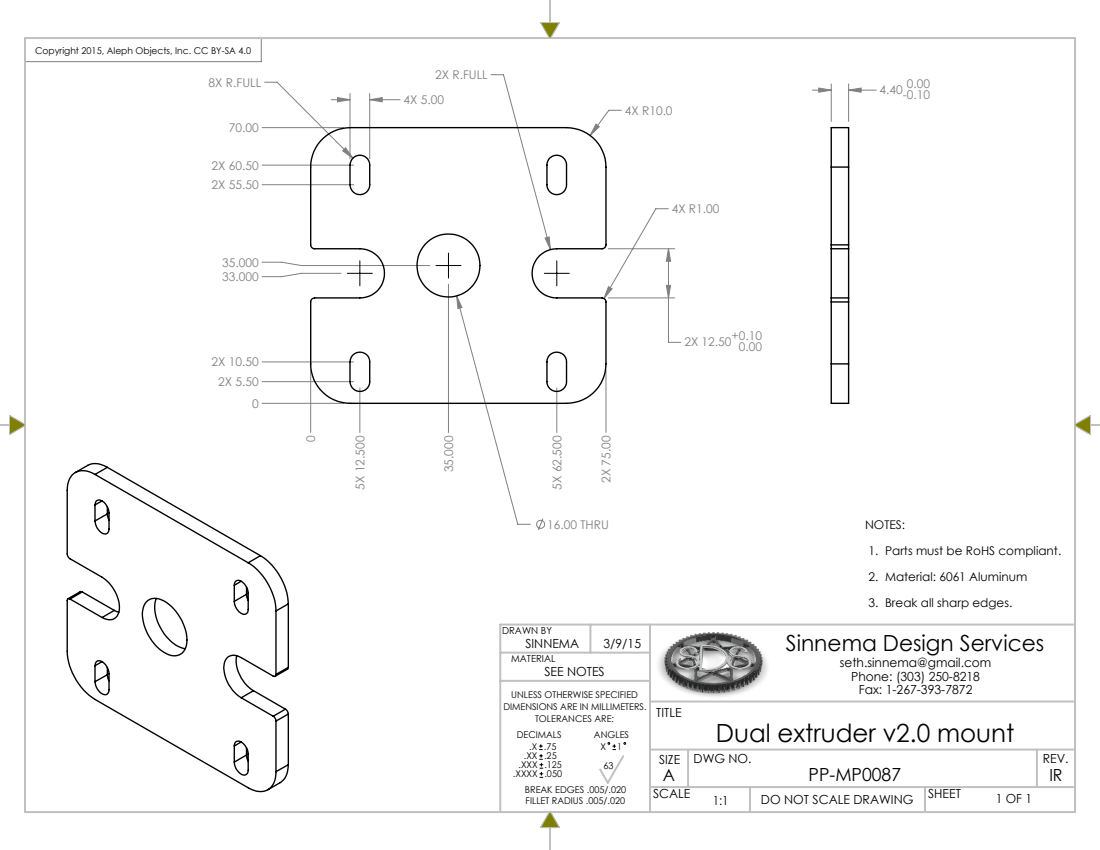
[picture p108: page 1]
16.00 THRU; 2X R.FULL 8X R.FULL; SEE NOTES; DRAWN BY; SCALE; 1 OF 1 SHEET; DWG NO.; REV.

Copyright 2015, Aleph Objects, Inc. CC BY-SA 4.0

NOTES:
1. Parts must be RoHS compliant.
2. Material: 6061 Aluminum
3. Break all sharp edges.
Sinnema Design Services

seth.sinnema@gmail.com
Phone: (303) 250-8218
Fax: 1-267-393-7872

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

TITLE
Dual extruder v2.0 mount

DO NOT SCALE DRAWING
