alephobjects/taz-toolhead-javelin/production_parts/machined_parts/lower_bracket/lower_bracket_dual_v1.1.pdf

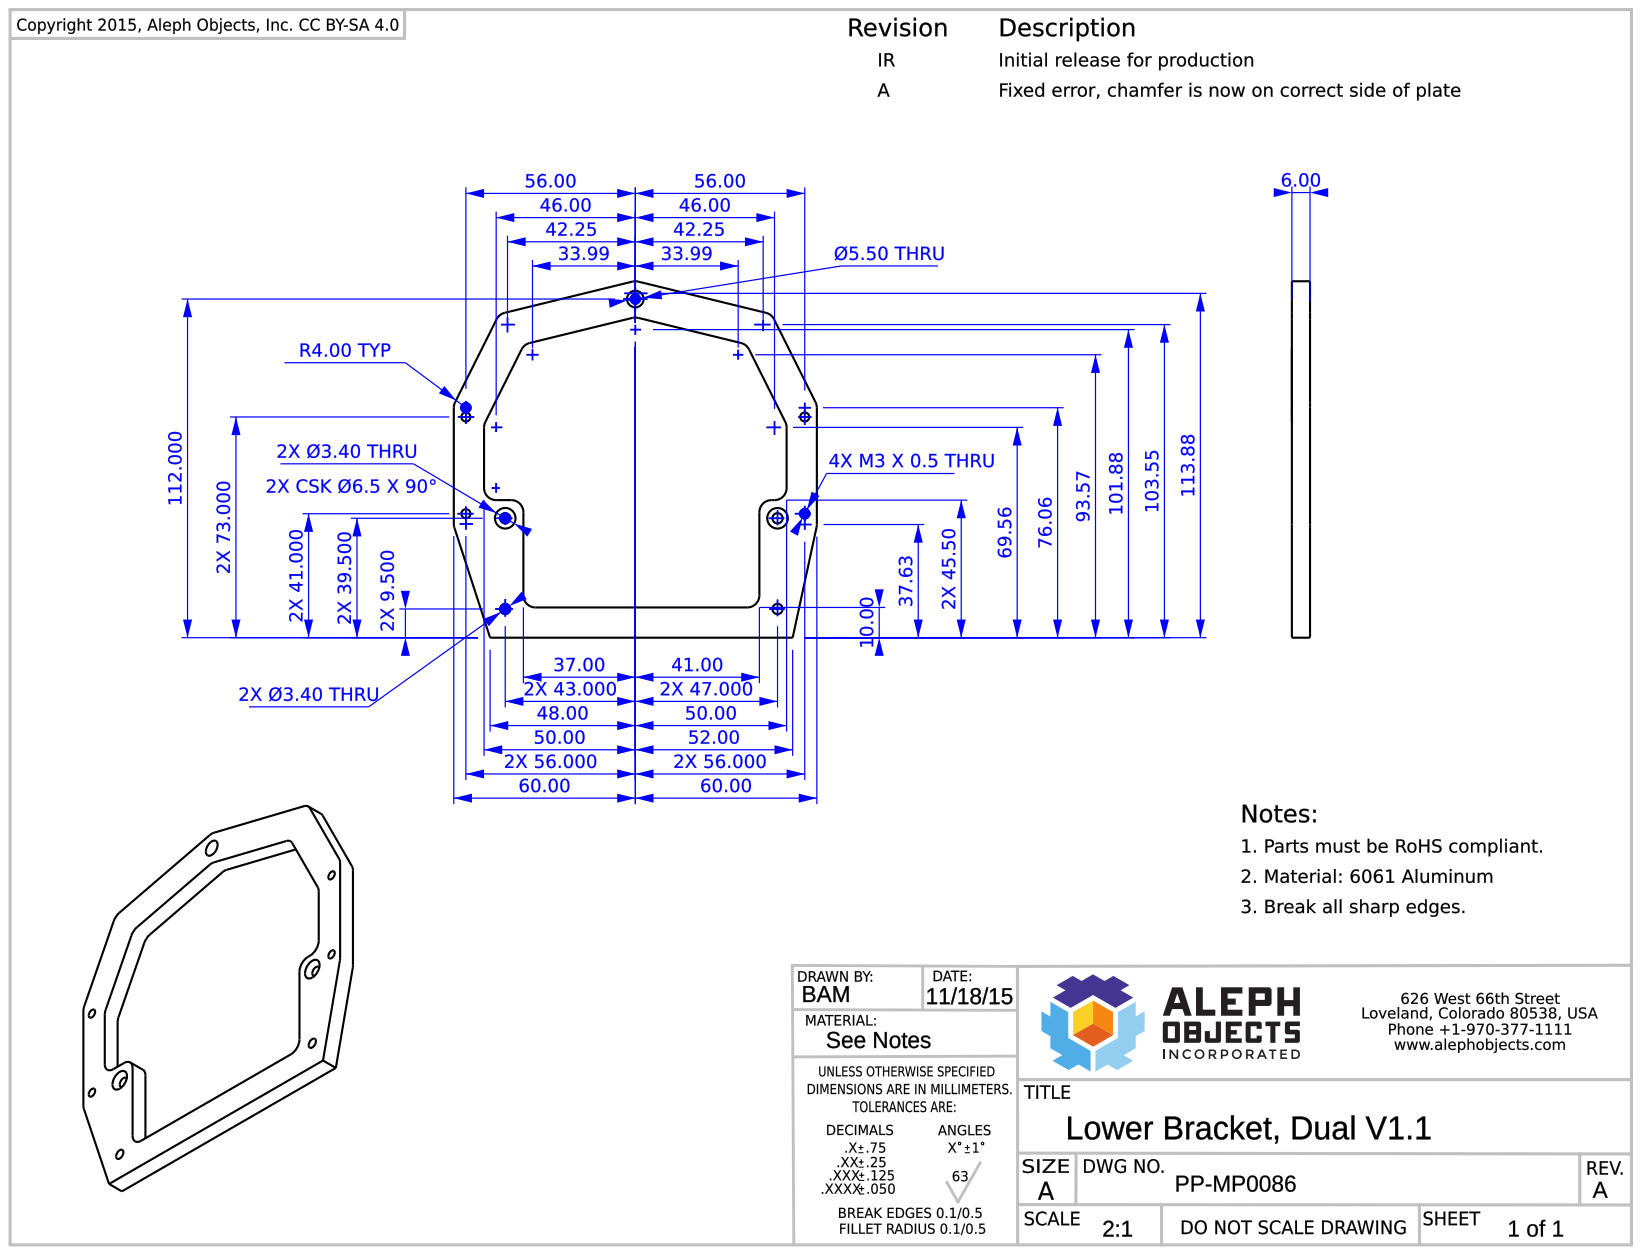
[picture p109: page 1]
