alephobjects/taz-toolhead-javelin/(commit log)

2016-08-11 Another attempt at fixing the random submodule
    [Configuration.h, Configuration_adv.h]
2016-08-11 Add Olivebranch Marlin firmware
    [Configuration.h, Configuration_adv.h, Marlin Logo.dxf, Menu Plans.xlsx]
2016-08-11 updated rrd listed parts
    [javelin_v2.0D_BOM_MO16-0006.ods]
2016-08-11 Added gitmodules setting to make the marlin repos submodules. The Marlin_Olivebranch dir needs to be fixed
2016-08-16 formatted BoM
    [javelin_v2.0D_BOM.ods]
2016-08-16 copied BoM for MO16-0056
    [javelin_v2.0D_BOM_MO16-0056.ods]
2016-08-16 fixed EL-MS0205 typo on MO16-0056 BoM
    [javelin_v2.0D_BOM_MO16-0056.ods]
2016-08-17 added PO information to MO16-0056
    [javelin_v2.0D_BOM_MO16-0056.ods]
2016-08-18 added stock notes on MO16-0056
    [javelin_v2.0D_BOM_MO16-0056.ods]
2016-08-18 updated BoM costing
    [javelin_v2.0D_BOM_MO16-0056.ods]
2016-08-19 added cost information to MO16-0056
    [javelin_v2.0D_BOM_MO16-0056.ods]
2016-08-22 highlighted BoM issue, updated PO information
    [javelin_v2.0D_BOM_MO16-0056.ods]
2016-08-22 Include 'v' in the version number to follow the new convention used by the makefiles
    [Configuration.h, Configuration_adv.h, Marlin Logo.dxf, Menu Plans.xlsx]
2016-08-23 Redo the Marlin submodule after the renaming took place
    [Configuration.h, Configuration_adv.h, Marlin Logo.dxf, Menu Plans.xlsx]
2016-09-14 added PO information
    [javelin_v2.0D_BOM_MO16-0056.ods]
2016-10-11 Release EL-HR0060rB BOM and drawing to project
2016-10-12 Add Multi-level BOM aka MBOM to project
    [Javelin _V2_MBOM.ods]
