alephobjects/taz-toolhead-javelin/photos/velociraptor_skull/IMG_0379.JPG

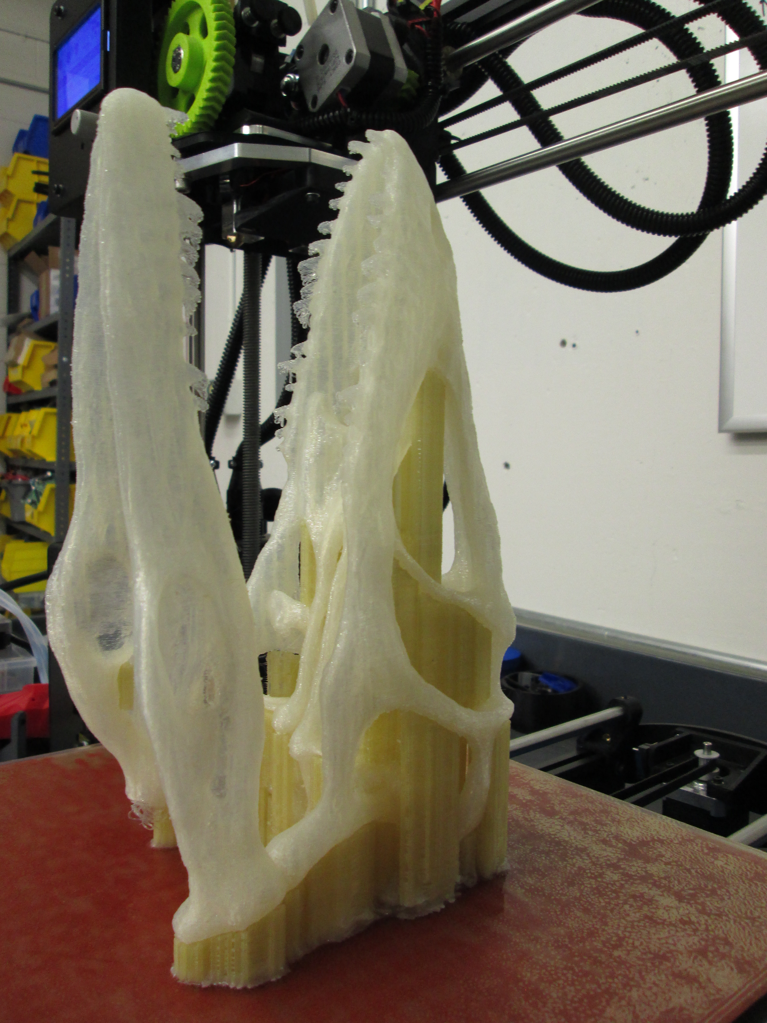
photos/velociraptor_skull/IMG_0379.JPG
